ob-f/OpenBot/README.md

<a href="https://www.openbot.org/" target="_blank">
  Banner
</a>

<h1 align="center"><a>Turning Smartphones into Robots</a></h1>

<p align="center">
   </a>
   </a>
   </a>
   </a>
   </a>
   </a>
   </a>
   </a>
</p>

<p align="center">
  <span>English</span> |
  <a href="README.zh-CN.md">简体中文</a> |
  <a href="README.de-DE.md">Deutsch</a> |
  <a href="README.fr-FR.md">Français</a> |
  <a href="README.es-ES.md">Español</a> |
  <a href="README.ko-KR.md">한국어</a>
</p>

OpenBot leverages smartphones as brains for low-cost robots. We have designed a small electric vehicle that costs about $50 and serves as a robot body. Our software stack for Android smartphones supports advanced robotics workloads such as person following and real-time autonomous navigation.

## Get started with OpenBot

- Read the [Disclaimer](DISCLAIMER.md)
- Build your own [Robot Body](body/README.md)
- Flash the [Arduino Firmware](firmware/README.md)
- Install the [Android Apps](robot/android/README.md)
- Drive the robot via a [Controller](controller/README.md)
- Program your robot in the [Playground](open-code/README.md)
- Train your own [Driving Policy](policy/README.md)

## Get the source code

- You can download the repo as a [zip file](https://github.com/ob-f/OpenBot/archive/master.zip) and extract it into a folder of your choice.
- You can clone the OpenBot repository from GitHub with the following command:
    ```bash
    git clone https://github.com/ob-f/OpenBot.git
    ```
- You can fork the OpenBot repository and then clone your local copy. This is recommended, especially if you want to [contribute](CONTRIBUTING.md).
- The robot apps are in `robot/`: `robot/android` (open this folder in Android Studio), `robot/ios` and `robot/linux`.

## Videos

<a href="https://www.youtube.com/watch?v=RbzPXywJifA" >
  youtube video
</a>

<a href="https://www.youtube.com/watch?v=qc8hFLyWDOM" >
  youtube video
</a>

## Cool projects using OpenBot

There are a lot of cool projects using OpenBot already. Below is a small selection. Click on the images to be redirected to the respective projects.

<p float="left">
  <a href="https://www.thingiverse.com/thing:4670884" target="_blank">
    Tank OpenBot
  </a>
  <a href="https://diyrobocars.com/2020/12/14/an-improved-version-of-the-intel-openbot" target="_blank">
    2WD OpenBot
  </a>
  <a href="https://custom-build-robots.com/raspberry-pi-robot-cars/openbot-your-smartphone-controls-a-robot-car-introduction/13860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" target="_blank">
    Cardboard OpenBot
  </a>
  <a href="https://www.youtube.com/watch?v=PEj8jWapGt4" target="_blank">
    Baby Yoda OpenBot
  </a>
</p>

## Contact

- Join our [Slack](https://join.slack.com/t/openbot-community/shared_invite/zt-jl8ygxqt-WNRNi9yzh7Lu60qui6Nh6w) channel to connect with the OpenBot community.
- Contact us via [Email](mailto:openbot.team@gmail.com)

## Contribute

Please read the [contribution guidelines](CONTRIBUTING.md). If you are not sure where to start have a look at the [open issues](https://github.com/ob-f/OpenBot/issues).

## Citation

Please cite our [paper](https://arxiv.org/abs/2008.10631) if you use OpenBot.

```bib
@inproceedings{mueller2021openbot,
    title     = {OpenBot: Turning Smartphones into Robots},
    author    = {M{\"u}ller, Matthias and Koltun, Vladlen},
    booktitle = {Proceedings of the International Conference on Robotics and Automation (ICRA)},
    year = {2021},
}
```

<a href="https://www.openbot.org//" target="_blank">
  Footer
</a>
