ob-f/OpenBot/firmware/README.es-ES.md

# Firmware

<p align="center">
  <a href="README.md">English</a> |
  <a href="README.zh-CN.md">简体中文</a> |
  <a href="README.de-DE.md">Deutsch</a> |
  <a href="README.fr-FR.md">Français</a> |
  <span>Español</span> |
  <a href="README.ko-KR.md">한국어</a>
</p>

Utilizamos una unidad de microcontrolador (MCU) para actuar como un puente entre el cuerpo del robot y el smartphone. Proporcionamos nuestro [firmware](openbot/openbot.ino) para el Arduino Nano con un microcontrolador ATmega328P, así como para el kit de desarrollo ESP32.

## Características

La tarea principal del MCU es manejar el control de bajo nivel del vehículo y proporcionar lecturas de los sensores montados en el vehículo de bajo nivel. El MCU recibe los controles del vehículo y las señales de los indicadores a través de la conexión serial. Convierte los controles en señales PWM para el controlador del motor y activa los LEDs según la señal del indicador. El programa de Arduino también realiza un seguimiento de las rotaciones de las ruedas contando las interrupciones de los sensores ópticos en las ruedas delanteras izquierda y derecha. Calcula el voltaje de la batería mediante un promedio móvil escalado de las mediciones en el circuito divisor de voltaje. También puede medir la distancia a los obstáculos frente al coche con un sensor ultrasónico opcional. Estas mediciones se envían de vuelta a la aplicación de Android a través del enlace serial.

## Configuración

Todos los ajustes están en la sección **SETTINGS** al principio de `openbot.ino`. No necesitas cambiar nada debajo de ella.

Para conservar tus ajustes al actualizar el firmware, copia las líneas de la sección SETTINGS entre `#else` y `#endif` en un archivo nuevo `openbot_settings.h` junto a `openbot.ino` y cámbialas allí. Si `openbot_settings.h` existe, el firmware lo usa en lugar de la sección de `openbot.ino`, y git lo ignora, así que no se sube por error.

### Cuerpo del robot

Ajusta `OPENBOT` a tu cuerpo de robot y selecciona en el Arduino IDE una placa compatible. El firmware detecta la placa; con cualquier otra placa la compilación se detiene con un error.

| Cuerpo | `OPENBOT` | Arduino Nano | ESP32 Dev Module |
|---|---|:---:|:---:|
| Montaje DIY (controlador de motores L298N) | `DIY` | ✓ | ✓ |
| PCB propia V1 / V2 | `PCB_V1` / `PCB_V2` | ✓ | |
| Kit Ready-to-Run, motores TT | `RTR_TT` | ✓ | |
| Kit Ready-to-Run, motores TT, ESP32 | `RTR_TT2` | | ✓ |
| Kit Ready-to-Run, motores 520 | `RTR_520` | | ✓ |
| Camión RC | `RC_CAR` | ✓ | |
| OpenBot Lite | `LITE` | ✓ | |
| Multi Terrain Vehicle | `MTV` | | ✓ |

`DIY_ESP32` se ha sustituido por `DIY` con una placa ESP32 seleccionada.

### Conducción

Por defecto, conduces el robot con la aplicación del teléfono. Para el [modo sin teléfono](#modo-sin-teléfono), ajusta `NO_PHONE_MODE 1`; con un ESP32 también puedes conducir con un [gamepad](#control-con-gamepad) (`HAS_GAMEPAD 1`). `COAST_MODE` define si los motores ruedan libres (1) o frenan (0) cuando no hay control, y `DEBUG 1` muestra información de depuración en el Monitor Serie.

### Componentes

Cada cuerpo activa los componentes que tiene normalmente:

| `OPENBOT` | Componentes activados |
|---|---|
| `DIY`, `PCB_V1`, `PCB_V2` | Divisor de voltaje, intermitentes, sonar, sensores de velocidad delanteros |
| `RTR_TT`, `RTR_TT2`, `RTR_520` | Divisor de voltaje, intermitentes, sonar, parachoques, sensores de velocidad delanteros y traseros, LEDs delanteros, traseros y de estado |
| `LITE` | Intermitentes |
| `RC_CAR` | Ninguno |
| `MTV` | Sensores de velocidad delanteros, centrales y traseros |

En un ESP32 también está activada la conexión Bluetooth con el teléfono.

En los ajustes, cada componente tiene el valor por defecto del cuerpo, p. ej. `#define HAS_SONAR DEFAULT_HAS_SONAR`, y una tabla encima muestra los valores por defecto de cada cuerpo. Para cambiar un componente, ajústalo a `1` (activado) o `0` (desactivado), p. ej. `#define HAS_SONAR 0` si no has instalado el sensor ultrasónico. Un componente activado pero no instalado no causa daños, pero la aplicación muestra lecturas sin sentido, como una distancia de sonar de 300 cm.

| Ajuste | Componente |
|---|---|
| `HAS_VOLTAGE_DIVIDER` | Medición del voltaje de la batería |
| `HAS_INDICATORS` | Intermitentes |
| `HAS_SONAR`, `SONAR_MEDIAN` | Sensor ultrasónico y un filtro de mediana para sus lecturas |
| `HAS_BUMPER` | Parachoques para detectar colisiones |
| `HAS_SPEED_SENSORS_FRONT`, `_BACK`, `_MIDDLE` | Sensores de velocidad de las ruedas |
| `HAS_LEDS_FRONT`, `HAS_LEDS_BACK`, `HAS_LEDS_STATUS` | Luces delanteras, luces traseras y LEDs de estado |
| `HAS_OLED` | Pantalla OLED |
| `HAS_BLUETOOTH` | Conexión Bluetooth con el teléfono (ESP32) |

### Batería

El indicador de batería de la aplicación va de `VOLTAGE_LOW` (vacía) a `VOLTAGE_MAX` (llena). Tienen los valores por defecto del cuerpo; para otra batería, ajústalos en los ajustes, por ejemplo `#define VOLTAGE_LOW 6.8f`:

| Batería | `VOLTAGE_LOW` | `VOLTAGE_MAX` |
|---|---:|---:|
| 2S Li-ion / LiPo | 6.8f | 8.4f |
| 3S Li-ion / LiPo | 10.2f | 12.6f |
| 6 × AA | 6.0f | 9.0f |
| 8 × AA | 8.0f | 12.0f |

Si tu divisor de voltaje es distinto al del cuerpo, ajusta también `VOLTAGE_DIVIDER_FACTOR` a (R1 + R2) / R2. `VOLTAGE_MIN` es el voltaje más bajo al que los motores aún giran; el firmware solo lo usa en el modo sin teléfono.

### Comprobar la configuración

Al arrancar el robot, el Monitor Serie (115200 baudios) muestra el cuerpo y los componentes activados, por ejemplo:

```
OpenBot DIY (ESP32): voltage, indicators, sonar, speed sensors front, Bluetooth
OpenBot settings: openbot_settings.h
```

La segunda línea indica de dónde vienen los ajustes: `openbot_settings.h`, o `openbot.ino` si no hay archivo de ajustes.

Si dos componentes usan el mismo pin, la compilación se detiene con el error "Two parts use the same pin".

### Dependencias

En el Arduino Nano, los sensores de velocidad y el sensor ultrasónico necesitan la biblioteca [PinChangeInterrupt](https://github.com/NicoHood/PinChangeInterrupt); la mayoría de los cuerpos los tienen activados por defecto. El Arduino Nano solo tiene dos pines de interrupción externa (D2 y D3) y D3 es también uno de los seis pines que soportan PWM. Afortunadamente, también tiene tres interrupciones de puerto que cubren todos los pines en el Arduino. Esta biblioteca analiza estas interrupciones de puerto permitiendo que todos los pines del Arduino se usen como interrupciones.

Si has habilitado el OLED, necesitas instalar las bibliotecas [Adafruit_SSD1306](https://github.com/adafruit/Adafruit_SSD1306) y [Adafruit_GFX Library](https://github.com/adafruit/Adafruit-GFX-Library).

Puedes instalar bibliotecas siguiendo estos pasos:

1. Abre el Administrador de Bibliotecas: `Tools` :arrow_right: `Manage Libraries`
2. Ingresa el nombre de la biblioteca en la barra de búsqueda.
3. Selecciona la última versión y haz clic en instalar. Si ya has instalado la biblioteca, se mostrará y podrás actualizarla.

<p float="left">
  
   
</p>

### Nano clon chino (por ejemplo, enlace de EE.UU.)

Es posible que necesites descargar los controladores [WCH340](http://www.wch.cn/product/CH340.html) del fabricante del chip (chino):

- [Windows](http://www.wch.cn/downloads/CH341SER_EXE.html)
- [Linux](http://www.wch.cn/download/CH341SER_LINUX_ZIP.html)
- [Mac](http://www.wch.cn/download/CH341SER_MAC_ZIP.html)

### Kit de desarrollo ESP32

Para instalar la placa ESP32 en tu IDE de Arduino, sigue estas instrucciones:

1. En tu IDE de Arduino, ve a **File> Preferences**:
<p align="center">
  App GUI
</p>

2. Ingresa *https://dl.espressif.com/dl/package_esp32_index.json* en el campo “_Additional Board Manager URLs_” como se muestra en la figura a continuación. Luego, haz clic en el botón “OK”:
<p align="center">
  App GUI
</p>

**Nota:** si ya tienes la URL de las placas ESP8266, puedes separar las URLs con una coma de la siguiente manera:

    https://dl.espressif.com/dl/package_esp32_index.json,
    http://arduino.esp8266.com/stable/package_esp8266com_index.json

3. Abre el Administrador de Placas. Ve a **Tools > Board > Boards Manager**:
<p align="center">
  App GUI
</p>

4. Busca ESP32. Busca “ESP32 by Espressif Systems“ y asegúrate de seleccionar la versión 2.0.17 del menú desplegable. ¡Cualquier versión 3.x.x no funcionará! Haz clic en instalar:
<p align="center">
  App GUI
</p>

5. Ahora deberías tener todo para flashear con éxito la placa ESP32 de tu OpenBot usando el entorno de desarrollo de Arduino.
<p align="center">
  App GUI
</p>

6. Para flashear el OpenBot con tu nuevo código, simplemente selecciona **ESP32 Dev Module** en el menú **Tools > Board > ESP32 Arduino**. Ten en cuenta que contenido adicional, así como la solución de problemas del proceso de flasheo del ESP32, se pueden encontrar en el siguiente [enlace](https://randomnerdtutorials.com/installing-the-esp32-board-in-arduino-ide-windows-instructions/).
<p align="center">
  App GUI
</p>

Si tienes problemas para cargar, intenta reducir la velocidad de baudios. Ve a herramientas y selecciona la velocidad de carga como 115200.
<p align="center">
App GUI
</p>

## Cargar

### Configuración (configuración de Arduino nano)

- `Tools` :arrow_right: `Board` :arrow_right: `Arduino AVR Boards` :arrow_right: `Arduino Nano`
- `Tools` :arrow_right: `Processor` :arrow_right: `ATmega328P (Old Bootloader)`
- `Tools` :arrow_right: `Port` :arrow_right: `*Selecciona el puerto USB*`

:memo: NOTA: Actualmente, la mayoría de las placas Arduino Nano baratas vienen con el _Old Bootloader_. Sin embargo, dependiendo del vendedor, también puedes obtener una con el nuevo bootloader. Así que si no puedes cargar el firmware, es probable que necesites cambiar el procesador a _ATmega328P_.

### Configuración (configuración ESP32)

- `Tools` :arrow_right: `Board` :arrow_right: `ESP32 Arduino` :arrow_right: `ESP32 Dev Module`
- `Tools` :arrow_right: `Port` :arrow_right: `*Selecciona el puerto USB*`

### Cargando el firmware

El firmware ahora se puede cargar a través de `Sketch` :arrow_right: `Upload` o presionando el botón de carga (flecha derecha).
Firmware Upload

### Pruebas

Esta sección explica cómo probar todas las funcionalidades del coche después de que el firmware se haya flasheado con éxito.

1. Confirma que:
   1. las ruedas no están conectadas al coche
   2. el Arduino está conectado a la computadora
   3. el puerto USB correcto está seleccionado
2. Abre el Monitor Serial: `Tools` :arrow_right: `Serial Monitor`

#### Enviando mensajes al OpenBot

También puedes enviar mensajes al Arduino escribiendo un comando en el campo de entrada en la parte superior y luego presionando enviar. Los siguientes comandos están disponibles (siempre que las características necesarias sean compatibles con el robot):

- `c<left>,<right>` donde `<left>` y `<right>` están ambos en el rango [-255,255]. Un valor de `0` detendrá los motores. Un valor de `255` aplica el voltaje máximo conduciendo los motores a la velocidad máxima hacia adelante. Valores más bajos conducen a voltajes y velocidades proporcionalmente más bajos. Valores negativos aplican los voltajes correspondientes en polaridad inversa conduciendo los motores en reversa.
- `i<left>,<right>` donde `<left>` y `<right>` están ambos en el rango [0,1] y corresponden a los LEDs indicadores izquierdo y derecho. Por ejemplo, `i1,0` enciende el indicador izquierdo, `i0,1` el derecho e `i1,1` ambos indicadores. Las luces indicadoras habilitadas parpadearán una vez por segundo. Un valor de `i0,0` apaga los indicadores. Solo es posible un estado a la vez.
- `l<front>,<back>` donde `<front>` y `<back>` están ambos en el rango [0,255] y corresponden al brillo de los LEDs delanteros y traseros.
- `s<time_ms>` donde `<time_ms>` corresponde al tiempo en ms entre mediciones de sonar activadas (por defecto = 1000). Después de que se adquiere la lectura del sonar, el mensaje se envía al robot. Si se agota el tiempo, se envía el `MAX_SONAR_DISTANCE` especificado.
- `w<time_ms>` donde `<time_ms>` corresponde al tiempo en ms entre mediciones de odometría de ruedas enviadas al robot (por defecto = 1000). La velocidad de la rueda se monitorea continuamente y el rpm se calcula como promedio sobre el intervalo de tiempo especificado.
- `v<time_ms>` donde `<time_ms>` corresponde al tiempo en ms entre mediciones de voltaje enviadas al robot (por defecto = 1000). El voltaje se monitorea continuamente y se filtra a través de un filtro de promedio móvil de tamaño 10. Además de establecer el intervalo de tiempo para las lecturas de voltaje, enviar este comando también activará mensajes que informan el voltaje mínimo para conducir los motores (`vmin:<value>`), voltaje mínimo de la batería (`vlow:<value>`) y voltaje máximo de la batería (`vmax:<value>`).
- `h<time_ms>` donde `<time_ms>` corresponde al tiempo en ms después del cual el robot se detendrá si no se recibió un nuevo mensaje de latido (por defecto = -1).
- `b<time_ms>` donde `<time_ms>` corresponde al tiempo en ms después del cual se restablecerá el disparador del parachoques (por defecto = 750).
- `n<color>,<state>` donde `<color>` corresponde a un LED de estado (`b` = azul, `g` = verde, `y` = amarillo) y `state` a su valor (`0` = apagado, `1` = encendido).
- `f` enviará una solicitud al OpenBot para devolver un mensaje con el tipo de robot y sus características, por ejemplo, medición de voltaje (`v`), indicadores (`i`), sonar (`s`), sensores de choque (`b`), odometría de ruedas (`wf`, `wb`), LEDs (`lf`, `lb`, `ls`), etc. Por ejemplo, para la versión `RTR_V1` de OpenBot, el mensaje se vería así: `fRTR_V1:v:i:s:b:wf:wb:lf:lb:ls:`.

#### Recibiendo mensajes del OpenBot

Dependiendo de tu configuración, puedes ver diferentes mensajes.

Serial Monitor

- Los mensajes que comienzan con `v` informan el voltaje de la batería. Si conectas la batería al coche (es decir, enciendes el interruptor), debería mostrar el voltaje de la batería. Si desconectas la batería (es decir, apagas el interruptor), debería mostrar un valor pequeño.
- Los mensajes que comienzan con `w` informan las lecturas de los sensores de velocidad medidas en revoluciones por segundo (rpm). Cada agujero en el disco codificador incrementará un contador en más/menos uno dependiendo de la dirección. Puedes establecer el número de agujeros con el parámetro `DISK_HOLES`. Si estás usando el disco estándar con 20 agujeros, habrá 20 conteos por cada revolución de la rueda.
- Los mensajes que comienzan con `s` informan el espacio libre estimado frente al sensor ultrasónico en cm.
- Los mensajes que comienzan con `b` informan colisiones. Los códigos `lf` (izquierda delantera), `rf` (derecha delantera), `cf` (centro delantero), `lb` (izquierda trasera), `rb` (derecha trasera) indican qué sensor activó la colisión.

#### Procedimiento de prueba

Antes de continuar, asegúrate de que los neumáticos estén removidos. Necesitarás el Monitor Serial abierto para enviar comandos y verás los mensajes recibidos de tu OpenBot. Si tienes la pantalla OLED instalada, también verás el estado del vehículo mostrado allí en un formato más legible para humanos. El siguiente procedimiento de prueba se puede usar para probar todas las funcionalidades del coche:

1. Enciende el coche y observa el voltaje de la batería (el número después de la `v`). Puedes verificar la lectura con un multímetro y ajustar el `VOLTAGE_DIVIDER_FACTOR` si es necesario.
2. Si tienes un sensor ultrasónico instalado:
   1. Sostén tu mano frente al sensor y muévela hacia adelante y hacia atrás. Deberías ver las lecturas (el número después de la `s`) cambiar correspondientemente.
   2. Hemos observado que el sensor ultrasónico es muy sensible a las vibraciones. Por lo tanto, es aconsejable asegurarse de que obtendrás lecturas confiables durante la operación realizando la siguiente prueba:
      1. Coloca el OpenBot con el sensor ultrasónico instalado de manera que haya al menos 200 cm de espacio libre frente a él. Deberías ver una lectura de `200` o más.
      2. Observa las lecturas en el monitor serial por un tiempo y luego ingresa el comando `c128,128`.
      3. Si las lecturas del sensor cambian significativamente, necesitarás amortiguar las vibraciones transmitidas al sensor ultrasónico desde el chasis (por ejemplo, agrega algo de silicona, ajusta la posición de montaje).
3. Si tienes los sensores de velocidad instalados:
   1. Asegúrate de tener mucho espacio libre frente al sensor ultrasónico. La lectura (el número después de la `s`) necesita estar al menos por encima del `STOP_DISTANCE` que es `10` por defecto.
   2. Envía el comando `c128,128`. Los motores comenzarán a girar a _baja velocidad_ (50% PWM). Las lecturas del sensor de velocidad (valores después de la `w`) se informan en rpm y deberían estar entre 250 y 300 para la versión RTR_TT dependiendo del SOC de la batería. Si estás usando la versión DIY o una batería más débil, los valores pueden ser más bajos. Verifica que todos los motores estén girando hacia adelante y que las lecturas del sensor de velocidad sean positivas.
   3. Intenta enviar diferentes controles y observa las lecturas del sensor de velocidad. Por ejemplo, el comando `c-128,-128` hará que todos los motores giren hacia atrás a _baja velocidad_ (50% PWM). El comando `c255,-255` hará que los motores izquierdos giren hacia adelante y los derechos hacia atrás a _alta velocidad_ (100% PWM). El comando `c-192,192` hará que los motores izquierdos giren hacia atrás y los derechos hacia adelante a _velocidad normal_ (75% PWM).
4. Detén los motores enviando el comando `c0,0` o sosteniendo tu mano frente al sensor ultrasónico.
5. Si tienes los LEDs indicadores instalados, envía el comando `i1,0` y observa la luz indicadora izquierda parpadeando. Luego envía el comando `i0,1` y observa la luz indicadora derecha parpadeando. Finalmente, apaga el indicador enviando el comando `i0,0`.

### Modo Sin Teléfono

Antes de probar el coche con un smartphone que tenga la aplicación OpenBot instalada, también puedes probar el coche sin un teléfono primero. Simplemente ajusta `NO_PHONE_MODE 1` en los ajustes. El coche ahora conducirá a _velocidad normal_ (75% PWM) y disminuirá la velocidad a medida que detecte obstáculos con el sensor ultrasónico. Una vez que se acerque al `TURN_THRESHOLD` (por defecto: 50 cm), comenzará a girar en una dirección aleatoria y encenderá el LED en ese lado. Si el espacio libre estimado frente al coche cae por debajo del `TURN_THRESHOLD`, retrocederá lentamente y ambos LEDs se encenderán. Ten en cuenta que tanto el coche como el Arduino necesitan estar alimentados. El Arduino se puede alimentar conectando el pin de 5V a la salida de 5V del controlador de motor L298N, o conectando el cable USB a una fuente de alimentación (por ejemplo, teléfono).

Antes de hacer funcionar el coche, recomendamos quitar los neumáticos, conectar el Arduino a una computadora y observar el monitor serial como en la sección [Pruebas](#testing). La salida en el monitor serial es un poco más fácil de analizar (igual que el OLED) y muestra el voltaje de la batería, el rpm para los motores izquierdo y derecho y el espacio libre estimado frente al coche. Puedes mover un objeto grande hacia adelante y hacia atrás frente al sensor ultrasónico y observar el cambio de velocidad de los motores.

:warning: ADVERTENCIA: Si no tienes un sensor ultrasónico instalado o si está deshabilitado, el coche simplemente avanzará a _velocidad normal_ (75% PWM) y eventualmente colisionará. Incluso con el sensor instalado, el coche puede colisionar ocasionalmente debido a lecturas ruidosas.

### Control con gamepad

En el modo sin teléfono, puedes conducir un cuerpo con ESP32 con un gamepad Bluetooth en lugar de dejar que conduzca solo.

#### Configuración

1. En el Arduino IDE, añade esta URL en **Preferencias > URLs adicionales de gestor de placas**:
   `https://raw.githubusercontent.com/ricardoquesada/esp32-arduino-lib-builder/master/bluepad32_files/package_esp32_bluepad32_index.json`
2. En el gestor de placas, instala **esp32_bluepad32** (4.1.0). Se basa en el mismo núcleo esp32 (2.0.17) que el firmware normal.
3. Selecciona **ESP32 Dev Module** entre las placas esp32_bluepad32.
4. En los ajustes, configura `NO_PHONE_MODE 1` y `HAS_GAMEPAD 1`, y carga el firmware.

El gamepad usa el Bluetooth del ESP32, así que la conexión Bluetooth con el teléfono está desactivada en este modo. Para conducir con la app del teléfono, deja `HAS_GAMEPAD 0` y empareja el gamepad con el teléfono.

#### Emparejamiento

Enciende el robot y pon el gamepad en modo de emparejamiento. Se conecta en pocos segundos y, a partir de entonces, se vuelve a conectar cada vez que lo enciendes. Para emparejar otro gamepad, apaga primero el conectado: solo conduce un gamepad a la vez.

| Gamepad | Modo de emparejamiento |
|---|---|
| PS5 DualSense | Mantén **Create** y luego mantén **PS** hasta que la barra de luz parpadee. |
| PS4 DualShock 4 | Mantén **Share** y luego mantén **PS** hasta que la barra de luz parpadee. |
| Xbox Wireless (modelo 1708 o posterior) | Enciéndelo y mantén el botón de emparejamiento 3 s. Antes, actualiza el firmware del mando a la versión 5.15 o posterior (p. ej., con la app Accesorios de Xbox). |
| Switch Pro, Joy-Con, 8BitDo y otros | Usa el modo de emparejamiento Bluetooth del gamepad (consulta su manual). |

La [lista de gamepads compatibles de Bluepad32](https://bluepad32.readthedocs.io/en/latest/supported_gamepads/) incluye más modelos, entre ellos el PS3 DualShock 3, que necesita configuración adicional. Con `DEBUG 1`, el monitor serie muestra el nombre de cada gamepad que se conecta.

#### Controles

Los botones se indican como PlayStation / Xbox.

| Control | Acción |
|---|---|
| **R2 / L2** | Adelante / atrás (modo juego) |
| **Stick izquierdo** | Girar (modo juego), avanzar y girar (modo joystick) o lado izquierdo (modo dual) |
| **Stick derecho** | Lado derecho (modo dual) |
| **L1** | Siguiente modo de conducción: juego → joystick → dual. El gamepad vibra una vez: corto para juego, más largo para joystick y más largo aún para dual. |
| **Cruceta arriba / R3** | Más rápido |
| **Cruceta abajo / L3** | Más lento |
| **Cuadrado / X** | Intermitente izquierdo sí o no |
| **Círculo / B** | Intermitente derecho sí o no |
| **Triángulo / Y** | Intermitentes apagados |
| **Equis / A** | Luces sí o no |
| **Start** | Explorar sí o no |
| **Select / Back** | Parada ante obstáculos sí o no |

Con Start y Select, una vibración larga significa activado y una corta, desactivado.

**Modos de conducción.** El gamepad empieza en el modo fijado por `GAMEPAD_DRIVE_MODE` (por defecto: juego).
- **Juego:** R2 avanza, L2 retrocede y el stick izquierdo gira. Al dar marcha atrás, la dirección se invierte, como en un coche.
- **Joystick:** el stick izquierdo avanza y gira. El robot siempre gira hacia donde apunta el stick, también marcha atrás.
- **Dual:** cada stick mueve un lado, como un tanque.

**Velocidades.** Hay tres velocidades: lenta (50 %), normal (75 %, la velocidad inicial) y rápida (100 %). El gamepad muestra la velocidad con sus LED de jugador (de uno a tres) o su barra de luz (verde, naranja, rojo).

**Explorar.** Explorar es la conducción del modo sin teléfono descrita arriba: el robot se mueve solo y esquiva obstáculos. Está desactivado al arrancar; pulsa **Start** para activarlo. Con explorar activado, al mover un stick o gatillo tomas el control. Al soltarlos, el robot se detiene un momento y sigue explorando. Explorar necesita un sensor sonar conectado y `HAS_SONAR 1`; sin él, el robot simplemente avanza en línea recta (consulta la advertencia de arriba).

**Parada ante obstáculos.** Mientras conduces con el gamepad, el robot no avanza si el sonar detecta un obstáculo a menos de `STOP_DISTANCE`. Está activada al arrancar; pulsa **Select** para desactivarla, por ejemplo para empujar algo. Solo funciona con un sensor sonar conectado y `HAS_SONAR 1`; si no, el robot nunca se detiene ante obstáculos.

**Seguridad.** El robot se detiene cuando el gamepad se desconecta. La mayoría de los gamepads además envían datos continuamente; si uno de ellos deja de enviar durante 0,5 s (fuera de alcance, batería agotada), el robot se detiene de inmediato en lugar de esperar a la desconexión.

## Usando otros MCUs (requisitos)

Puedes usar cualquier otro MCU con las siguientes características:

- 1x USB-to-TTL Serial (comunicación con el smartphone)
- 4x salida PWM (controlar los motores)
- 1x pin analógico para monitoreo de batería
- 2x pin digital para los sensores de velocidad
- 1x pin digital para el sensor ultrasónico (opcional)
- 2x pin digital para los LEDs indicadores (opcional)

## Siguiente

Compila y ejecuta la [Aplicación Android](../robot/android/README.es-ES.md)
