ob-f/OpenBot/body/mtv/README.md

# OpenBot: Multi-Terrain Vehicle (MTV) body

<p align="center">
  <span>English</span> |
  <a href="README.zh-CN.md">简体中文</a> |
  <a href="README.de-DE.md">Deutsch</a> |
  <a href="README.fr-FR.md">Français</a> |
  <a href="README.es-ES.md">Español</a> |
  <a href="README.ko-KR.md">한국어</a>
</p>

We here propose an all-terrain alternative to the original [OpenBot](https://www.openbot.org/) vehicle. Developed in collaboration with **Ivy Tech LTD**, the Multi-Terrain Vehicle (MTV) is also based on inexpensive and easily printable components. The MTV is inspired by several exploration vehicle concepts developed over the past decades for lunar and Martian exploration. The MTV is designed around a set of 6 actuated wheels, organized in a Rocker-Bogie configuration. Unlike most lunar or Martian rovers, the wheels cannot rotate radially. The vehicle therefore operates in the same way as a tank, which makes manual control rather intuitive.

<p align="center">
  App GUI
</p>

## I. 3D printing

You will need to print the following parts in order to build your OpenBot MTV.

<p align="center">
  App GUI
</p>

<table>
    <thead>
        <tr>
            <th>ID </th>
            <th>Group</th>
            <th>Item Name</th>
            <th>Quantity</th>
            <th>Picture (not to scale)</th>
            <th>Material</th>
            <th>Duration</th>
            <th>Cost</th>
        </tr>
    </thead>
    <tbody>
        <tr>
            <td>A1</td>
            <td rowspan=3>Motor assembly</td>
            <td>Motor Enclosure Top <br> (<a href="cad/MotorAssembly/MotorEnclosure_Top.stl">STL</a>, <a href="cad/MotorAssembly/MotorEnclosure_Top.step">STEP</a>) </td>
            <td>6</td>
            <td><p align="center"> App GUI</p></td>
            <td rowspan=2>498g</td>
            <td rowspan=2>36h</td>
            <td rowspan=2>€23.51</td>
        </tr>
        <tr>
            <td>A2</td>
            <td>Motor Enclousre Bottom <br> (<a href="cad/MotorAssembly/MotorEnclosure_Bottom.stl">STL</a>, <a href="cad/MotorAssembly/MotorEnclosure_Bottom.step">STEP</a>) </td>
            <td>6</td>
            <td><p align="center"> App GUI</p></td>
        </tr>
        <tr>
            <td>A3</td>
            <td>Motor Bracket <br> (<a href="cad/MotorAssembly/Motor_Bracket.stl">STL</a>, <a href="cad/MotorAssembly/Motor_Bracket.step">STEP</a>) </td>
            <td>6</td>
            <td><p align="center"> App GUI</p></td>
            <td>251g</td>
            <td>17.5h</td>
            <td>€11.98</td>
        </tr>
        <tr>
            <td>A4</td>
            <td rowspan=4>Joints</td>
            <td>90 deg Joint <br> (<a href="cad/Joints/90deg_Joint.stl">STL</a>, <a href="cad/Joints/90deg_Joint.step">STEP</a>) </td>
            <td>2</td>
            <td><p align="center"> App GUI</p></td>
            <td rowspan=4>228g</td>
            <td rowspan=4>20.5h</td>
            <td rowspan=4>€15.05</td>
        </tr>
        <tr>
            <td>A5</td>
            <td>100 deg Joint <br> (<a href="cad/Joints/100deg_Joint.stl">STL</a>, <a href="cad/Joints/100deg_Joint.step">STEP</a>) </td>
            <td>1</td>
            <td><p align="center"> App GUI</p></td>
        </tr>
        <tr>
            <td>A6</td>
            <td>100 deg Joint Mirror <br> (<a href="cad/Joints/100deg_Joint_Mirror.stl">STL</a>, <a href="cad/Joints/100deg_Joint_Mirror.step">STEP</a>) </td>
            <td>1</td>
            <td><p align="center"> App GUI</p></td>
        </tr>
        <tr>
            <td>A7</td>
            <td>End Joint <br> (<a href="cad/Joints/End_Joint.stl">STL</a>, <a href="cad/Joints/End_Joint.step">STEP</a>) </td>
            <td>2</td>
            <td><p align="center"> App GUI</p></td>
        </tr>
        <tr>
            <td>A8</td>
            <td rowspan=3>Legs</td>
            <td>Front Leg <br> (<a href="cad/Legs/Front_Leg.stl">STL</a>, <a href="cad/Legs/Front_Leg.step">STEP</a>) </td>
            <td>4</td>
            <td><p align="center"> App GUI</p></td>
            <td rowspan=3>317g</td>
            <td rowspan=3>22.5h</td>
            <td rowspan=3>€14.97</td>
        </tr>
        <tr>
            <td>A9</td>
            <td>Mid Leg <br> (<a href="cad/Legs/Mid_Leg.stl">STL</a>, <a href="cad/Legs/Mid_Leg.step">STEP</a>) </td>
            <td>2</td>
            <td><p align="center"> App GUI</p></td>
        </tr>
        <tr>
            <td>A10</td>
            <td>Rear Leg <br> (<a href="cad/Legs/Rear_Leg.stl">STL</a>, <a href="cad/Legs/Rear_Leg.step">STEP</a>) </td>
            <td>2</td>
            <td><p align="center"> App GUI</p></td>
        </tr>
        <tr>
            <td>A11</td>
            <td>Bearing Cover</td>
            <td>Bearing Cover <br> (<a href="cad/BearingCover/BearingCover.stl">STL</a>, <a href="cad/BearingCover/BearingCover.step">STEP</a>) </td>
            <td>4</td>
            <td><p align="center"> App GUI</p></td>
            <td>13g</td>
            <td>1.5h</td>
            <td>€0.60</td>
        </tr>
        <tr>
            <td>A12</td>
            <td>Phone Mount Platform</td>
            <td>Phone Mount Platform <br> (<a href="cad/PhoneMount/Phone_Mount.stl">STL</a>, <a href="cad/PhoneMount/Phone_Mount.step">STEP</a>) </td>
            <td>1</td>
            <td><p align="center"> App GUI</p></td>
            <td>19g</td>
            <td>2h</td>
            <td>€0.91</td>
        </tr>
        <tr>
            <td>A13</td>
            <td rowspan=4>Front Buffer</td>
            <td>Name Front <br> (<a href="cad/Buffer/Name_Front.stl">STL</a>, <a href="cad/Buffer/Name_Front.step">STEP</a>) </td>
            <td>1</td>
            <td><p align="center"> App GUI</p></td>
            <td rowspan=4>228g</td>
            <td rowspan=4>20.5h</td>
            <td rowspan=4>€15.04</td>
        </tr>
        <tr>
            <td>A14</td>
            <td>Name Back <br> (<a href="cad/Buffer/Name_Back.stl">STL</a>, <a href="cad/Buffer/Name_Back.step">STEP</a>) </td>
            <td>1</td>
            <td><p align="center"> App GUI</p></td>
        </tr>
        <tr>
            <td>A15</td>
            <td>Buffer Left <br> (<a href="cad/Buffer/Buffer_Left.stl">STL</a>, <a href="cad/Buffer/Buffer_Left.step">STEP</a>) </td>
            <td>1</td>
            <td><p align="center"> App GUI</p></td>
        </tr>
        <tr>
            <td>A16</td>
            <td>Buffer Right <br> (<a href="cad/Buffer/Buffer_Right.stl">STL</a>, <a href="cad/Buffer/Buffer_Right.step">STEP</a>) </td>
            <td>1</td>
            <td><p align="center"> App GUI</p></td>
        </tr>
        <tr>
            <td>A17</td>
            <td rowspan=8>Compartment </td>
            <td>Compartment Rear <br> (<a href="cad/Compartment/Compartment_Rear.stl">STL</a>, <a href="cad/Compartment/Compartment_Rear.step">STEP</a>) </td>
            <td>1</td>
            <td><p align="center"> App GUI</p></td>
            <td>413g</td>
            <td>32h</td>
            <td>€22.75</td>
        </tr>
        <tr>
            <td>A18</td>
            <td>Compartment Front <br> (<a href="cad/Compartment/Compartment_Front.stl">STL</a>, <a href="cad/Compartment/Compartment_Front.step">STEP</a>) </td>
            <td>1</td>
            <td><p align="center"> App GUI</p></td>
            <td>316g</td>
            <td>22h</td>
            <td>€17.42</td>
        </tr>
        <tr>
            <td>A19</td>
            <td>Roof Front <br> (<a href="cad/Compartment/Roof_Front.stl">STL</a>, <a href="cad/Compartment/Roof_Front.step">STEP</a>) </td>
            <td>1</td>
            <td><p align="center"> App GUI</p></td>
            <td>58g</td>
            <td>5.5h</td>
            <td>€3.19</td>
        </tr>
        <tr>
            <td>A20</td>
            <td>Roof Rear <br> (<a href="cad/Compartment/Roof_Rear.stl">STL</a>, <a href="cad/Compartment/Roof_Rear.step">STEP</a>) </td>
            <td>1</td>
            <td><p align="center"> App GUI</p></td>
            <td>140g</td>
            <td>13.5h</td>
            <td>€7.73</td>
        </tr>
        <tr>
            <td>A21ab</td>
            <td>Battery Mount P1 & P2 <br> (<a href="cad/Compartment/Compartment_Battery_Mount-P1.stl">STL</a>, <a href="cad/Compartment/Compartment_Battery_Mount-P1.step">STEP</a>)
            <br> (<a href="cad/Compartment/Compartment_Battery_Mount-P2.stl">STL</a>, <a href="cad/Compartment/Compartment_Battery_Mount-P2.step">STEP</a>) </td>
            <td>1</td>
            <td><p align="center"> App GUI</p></td>
            <td>15g</td>
            <td>1.5h</td>
            <td>€0.80</td>
        </tr>
        <tr>
            <td>A22</td>
            <td>Light End Caps <br> (<a href="cad/Compartment/Headlight_Rear.stl">STL</a>, <a href="cad/Compartment/Headlight_Rear.step">STEP</a>)</td>
            <td>4</td>
            <td><p align="center"> App GUI</p></td>
            <td rowspan=3>47g</td>
            <td rowspan=3>4h</td>
            <td rowspan=3>€2.58</td>
        </tr>
        <tr>
            <td>A23</td>
            <td>Head Light <br> (<a href="cad/Compartment/Headlight_Front.stl">STL</a>, <a href="cad/Compartment/Headlight_Front.step">STEP</a>)</td>
            <td>4</td>
            <td><p align="center"> App GUI</p></td>
        </tr>
        <tr>
            <td>A24</td>
            <td>Battery Access Lid <br> (<a href="cad/Compartment/Compartment_Door.stl">STL</a>, <a href="cad/Compartment/Compartment_Door.step">STEP</a>)</td>
            <td>1</td>
            <td><p align="center"> App GUI</p></td>
        </tr>
    </tbody>
</table>

For the above parts, your build plate needs to be at least 240mmx150mm.

On an Ultimaker S5, we achieved good results with the following settings:

- layer height: 0.2mm
- wall thickness: 1.5mm
- infill density: 20%
- infill pattern: grid
- print speed 80 mm/s
- no support

## II. Electro-Mechanical Assembly

### II.1. Bill of materials

Our robot body relies on readily available hobby electronics. We provide links for Germany (EU) and the United States (US) with fast shipping. If you have the patience to wait a bit longer, you can also get the components a lot cheaper from AliExpress (AE). You will need the following components.

<table>
    <thead>
        <tr>
            <th>ID </th>
            <th>Description</th>
            <th>Picture</th>
            <th>Supplier</th>
            <th>Unit Price</th>
            <th>Quantity</th>
            <th>Cost</th>
        </tr>
    </thead>
    <tbody>
        <tr>
            <td>O1</td>
            <td>JGB37-520 DC-Motor with encoders - 12V | 178RPM </td>
            <td><p align="center"> App GUI</p></td>
            <td>  <a href="https://de.aliexpress.com/item/4001339371886.html?gatewayAdapt=glo2deu&spm=a2g0s.9042311.0.0.1fe54c4dR1WTdj/">AE</a></td>
            <td>$8.93 | €8.12</td>
            <td>6</td>
            <td>$53.58 | €48.72</td>
        </tr>
        <tr>
            <td>O2</td>
            <td>2.8" Talon Tires (2 pcs)</td>
            <td><p align="center"> App GUI</p></td>
            <td> <a href="https://www.robotshop.com/en/28-talon-tires-pair.html">US</a> | <a href="https://www.robotshop.com/eu/en/28-talon-tires-pair.html">EU</a></td>
            <td>$26.95 | €23.06</td>
            <td>6</td>
            <td>$161.7 | €138.36</td>
        </tr>
        <tr>
            <td>O3</td>
            <td>7-Core Cable 0.5 mm² (5m)</td>
            <td><p align="center"> App GUI</p></td>
          <td>  <a href="https://www.amazon.com/Heavy-Gauge-Conductor-Trailer-Cable/dp/B01N3Q0YGS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">US</a> | <a href="https://www.amazon.de/-/en/1119757-Classic-Control-Protective-Conductor/dp/B08CY2WPM4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">EU</a></td>
            <td> $25.53 | €20.61</td>
            <td>0.25</td>
            <td>$6.38 | €5.15</td>
        </tr>
        <tr>
            <td>O4</td>
            <td>D-Line cable duct. 20mm x 10mm x 1m (2 pcs)</td>
            <td><p align="center"> App GUI</p></td>
            <td>  <a href="https://www.amazon.com/D-Line-Raceway-1D3015W-Electrical-Paintable/dp/B07KFNYR7G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">US</a> | <a href="https://www.amazon.de/-/en/D-Line-Micro-Cable-Management-Strip-White/dp/B082WVQXT5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">EU</a></td>
            <td>$12.00 | €9.99</td>
            <td>1</td>
            <td>$12.00 | €9.99</td>
        </tr>
        <tr>
            <td>O5</td>
            <td>PG7 Cable Gland 3~6.5mm (50 pcs)</td>
            <td><p align="center"> App GUI</p></td>
          <td>  <a href="https://www.amazon.com/ARTGEAR-Waterproof-Adjustable-Connector-Protector/dp/B07JH2LPZF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"> US </a> | <a href="https://www.amazon.de/-/en/Plastic-Adjustable-Waterproof-Connection-Diameter/dp/B08Q458H3N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">EU</a></td>
            <td>$8.99 | €9.99</td>
            <td>0.5</td>
            <td>$4.49 | €4.99</td>
        </tr>
        <tr>
            <td>O6</td>
            <td>MR126ZZ Ball Bearings 6x12x4mm (4 pcs)</td>
            <td><p align="center"> App GUI</p></td>
            <td>  <a href="https://de.aliexpress.com/item/1005001697683913.html?gatewayAdapt=glo2deu&spm=a2g0s.9042311.0.0.1fe54c4dR1WTdj">AE</a></td>
            <td>$5.52 | €3.45</td>
            <td>1</td>
            <td>$5.52 | €3.45</td>
        </tr>
        <tr>
            <td>O7</td>
            <td>INJORA 90mm RC Car Spring Shock Absorber (2pcs)</td>
            <td><p align="center"> App GUI</p></td>
            <td>  <a href="https://de.aliexpress.com/item/4000309686709.html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">AE</a></td>
            <td>$8.30 | €7.99</td>
            <td>1</td>
            <td>$8.30 | €7.99</td>
        </tr>
        <tr>
            <td>O8</td>
            <td>AXSPEED RC Car LED 4.2v-6v White 17mm (2 pcs)</td>
            <td><p align="center"> App GUI</p></td>
            <td>  <a href="https://www.aliexpress.com/item/1005003306484898.html?spm=a2g0s.9042311.0.0.d4954c4dpsjiiC">AE</a></td>
            <td>$7.43 | €6.87</td>
            <td>1</td>
            <td>$7.43 | €6.87</td>
        </tr>
        <tr>
            <td>O9</td>
            <td>AXSPEED RC Car LED 4.2v-6v Red 17mm (2 pcs)</td>
            <td><p align="center"> App GUI</p></td>
            <td>  <a href="https://www.aliexpress.com/item/1005003306484898.html?spm=a2g0s.9042311.0.0.d4954c4dpsjiiC">AE</a></td>
            <td>$7.43 | €6.87</td>
            <td>1</td>
            <td>$7.43 | €6.87</td>
        </tr>
        <tr>
            <td>O10</td>
            <td>Vibration Isolators M3 x 8mm Studs (4 pcs)</td>
            <td><p align="center"> App GUI</p></td>
            <td>  <a href="https://www.amazon.com/MroMax-Rubber-Vibration-Isolator-Absorber/dp/B07Z76J5N5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">US</a> | <a href="https://www.amazon.de/-/en/gp/product/B076SSPHP6/ref=ppx_yo_dt_b_asin_title_o03_s01?ie=UTF8&psc=1">EU</a></td>
            <td>$8.09 | €9.49</td>
            <td>1</td>
            <td>$8.09 | €9.49</td>
        </tr>
        <tr>
            <td>O11</td>
            <td>Zeadio Universal Smartphone holder</td>
            <td><p align="center"> App GUI</p></td>
            <td> <a href="https://www.amazon.com/SharingMoment-Smartphone-Horizontal-Rotatable-Adjustable/dp/B07S8TTH34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">US</a> | <a href="https://www.amazon.de/-/en/Zeadio-Smartphone-Tripod-Adapter-Mobile/dp/B06XDYJNSR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">EU</a></td>
            <td>$11.99 | €10.99</td>
            <td>1</td>
            <td>$11.99 | €10.99</td>
        </tr>
        <tr>
            <td>O12</td>
            <td>DC 12-24 V Car Voltmeter</td>
            <td><p align="center"> App GUI</p></td>
            <td>  <a href="https://www.amazon.com/Nilight-Voltmeter-Waterproof-VoltVolt-Motorcycle/dp/B06ZZJ48VQ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">US</a> | <a href="https://www.amazon.de/-/en/Intckwan-Digital-Voltmeter-Waterproof-Motorcycle/dp/B09T5XRYM9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">EU</a></td>
            <td>$10.99 | €11.88</td>
            <td>1</td>
            <td>$10.99 | €11.88</td>
        </tr>
        <tr>
            <td>O13</td>
            <td>Mini Rocker Switch (20 pcs)</td>
            <td><p align="center"> App GUI</p></td>
            <td>  <a href="https://www.amazon.com/DaierTek-250VAC-Rocker-KCD1-101-Plastic/dp/B07S2QJKTX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">US</a> | <a href="https://www.amazon.de/-/en/RUNCCI-Rocker-Switches-Household-Appliances/dp/B07MW92CW8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">EU</a></td>
            <td>$15.98 | €9.44</td>
            <td>0.15</td>
            <td>$2.4 | €1.42</td>
        </tr>
        <tr>
            <td>O14</td>
            <td>Duttek Micro USB Panel Mount Cable</td>
            <td><p align="center"> App GUI</p></td>
            <td>  <a href="https://www.amazon.com/Duttek-Angled-Extension-Motorcycle-Dashboard/dp/B08RSGYV1S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">US</a> | <a href="https://www.amazon.de/-/en/Duttek-Degree-Extension-Motorcycle-Dashboard/dp/B08RSGYV1S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">EU</a></td>
            <td>$10.68 | €11.44</td>
            <td>1</td>
            <td>$10.68 | €11.44</td>
        </tr>
        <tr>
            <td>O15</td>
            <td>Custom PCB</td>
            <td><p align="center"> App GUI</p></td>
            <td>  <a href="https://www.eurocircuits.de/">US</a> | <a href="https://www.eurocircuits.de/">EU</a></td>
            <td>$10.00 | €10.00</td>
            <td>1</td>
            <td>$10.00 | €10.00</td>
        </tr>
        <tr>
            <td>O16</td>
            <td>Cytron 30A 5-30V Single Brushed DC Motor Driver</td>
            <td><p align="center"> App GUI</p></td>
            <td>  <a href="https://www.robotshop.com/en/cytron-30a-5-30v-single-brushed-dc-motor-driver.html">US</a> | <a href="https://www.robotshop.com/eu/en/cytron-30a-5-30v-single-brushed-dc-motor-driver.html">EU </a></td>
            <td>$34.38 | €37.15</td>
            <td>2</td>
            <td>$68.76 | €74.30</td>
        </tr>
        <tr>
            <td>O17</td>
            <td>LM2596S DC-DC Converter 12V-36V to 5V | 2A (4 pcs)</td>
            <td><p align="center"> App GUI</p></td>
            <td>  <a href="https://www.amazon.com/Adjustable-Converter-Step-Down-Regulator-Stabilizer/dp/B081N6WWJS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">US</a> | <a href="https://www.amazon.de/-/en/adjustable-converter-regulator-stabiliser-voltmeter/dp/B081N6WWJS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">EU</a></td>
            <td>$15.99 | €16.99</td>
            <td>0.25</td>
            <td>$3.99 | €4.25</td>
        </tr>
        <tr>
            <td>O18</td>
            <td>4500mAh 3S-25C 11.1V LiPo Battery in Hard Case</td>
            <td><p align="center"> App GUI</p></td>
            <td>  <a href="https://www.amazon.com/HRB-50C-100C-Quadcopter-Helicopter-Airplane/dp/B06XNTHQRZ?ref_=ast_sto_dp&th=1&psc=1">US</a> | <a href="https://www.amazon.de/-/en/Roaring-Battery-Deans-Connection-Aeroplane/dp/B08Z3JYK1X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">EU</a></td>
            <td>$46.99 | €29.97</td>
            <td>1</td>
            <td>$46.99 | €29.97</td>
        </tr>
        <tr>
            <td>O19</td>
            <td>AITRIP ESP32-DevKitC Development Board (3 pcs)</td>
            <td><p align="center"> App GUI</p></td>
            <td>  <a href="https://www.amazon.com/Development-Microcontroller-Integrated-Antenna-Amplifiers/dp/B09GK74F7N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">US</a> | <a href="https://www.amazon.de/-/en/DevKitC-Development-ESP32-WROOM-32D-Bluetooth-Arduino/dp/B09LS6SCF7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">EU</a></td>
            <td>$19.99 | €21.00</td>
            <td>0.33</td>
            <td>$6.66 | €7.00</td>
        </tr>
        <tr>
            <td>O20</td>
            <td>5.08mm PCB Terminal Block (11 x 2 Pin + 11 x 4 Pin)</td>
            <td><p align="center"> App GUI</p></td>
            <td>  <a href="https://www.amazon.com/LuoQiuFa10-4-Pin-5-08mm-Female-Terminal/dp/B093DNBV5D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">US</a> | <a href="https://www.amazon.de/-/en/Cococity-Pairs-Terminal-Connector-Pluggable/dp/B083GNB8BY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">EU</a></td>
            <td>$7.99 | €11.99</td>
            <td>1</td>
            <td>$7.99 | €11.99</td>
        </tr>
        <tr>
            <td>O21</td>
            <td>M6 x 1m (1000mm) Zinc Plated Threaded Rod/Bar</td>
            <td><p align="center"> App GUI</p></td>
            <td>  <a href="https://www.amazon.com/Threaded-Plated-Thread-Length-Threads/dp/B00G3QM076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">US</a> | <a href="https://www.amazon.de/-/en/Threaded-quality-galvanised-standard-parts/dp/B07X3LX6RX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">EU</a></td>
            <td>$22.73 | €4.31</td>
            <td>1</td>
            <td>$22.73 | €4.31</td>
        </tr>
        <tr>
            <td>O23</td>
            <td>M4 x 50mm screws (30 pcs)</td>
            <td><p align="center"> App GUI</p></td>
            <td>  <a href="https://www.amazon.com/MroMax-M4x50mm-Machine-Stainless-Phillips/dp/B07ZPSWW24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">US</a> | <a href="https://www.amazon.de/-/en/M4-50-stainless-cylinder-DIN912/dp/B07YW6Q5VT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">EU</a></td>
            <td>$11.39 | €9.83</td>
            <td>1</td>
            <td>$11.39 | €9.83</td>
        </tr>
        <tr>
            <td>O24</td>
            <td>M4 x 40mm screws (30 pcs)</td>
            <td><p align="center"> App GUI</p></td>
            <td>  <a href="https://www.amazon.com/Uxcell-a15111200ux1682-Cabinet-Handles-Phillips/dp/B019ZESG9I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">US</a> | <a href="https://www.amazon.de/-/en/M4-50-stainless-cylinder-DIN912/dp/B07YWDJS99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">EU</a></td>
            <td>$10.56 | €9.13</td>
            <td>1</td>
            <td>$10.56 | €9.13</td>
        </tr>
        <tr>
            <td>O25</td>
            <td>M3 screws and nuts sets (440 pcs)</td>
            <td><p align="center"> App GUI</p></td>
            <td>  <a href="https://www.amazon.com/Shapenty-100PCS-Stainless-Female-Fastener/dp/B071NLDW56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">US</a> | <a href="https://www.amazon.de/-/en/pieces-screws-stainless-hexagon-socket/dp/B093GNHWKR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">EU</a></td>
            <td>$6.49 | €11.99</td>
            <td>1</td>
            <td>$6.49 | €11.99</td>
        </tr>
        <tr>
            <td>O26</td>
            <td>M4 x 120mm screws (15 pcs)</td>
            <td><p align="center"> App GUI</p></td>
            <td> <a href="https://www.amazon.com/XunLiu-Socket-Screws-Wrench-Knurled/dp/B07CHJ7ZPP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">US</a> | <a href="https://www.amazon.de/-/en/sourcing-Phillips-Furniture-Hanging-External/dp/B08JYCP7TD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">EU</a></td>
            <td>$15.29 | €15.64</td>
            <td>1</td>
            <td>$15.29 | €15.64</td>
        </tr>
        <tr>
            <td>O27</td>
            <td>M6 x 100mm screws (2 pcs)</td>
            <td><p align="center"> App GUI</p></td>
            <td>  <a href="https://www.amazon.com/MroMax-Machine-Stainless-Phillips-Cabinet/dp/B07YFMN8FP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">US</a> | <a href="https://www.amazon.de/-/en/AG-BOX%C2%AE-Cylinder-Screws-Stainless-Steel/dp/B09N3DNDZK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">EU</a></td>
            <td>$3.84 | €4.18</td>
            <td>1</td>
            <td>$3.84 | €4.18</td>
        </tr>
        <tr>
            <td>O28</td>
            <td>Assorted Nuts (Full and Self Locking) and Washers M3, M4 & M5 (45 pcs)</td>
            <td><p align="center"> App GUI</p></td>
            <td> <a href="https://www.amazon.com/Assortment-AETTL-Stainless-Assorted-Wrenches/dp/B098ND1GW8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">US</a> |  <a href="https://www.amazon.de/-/en/Assorted-Locking-Washers-Stainless-Steel/dp/B01CO9S1RI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">EU</a></td>
            <td>$25.64 | €23.01</td>
            <td>1</td>
            <td>$25.64 | €23.01</td>
        </tr>
        <tr>
            <td>O29</td>
            <td>M6 Nuts/Washers Set (40 pcs)</td>
            <td><p align="center"> App GUI</p></td>
            <td>  <a href="https://www.amazon.com/Stainless-Washer-Machine-Thread-Assortment/dp/B09HNJBX1G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">US</a> | <a href="https://www.amazon.de/-/en/40-Piece-Washers-Threaded-Stainless-Steel/dp/B01G77C0DY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">EU</a></td>
            <td>$13.99 | €8.99</td>
            <td>1</td>
            <td>€$13.99 | €8.99</td>
        </tr>
      <tr>
            <td>O30</td>
            <td>Stainless Steel Flat and Spring Washers Assortment </td>
            <td><p align="center"> App GUI</p></td>
            <td>  <a href="https://www.amazon.com/Split-Washer-Assortment-Stainless-Silver/dp/B08QN3ZR23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">US</a> | <a href="https://www.amazon.de/-/en/300-pieces-Stainless-Washers-Assortment-M2-M3-M4-M5-M6/dp/B07CQX6NPP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">EU</a></td>
            <td>$12.49 | €10.38</td>
            <td>1</td>
            <td>€$12.49 | €10.38</td>
        </tr>
    </tbody>
</table>

The total cost of the externally sourced components is estimated to around **500€**, therefore resulting in a total cost of around **600€** by MTV.

### II.2. Mechanical Assembly

#### II.2.1. Overview

This chapter covers the assembly process of the MTV. Note that left and right are the port and starboard sides of the robot and will be used interchangeably in this document. Unless stated otherwise, all bolts are assumed to have flat washers to protect the 3D printed plastic. It should moreover be emphasized that the use of spring washers and nylocs usually allows preventing any loosening of the nuts due to vibrations. 

The assembly process of the MTV can be divided into seven main steps, namely:
1. assembly of the the 6 motor modules
2. assembly of the legs
3. assembly of the chassis
4. assembly of the main compartment 
5. assembly of the vehicle
6. assembly of the power unit, control unit and connection of the different components
7. Testing, programming and use. 

<p align="center">
  App GUI
</p>

#### II.2.2. Assembly of the the motor modules

Each of the motor modules consist of the following parts:

- 1 x 3D-printed <a href="cad/MotorAssembly/MotorEnclosure_Top.stl">Motor Enclosure Top</a> (A1)
- 1 x 3D-printed <a href="cad/MotorAssembly/MotorEnclosure_Bottom.stl">Motor Enclousre Bottom</a> (A2)
- 1 x 3D-printed <a href="cad/MotorAssembly/Motor_Bracket.stl">Motor Bracket</a> (A3)
- 1 x JGB37-520 DC-Motor with encoders and wheel adapter (O1)
- 1 x PG7 Cable Gland (O5)

To assemble a motor module:

1. Start by connecting the control cable provided in the kit (O1) to the motor. It is strongly recommended to secure this connection with a bit of hot glue. 
2. Carefully align the motor fixture pattern with the 3D-printed motor housing (A1) hole pattern. Make sure not to apply any force onto the encoder, to avoid damaging it. Screw the motor to the 3D-printed motor housing (A1), using the screws provided in the kit (O1). 
3. Fix the coupling sleeve from the kit (01) to the motor shaft with the supplied allen key. Keep the nut that secures the wheel to the coupling sleeve safely screwed in the hex hub as you will later need this when attaching the tires (O2) to the vehicle.  
4. Slot in the Motor bracket (A3) over the motor enclosure top (A1). This is a push fit, and may require some careful alignment when sliding. Note that the shoulder of the Motor bracket (as shown in figure below) should be facing towards the side of the motor shaft for a cleaner assembly. Make sure the Motor bracket (A3) has a tight fit with motor enclosure top (A1). Secure the assembly with hot glue or super glue.  
5. Add the cable glands joints (O5) to the motor enclosure bottom (A2) and run the motor wire thought the gland.
6. Carefully slot in the motor enclosure bottom (A2) onto the motor enclosure top (A1) until the motor enclosure bottom (A2) has travelled the full distance. Make sure the Motor bracket (A3) is flush with the motor enclosure top (A1). Take care not to jam the wires against the encoder - the encoder needs to be free to spin. 
7. The motor enclosure top (A2) with the motor bracket (A3) are fastened using M4 x 60mm bolts (O23) and nyloc nuts (O28)

<p align="center">
  App GUI
</p>
<p align="center">
  App GUI
</p>

#### II.2.3. Assembly of the legs

The left leg of the MTV consists of the following parts:

- 1 x 3D-printed <a href="cad/Joints/90deg_Joint.stl">90 deg Joint </a> (A4)
- 1 x 3D-printed <a href="cad/Joints/End_Joint.stl">End Joint  </a> (A7)
- 1 x 3D-printed <a href="cad/BearingCover/BearingCover.stl">Bearing Cover </a> (A11)
- 1 x 3D-printed <a href="cad/Joints/100deg_Joint.stl">100 deg Joint </a> (A5)
- 2 x 3D-printed <a href="cad/Legs/Front_Leg.stl">Front Leg </a> (A8)
- 1 x 3D-printed <a href="cad/Legs/Mid_Leg.stl">Mid Leg </a> (A9)
- 1 x 3D-printed <a href="cad/Legs/Rear_Leg.stl">Rear Leg </a> (A10) 
- 1 x D-Line cable duct (O4)
- 1 x 7-Core Cable (O3)
- 1 x MR126ZZ Ball Bearing (O6)

The right leg of the MTV consists of the following parts:

- 1 x 3D-printed <a href="cad/Joints/90deg_Joint.stl">90 deg Joint </a> (A4)
- 1 x 3D-printed <a href="cad/Joints/End_Joint.stl">End Joint  </a> (A7)
- 1 x 3D-printed <a href="cad/BearingCover/BearingCover.stl">Bearing Cover </a> (A11)
- 1 x 3D-printed <a href="cad/Joints/100deg_Joint_Mirror.stl">100 deg Joint Mirror</a> (A6)
- 2 x 3D-printed <a href="cad/Legs/Front_Leg.stl">Front Leg </a> (A8)
- 1 x 3D-printed <a href="cad/Legs/Mid_Leg.stl">Mid Leg </a> (A9)
- 1 x 3D-printed <a href="cad/Legs/Rear_Leg.stl">Rear Leg </a> (A10)
- 1 x D-Line cable duct (O4)
- 1 x 7-Core Cable (O3)
- 1 x MR126ZZ Ball Bearing (O6)

Assemble the 90 degree joint (A4) and related legs (A8) (2x forward + mid) to form the forward leg assembly (right and left). The legs are secured to the joint by M4 x 40mm bolts (O24), flat washer (O30), spring washer (O30), and nuts (O28). Drill the guided holes provided with M4 in the leg assemblies (in the mid leg there are 3 guided holes, end 2 should be M4 and mid should be M3 which will be used to mount the shock absorbers).
Attach the rear leg 100degree joint (A5) (resp. mirror A6) and the rear leg to form the port and starboard full leg assemblies and secure the leg using M4 x 40mm bolts (O24), flat washer (O30), spring washer (O30), and nuts (O28).  

<p align="center">
  App GUI
</p>

#### II.2.4. Assembly of the chassis

Attach the motor brackets to the free ends of each leg (2 x forward and rear leg of both Left and right side) using M4 x 40mm bolts (O24), flat and spring washers (O30), and nuts (O28). Attach the tires (O2) to the hex hub and secure them with the wheel hub nut. The MTV motors contain an integrated magnetic encoder for velocity estimation and have a 6-pin interface, for namely `[Motor power +, Motor power - , Encoder power + , Encoder power - , Encoder data 1, Encoder data 2]`. Electrical connection between the motors and the control PCBs should be done using the (O3) 7-core cable:

<p align="center">
  App GUI
</p>

Complete the chassis assembly, including attaching the cable duct (O4) as required:

<p align="center">
  App GUI
</p>

#### II.2.5. Assembly of the main compartment

The main compartment consist of the following parts:

- 2 x 3D-printed <a href="cad/BearingCover/BearingCover.stl">Bearing Cover </a> (A11)
- 1 x 3D-printed <a href="cad/PhoneMount/Phone_Mount.stl">Phone Mount Platform </a> (A12)
- 1 x 3D-printed <a href="cad/Buffer/Name_Front.stl">Name Front </a> (A13)
- 1 x 3D-printed <a href="cad/Buffer/Name_Back.stl">Name Back </a> (A14)
- 1 x 3D-printed <a href="cad/Buffer/Buffer_Left.stl">Buffer Left </a> (A15)
- 1 x 3D-printed <a href="cad/Buffer/Buffer_Right.stl">Buffer Right </a> (A16)
- 1 x 3D-printed <a href="cad/Compartment/Compartment_Rear.stl">Compartment Rear </a> (A17)
- 1 x 3D-printed <a href="cad/Compartment/Compartment_Front.stl">Compartment Front </a> (A18)
- 1 x 3D-printed <a href="cad/Compartment/Roof_Front.stl">Roof Front </a> (A19)
- 1 x 3D-printed <a href="cad/Compartment/Roof_Rear.stl">Roof Rear </a> (A20)
- 1 x 3D-printed <a href="cad/Compartment/Compartment_Battery_Mount-P1.stl">Compartment Battery Mount P1 </a> (A21a)
- 1 x 3D-printed <a href="cad/Compartment/Compartment_Battery_Mount-P2.stl">Compartment Battery Mount P2 </a> (A21b)
- 4 x M4 x 120mm screws (O26)
- 6 x PG7 Cable Gland (O5)
- 1 x M6 threaded bar (O21) 

Join the rear compartment (A17) with the forward compartment (A18) to form compartment assembly using M3 x 15mm (O25), flat washers (O28) nyloc nuts (O28). Use the guided holes to drill M3 holes for the joining purpose.

<p align="center">
  App GUI
</p>

Drill the bearing connection holes onto the chassis where the guided holes are provided and insert the bearings (O6) into the bearing cover (A11) and secure the bearing assembly to the outside of the compartment assembly by the use of 4 M3 x 30mm bolts (O25), spring washers (O30), washers (O28) and nylocs (O28).

<p align="center">
  App GUI
</p>

Attach the cable gland joints (O5) to the six holes on the rear compartment (A17). The six gland joints are used to pass the motor wires into the compartment:

<p align="center">
  App GUI
</p>

Attach the left and right buffers (A15 & A16) to the compartment assembly using 4 M3 x 20mm bolts (O25), spring washers (O30), washers (O28) and nylocs (O28). 

<p align="center">
  App GUI
</p>

Attach the battery mount P1 & P2 (A21 a & b) on to the rear compartment using M3 x 15mm bolts (O25) and nylocs (O28). Insert the M6 threaded bar (O21) into the chassis assembly though the centre hole of the bearings and the Battery mount P1&P2 assembly. As the threaded bar is inserted from one side, take care to add the required M6 nuts (O29) that are internal to the compartment.  
- Note that there are two M6 nuts (O29) on the outside of the compartment that act as spacers between the chassis and the compartment assembly. 
- Also note that the threaded bar needs to be balanced between the left and the right to ensure space for chassis assembly. 
- Care must be taken when screwing in the threaded bar into the compartment to ensure no pretension is added to the side walls.

<p align="center">
  App GUI
</p>

#### II.2.6. Assembly of the vehicle

Attach the chassis assembly to the M6 threaded bar either side of the compartment and secure using M6 Nuts (O29):

<p align="center">
  App GUI
</p>

Attach the shock absorbers (O7) between the mid leg and the chassis:

<p align="center">
  App GUI
</p>

Swap the factory default springs in the shock absorbers with the medium compliance set provided (gold springs) to ensure the body of the robot remains leveled with the ground. Attach the piston end to the robot compartment using the spacer and bolt provided with the shock absorber (O10) and an M3 lock nut (O28). Fix the rod end using M3 x 40 bolts (O25) and nyloc (O28). Run the wires from the leg assembly to the main body and attach as per wiring guidelines (also make appropriate use of the cable management trunking). Attach the phone mount to the roof front (A19) 
- Attach the universal smart phone holder (O11) to the phone mount platform (A12). 
- Attach the vibration isolators (O11) to the phone mount platform (A12) and secure it to the roof front (A19) using lock nuts and washers as illustrated.   

<p align="center">
  App GUI
</p>

Fix the voltage display (O12), power control switches (O13), and Micro USB Panel Mount Cable (O14) on the roof rear's designated slots. Pull out the head and tail lights (O8 & O9) though the roof cut outs and attach the roof front (A19) and roof rear (A20) to the compartment assembly. Insert the head lights (O8) into headlight socket (A23), and tail lights (O9) into the taillight socket (A24) and fix to the respective slots in roof front (A19) and roof rear (A20). Seal the light sockets with light endcaps (A22) as shown in figure below and use super glue to attach them. Slide in the customised Name Front (A13) and Name Back (A14) plates. 

<p align="center">
  App GUI
</p>

### II.3. Electronics Assembly 

This part only covers the integration of the electronic boards into the vehicle. The reader will find complementary details about the architecture and components of the different PCBs via the the [following link](./pcb). The pototyped PCBs are illustrated in the following figures: 

<p align="center">
  App GUI
</p>

#### II.3.1. Battery – PCB connection 
The rechargeable Lipo battery selected for the MTV is connected to the Power distribution PCB using a set of dedicated connectors. A switch allows preventing spark damages on the battery connectors. Since this switch is mounted on the lid of the MTV, a set of splicing connectors can be used for maintenance purposes:

<p align="center">
  App GUI
</p>

#### II.3.2. PCB – voltage display connection 

A dedicated voltage display provides relevant indication of the battery state. It should be connected to the Power distribution PCB.

<p align="center">
  App GUI
</p>

#### II.3.3. PCB – lights connection 

The front and rear lights should be connected to the MTV's main PCB. A switch should placed on the lid of the MTV to control them.  

<p align="center">
  App GUI
</p>

<p align="center">
  App GUI
</p>

#### II.3.4. Power distribution PCB assembly

The power distribution board is mounted into the MTV main housing. The motor cables are pulled through the mounting slots after the power distribution board is in place. The main PCB is then attached to the MTV as shown in the following figure:

<p align="center">
  App GUI
</p>

Once the main PCB is in place, the motor connection cables are shortened and connected to the main board using 2-pin, 5.08 mm pitch screw terminals. Next are the lighting connections.  The 12V and 5V voltage connections of the power distribution PCB are connected to the MTV in the final step. 

<table>
    <thead>
        <tr>
            <th>PCB </th>
            <th>Name printed on the PCB</th>
            <th>Picture</th>
            <th>Comments </th>
        </tr>
    </thead>
    <tbody>
        <tr>
            <td rowspan=2>Power Distribution PCB </td>
            <td>
            Mount_1 
            Mount_2
            Mount_3
            Mount_4
            </td>
            <td><p align="center"> App GUI</p></td>
            <td>These M3 type mounting holes were designed to connect the Power distribution PCB to the connection points on the MTV with the use of screws and nuts.  </td>
        </tr>
        <tr>
            <td>
            VC_Mount_1 
            VC_Mount_2
            VC_Mount_3
            VC_Mount_4
            </td>
            <td><p align="center"> App GUI</p></td>
            <td>These M3 type mounting holes were designed to connect the Voltage converter on to the power distribution PCB with the use of screws and nuts.</td>
        </tr>
        <tr>
            <td rowspan=2>Main PCB </td>
            <td>
            Mount_1 
            Mount_2
            Mount_3
            Mount_4
            </td>
            <td><p align="center"> App GUI</p></td>
            <td>These M3 type mounting holes were designed to connect the Main PCB to the connection points on the MTV with the use of screws and nuts.</td>
        </tr>
        <tr>
            <td>
            MD_Mount_1 
            MD_Mount_2
            MD_Mount_3
            MD_Mount_4
            </td>
            <td><p align="center"> App GUI</p></td>
            <td>These M3 type mounting holes were designed to connect the motor drivers on to the Main PCB with the use of screws and nuts. </td>
        </tr>
</table>

#### II.3.4. MTV roof cables assembly 

Once the main PCB was attached, switches and displays in the roof / lid of the of the MTV were connected using Splicing Connectors.  Also, the Micro USB program port of the ESP 32 was connected to a “left angled 90 Degree Micro USB mount extension cable (Male to Female). The Female end of the panel mount USB extension was connected on to the lid of the MTV. So, users can plug the USB cables without the need of removing the lid / roof. 

<p align="center">
  App GUI
</p>

### II.4. Safety disclaimer 

*It is assumed that the MTV will be constructed by individuals who have an intermediate or advanced level of expertise in assembling mechanical and electronic devices. Please be aware of your own safety as you assemble and operate the robot. Neither **Ivy Tech LTD** nor **Intel Deutschland GmbH** are responsible for the result of any accidents caused by the user's negligence.*

- Read through the manual carefully before assembly.
- Beware of the sharp edges of 3D printed components. 
- Keep a safe distance from the robot during operation.
- Be careful to not get fingers stuck between the robot joints and wheels.
- Do not store the robot under direct sunlight.
- This product is **not waterproof**. We do not recommend operating the MTV in rainy or wet environments. 
- Do not use the MTV near fire or any source of heat.
- Do not drop the MTV from hights.
- Use only the designated/recommended tools to assemble the robot.
- Do not use excessive force on nuts, bolts or robot parts.
- Avoid activating the robot at heights to prevent sudden drop.
- Do not damage or place the Li-Po battery in water. 
- Do not connect or let the Li-Po battery come in contact with other conductors apart from the suggested terminals.
- When the robot is out of charge, it is recommended to take the battery out of the robot and to place it in a Li-Po Safe Bag before charging it. The battery, once fully charged can be inserted back into the robot as illustrated below
<p align="center">
  App GUI
</p>

<p align="center">
  App GUI
</p>

## III: Next

Flash the [Arduino Firmware](../../firmware/README.md)
