ob-f/OpenBot/body/README.ko-KR.md

# OpenBot: 로봇 본체

<p align="center">
  <a href="README.md">English</a> |
  <a href="README.zh-CN.md">简体中文</a> |
  <a href="README.de-DE.md">Deutsch</a> |
  <a href="README.fr-FR.md">Français</a> |
  <a href="README.es-ES.md">Español</a> |
  <span>한국어</span>
</p>

아마존에서 [만들어진(RTR)](rtr) OpenBot을 구매할 수 있습니다:
- [RTR-TT](https://buy.openbot.org/rtr-tt)
- [RTR-520](https://buy.openbot.org/rtr-520)

대량 주문 요청은 이메일로 문의해 주세요.

## 직접 만들기

Arduino Nano와 같은 마이크로컨트롤러를 사용하여 OpenBot 소프트웨어 스택과 함께 사용할 수 있는 바퀴가 달린 로봇 본체를 만들 수 있습니다. 저희는 저비용의 쉽게 구할 수 있는 취미 하드웨어를 기반으로 한 [3D 프린팅 본체](diy)를 설계했습니다. [OpenBot Lite](lite)는 교육용으로 개발된 OpenBot DIY 버전의 소형 및 간소화된 변형입니다. 직접 만들고 싶지 않더라도 [단계별 비디오 가이드](lite/#step-by-step-video-guides)가 유용할 수 있습니다. 또한 상업적으로 판매되는 1:16 RC 트럭(예: [이 제품](https://www.amazon.de/dp/B00M3J7DJW))을 위한 [3D 프린팅 본체](rc_truck)도 설계했습니다. OpenBot 프레임워크를 사용한 야외 프로젝트를 위한 범용 플랫폼으로 [다목적 차량](mtv) 제작을 위한 청사진도 제공합니다.

아래는 제작 지침 및 추가 세부 정보가 포함된 여러 예시입니다:

<table style="width:100%;border:none;text-align:center">
  <tr>
  <td>  <a href="diy">
    DIY
  </a>
  </td>
  <td>
  <a href="lite">
    Lite
  </a>
  </td>
  <td>
  <a href="rc_truck">
    RC 트럭
  </a>
  </td>
  <td>
  <a href="mtv">
    다목적 차량
  </a>
  </td>
  <td>
  <a href="rtr">
    RTR
  </a>
  </td>
  </tr>
  <tr>
    <td><a href="diy"> DIY </a></td>
    <td><a href="lite"> Lite </a></td>
    <td><a href="rc_truck"> RC 트럭 </a></td>
    <td><a href="mtv"> 다목적 차량 </a></td>
    <td><a href="rtr"> RTR </a></td>
  </tr>
</table>

## 다음

[Arduino 펌웨어](../firmware/README.ko-KR.md)를 플래시하세요!
