ob-f/OpenBot/android/README.md

# Android Apps

<p align="center">
  <span>English</span> |
  <a href="README.zh-CN.md">简体中文</a> |
  <a href="README.de-DE.md">Deutsch</a> |
  <a href="README.fr-FR.md">Français</a> |
  <a href="README.es-ES.md">Español</a> |
  <a href="README.ko-KR.md">한국어</a>
</p>

## Features

Click on the links below to read about the features of the apps.

- [Robot App](robot/README.md)
- [Controller App](controller/README.md)

## Install the apps

The easiest way to get either of the apps is to download it directly to the phone using the corresponding QR code. If you are on the phone browser, you can also just click on the QR code. You can then open the apk on your phone and [install](https://www.lifewire.com/install-apk-on-android-4177185) it. Note that the apk is only signed with a debug key.

<table style="width:100%;border:none;text-align:center">
  <tr>
    <td>  <a href="https://app.openbot.org/robot" target="_blank">
    🤖 App
  </a>
    </td>
    <td>
  <a href="https://app.openbot.org/controller" target="_blank">
    🎮 App
  </a>
      </td>
  </tr>
  <tr>
    <td>🤖 App</td>
    <td>🎮 App</td>
  </tr>
</table>

Alternatively, you can download the apks from the assets of any [release](https://github.com/ob-f/OpenBot/releases). If you want the latest app from the master branch, you can also download it from the build artifacts [here](https://github.com/ob-f/OpenBot/actions?query=workflow%3A%22Java+CI+with+Gradle%22). Note, that it may not be stable. If you would like to make changes to the app later, follow the steps below to compile the app and deploy it on your phone.

> **Note:** The `Controller-<version>.apk` release asset is now built from the [Flutter Controller App](../controller/flutter/README.md) instead of the legacy Android controller app in this folder. The Flutter controller uses a different package ID (`org.openbot.app.controller` instead of `org.openbot.controller`), so it will **not** update an existing legacy controller installation. If you already have the legacy controller installed, install the new controller separately; you can uninstall the legacy app afterwards.

## Build the apps

### Prerequisites

- [Android Studio Electric Eel | 2022.1.1 or later](https://developer.android.com/studio/index.html) for building and installing the apks.
- Android device and Android development environment with minimum API 21.
- Currently, we use API 33 as compile SDK and API 32 as target SDK. It should get installed automatically, but if not you can install the SDK manually. Go to Android Studio -> Preferences -> Appearance & Behaviour -> System Settings -> Android SDK. Make sure API 33 is checked and click apply.

Android SDK

### Build process

1. Open Android Studio and select *Open an existing Android Studio project*.
2. Select the OpenBot/android directory and click OK.
3. If you want to install the [OpenBot app](robot/README.md) make sure to select the *app* configuration. If you want to install the [Controller app](controller/README.md), select the *controller* configuration. Confirm Gradle Sync if neccessary. To perform a Gradle Sync manually, click on the gradle icon.
  Gradle Sync
4. Connect your Android device and make sure USB Debugging in the [developer options](https://developer.android.com/studio/debug/dev-options) is enabled. Depending on your development environment [further steps](https://developer.android.com/studio/run/device) might be necessary. You should see your device in the navigation bar at the top now.
  Phone
5. Click the Run button (the green arrow) or select Run > Run 'android' from the top menu. You may need to rebuild the project using Build > Rebuild Project.
  Run
6. If it asks you to use Instant Run, click *Proceed Without Instant Run*.

### Troubleshooting

#### Versions

If you get a message like `The project is using an incompatible version (AGP 7.4.0) of the Android Gradle plugin. Latest supported version is AGP 7.3.0` you need to upgrade Android Studio or downgrade your gradle plugin. You can read more about the version compatablility between Android Studio and the gradle plugin [here](https://developer.android.com/studio/releases/gradle-plugin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).
