ob-f/OpenBot/body/lite/README.ko-KR.md

# 교육용 OpenBot

<p align="center">
  <a href="README.md">English</a> |
  <a href="README.zh-CN.md">简体中文</a> |
  <a href="README.de-DE.md">Deutsch</a> |
  <a href="README.fr-FR.md">Français</a> |
  <a href="README.es-ES.md">Español</a> |
  <span>한국어</span>
</p>

ITE의 eSpace는 OpenBot 소프트웨어 스택을 기반으로 경제적이고 확장 가능한 AI 및 로봇 교육을 위한 [커리큘럼](#커리큘럼)을 개발했어요. 이 커리큘럼은 [단계별 유튜브 영상](#단계별-비디오-가이드) 형식으로 제공되며, [OpenBot Lite](#openbot-lite)(오픈봇 라이트)를 조립하는 방법, 필요한 소프트웨어를 설치하는 방법, 사람을 따라가는 기능을 사용하는 방법, 그리고 자율 주행 정책을 훈련하고 배포하는 방법을 하나하나 안내해준답니다!

## OpenBot Lite

OpenBot Lite는 OpenBot DIY 버전의 더 작고 간소화된 버전이에요. 이 미니멀한 버전은 ITE의 eSpace에서 OpenBot 소프트웨어 스택의 뛰어난 잠재력을 활용해 경제적이고 확장 가능한 AI와 로봇 교육을 위해 개발했답니다. OpenBot Lite는 [micro:bit](https://microbit.org/) (+ 자체 IO 보드) 또는 Arduino Nano를 지원해요. 아래 이미지는 왼쪽에 micro:bit 버전, 오른쪽에 Arduino 버전이 보여요.

<p float="left">
  
</p>
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
