ob-f/OpenBot/body/compact/cad/step/led_adapter_6mm.step

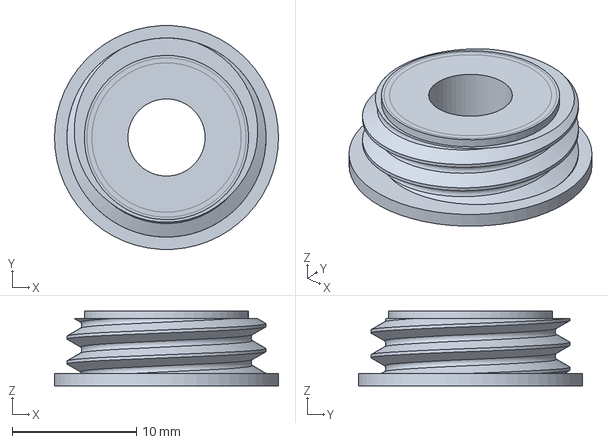
[picture p21: CAD file, 2026-11-14]
body/compact/cad/step/led_adapter_6mm.step
18.0 x 18.0 x 6.00 mm
