ob-f/OpenBot/body/phone_mount/phone_mount_tilt_base.stl

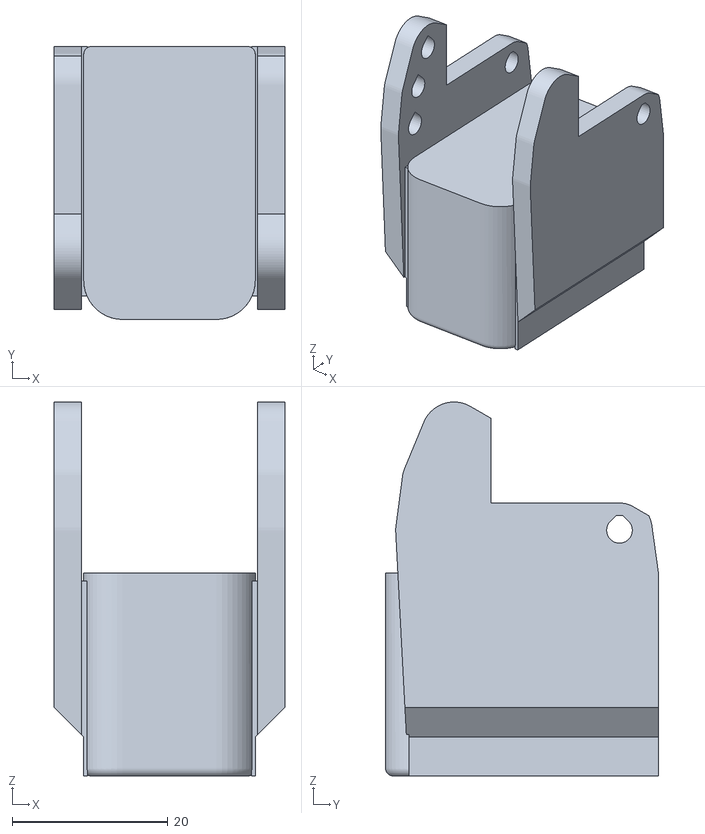
[picture p22: CAD file, 2026-11-14]
body/phone_mount/phone_mount_tilt_base.stl
29.6 x 35.0 x 48.0
