ob-f/OpenBot/(list of files, cad)

Other CAD files:
body/compact/cad/stl/led_adapter_8mm.stl
