ob-f/OpenBot/(threads)

Thread 1 (2020-08-26):

License

germanros1987, 2020-08-26:
The license description is missing :)

thias15, 2020-08-27:
Will be added with the code which is currently still in the internal review process.

Closed 2020-08-27.

Thread 2 (2020-08-27):

Tips on printing on a printer with smaller build volume?

katnoria, 2020-08-27:
First of all thank you for sharing this project. 💯

I am really excited to make one and run my on models on it.

Do you have any tips about printing on a smaller build volume? I have Ultimaker 2 extended which has a build volume of 223 mm × 223 mm × 305 mm. The body of the bot does not fit? The best I can get is this
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

thias15, 2020-08-27:
Hi @katnoria

I have made a slim version of the model that fits into a 220x220 build surface. Please try it and let me know.
If this works, I can also create a matching top cover.

[body_bottom_slim.slt](https://github.com/intel-isl/OpenBot/blob/master/body/body_bottom_slim.stl)

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

katnoria, 2020-08-28:
hi @thias15

Thank you for making the slim version. It work 👍
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

Would you please create the slim version of top cover too?

VCU-RVI-dataset, 2020-08-28:
hi @thias15

My printer is 200X200X200mm. Would you mind uploading the editable part files as well? If so, we can shrink the size or split the base and top into several pieces on our own.

thias15, 2020-08-29:
I made a slim version for the top: [body_top_slim.stl](https://github.com/intel-isl/OpenBot/blob/master/body/body_top_slim.stl).
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

thias15, 2020-08-29:
@VCU-RVI-dataset, I have also added the STEP files for the top and bottom of the chassis for more flexibility (see updated README). Please let me know if you figure out a good solution for smaller build volumes.

katnoria, 2020-08-30:
Thank you @thias15

Closed 2020-08-29.

Thread 6 (2020-08-29):

Robot

marcivrs60, 2020-08-29:

thias15, 2020-08-29:
What's the issue?

thias15, 2020-08-29:
No description.

marcivrs60, 2020-08-29:
thias15 <notifications@github.com> (időpont: 2020. aug. 29., Szo, 10:06)
ezt írta:

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

no problem.  it was all a coincidence.  i installed the github app and
suppressed something.  I'm sorry!

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

thias15, 2020-08-29:
Ok, thanks. Let us know if you face any problems.

Closed 2020-08-29.

Thread 13 (2020-09-01):

Wiring diagram

Tmin10, 2020-09-01:
May you provide wiring diagram for the robot?

I'm little bit confused with point 17 in the build instructions:
- (Optional) Connect the voltage divider to pin A7 of the Arduino

What is the voltage divider, why we need it and how we can connect it to the robot.

Other question about point 14:
Why we need connect echo and trigger pins together in one arduino port? Other samples told us to use two ports for this...

P.S. Thank you for your project!

thias15, 2020-09-01:
The voltage divider is used to measure the battery voltage. The battery has a voltage of 9.6-12.6V. But the ADC of the Arduino can only measure a voltage of up to 5V. For example, you can use a 20k and 10k resistor and then set the multiplier in the app to 3. One end of the 20k resistor is connected to Vin and the other to the Arduino pin A7 and one end of the 10k resistor. The other end of the 10k resistor is connected to GND. More info [here](https://ohmslawcalculator.com/voltage-divider-calculator).
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

We use the NewPing library for the Ultrasonic sensor. It supports single pin operation and automatically toggles this pin to be an input and output depending if the echo signal is sent or it is waiting for the trigger signal to be received. You can also connect it to two pins as in other tutorials if you prefer. Just make sure to keep it event-driven as in the code, otherwise the ultrasonic sensor will block the rest of the code.

Tmin10, 2020-09-01:
Got it. So voltage divider is about arduino power supply.
Maybe it's better to use some DC-DC convertor since we losing part of the energy as heating on resistors

Tmin10, 2020-09-01:
Hm, I reread instructions again and looks like this voltage divider isn't for power supply, sorry.
Is it for battery charge level checking? I confused because there is no resistors in the bill of materials...

thias15, 2020-09-02:
Yes, it is to check the battery voltage and it is optional.

thias15, 2020-09-04:
Closing due to inactivity.

Tmin10, 2020-09-04:
I'm sorry but my request still open. Maybe in future you can add picture with the wiring diagram?
In other issue I found question about wiring motors. It could help with robot assembly for others.

thias15, 2020-09-04:
I have added a wiring diagram. Does this answer your questions? If not feel free to reopen the issue or open another one.

Tmin10, 2020-09-04:
Cool, thank you! Sorry, I missed your commit.

Closed 2020-09-04.

Thread 15 (2020-09-02):

[Feature] Button to switch camera

Tmin10, 2020-09-02:
Hello. I run the app on my phone but it display picture from front camera. After debugging I realize that I need to change https://github.com/intel-isl/OpenBot/blob/master/android/app/src/main/java/org/openbot/CameraActivity.java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 to 0 (LENS_FACING_FRONT) and it working fine... I don't know why front and back are reversed in my case but it could help you in future for debug the same problems.

My device is Asus Zenfone Max Pro (M2) ZB631KL, Android 9. Other cameras apps working fine.

thias15, 2020-09-02:
We have not encountered this on any phone before. Thanks for opening this issue, we will keep an eye on it. I will close it for now, since I don't expect this to be a general issue.

Tmin10, 2020-09-02:
Yep, thanks. Maybe in future it is possible to add camera switch into the settings.

eagleanurag, 2020-10-11:
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

tin my case also when i used my old Samsung J7 Max by default front camera opens

vkuehn, 2020-11-17:
Hi I have a solution for that, can you kindly assign it to me ?
Sorry it will be not fully compliant with your naming rules..this time

vkuehn, 2020-12-08:
is there an issue why it is a ToDo again ?

Closed 2020-11-19.

Thread 16 (2020-09-02):

Tensorflow-lite not found error?

Apurv505, 2020-09-02:
Hi,
First of all thanks for making such an awesome robot!!! I have been waiting for something like this for years!!!
I tried to follow the app build instructions but hit an error in the middle.

**It says tensorflow-lite doesn't exists in the folder**. I am an amateur in android studio so don't really know if this should happen or not. I checked the cloned folder and there  wan't any tensor flow file.
Hope this is not confusing and I would really appreciate help on this.

Thank you!!!

_Download https://services.gradle.org/distributions/gradle-5.4.1-all.zip (132.77 MB)
Download https://services.gradle.org/distributions/gradle-5.4.1-all.zip finished succeeded, took 7 m 49 s 218 ms
Starting Gradle Daemon...
Gradle Daemon started in 1 s 617 ms
**<ij_msg_gr>Project resolve errors<ij_msg_gr><ij_nav>/home/pinkpanther/Github_cloned/OpenBot/android/build.gradle<ij_nav><i><b>root project 'android': Unable to resolve additional project configuration.</b><eol>Details: org.apache.tools.ant.BuildException: Basedir /home/pinkpanther/Github_cloned/OpenBot/android/tensorflow-lite does not exist</i>**
File /home/pinkpanther/.android/repositories.cfg could not be loaded.
Checking the license for package Android SDK Build-Tools 28.0.3 in /home/pinkpanther/Android/Sdk/licenses
License for package Android SDK Build-Tools 28.0.3 accepted.
Preparing "Install Android SDK Build-Tools 28.0.3 (revision: 28.0.3)".
"Install Android SDK Build-Tools 28.0.3 (revision: 28.0.3)" ready.
Installing Android SDK Build-Tools 28.0.3 in /home/pinkpanther/Android/Sdk/build-tools/28.0.3
"Install Android SDK Build-Tools 28.0.3 (revision: 28.0.3)" complete.
"Install Android SDK Build-Tools 28.0.3 (revision: 28.0.3)" finished.
Checking the license for package Android SDK Platform 28 in /home/pinkpanther/Android/Sdk/licenses
License for package Android SDK Platform 28 accepted.
Preparing "Install Android SDK Platform 28 (revision: 6)".
"Install Android SDK Platform 28 (revision: 6)" ready.
Installing Android SDK Platform 28 in /home/pinkpanther/Android/Sdk/platforms/android-28
"Install Android SDK Platform 28 (revision: 6)" complete.
"Install Android SDK Platform 28 (revision: 6)" finished.
Calling mockable JAR artifact transform to create file: /home/pinkpanther/.gradle/caches/transforms-2/files-2.1/60b701dab9dbd0c40a2aad2e3a66fedc/android.jar with input /home/pinkpanther/Android/Sdk/platforms/android-28/android.jar

Deprecated Gradle features were used in this build, making it incompatible with Gradle 6.0.
Use '--warning-mode all' to show the individual deprecation warnings.
See https://docs.gradle.org/5.4.1/userguide/command_line_interface.html#sec:command_line_warnings

CONFIGURE SUCCESSFUL in 28m 46s_

Tmin10, 2020-09-02:
Hm, I successfully build the app but I also have no tensorflow-lite folder...
My build log:
```
Executing tasks: [:app:assembleDebug] in project C:\...\OpenBot\android

WARNING: The specified Android SDK Build Tools version (28.0.3) is ignored, as it is below the minimum supported version (29.0.2) for Android Gradle Plugin 4.0.1.
Android SDK Build Tools 29.0.2 will be used.
To suppress this warning, remove "buildToolsVersion '28.0.3'" from your build.gradle file, as each version of the Android Gradle Plugin now has a default version of the build tools.
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

> Task :app:stripDebugDebugSymbols UP-TO-DATE
WARNING: Compatible side by side NDK version was not found. Default is 21.0.6113669.
Compatible side by side NDK version was not found. Default is 21.0.6113669.

> Task :app:packageDebug
> Task :app:assembleDebug

BUILD SUCCESSFUL in 3s
23 actionable tasks: 1 executed, 22 up-to-date

Build Analyzer results available
```

thias15, 2020-09-02:
So is it working now?
You need to run the gradle sync and then compile.
The tensorflow-lite folder will be generated automatically.

Apurv505, 2020-09-04:
Yes! Thank you so much!!
The gradle sync completed and when I rebuilt it, it was successful. Now I am waiting for speed sensors to arrive and I'll start making the bot.
Thank you so much for helping!!!

Closed 2020-09-03.

Thread 17 (2020-09-02):

如何获取 3D 机身

mr-shitou, 2020-09-02:
@leegang
嗨，我想组装一个，我看其他的零配件都有写店铺地址，但是 3D 打印的机身没有说具体的怎么去弄
对于这方面不是特别的了解，想请教下怎么在国内并且没有相关设备的情况下去弄一个机身，以及大概的价格是多少
谢谢

thias15, 2020-09-02:
如果您没有3D打印机，则可以使用在线服务。 您将上传stl文件，它们将打印模型并将其运送给您。 我不知道如何在中国找到这样的服务，但是我确定它存在。

@leegang 你能帮我吗？

leegang, 2020-09-02:
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

有易立创、云铸 、魔猴 等在线打印平台。
@mr-shitou 具体价格要上传模型文件才能估价，明天我看看。

mr-shitou, 2020-09-03:
我在 TB 有找到打印店铺，但是有打印要求，不知道能不能满足机身的要求。还有材料、制作方法、工艺等，我就懵了😵
希望能详细些，thanks a lot all of you

leegang, 2020-09-03:
> 我在 TB 有找到打印店铺，但是有打印要求，不知道能不能满足机身的要求。还有材料、制作方法、工艺等，我就懵了😵
> 希望能详细些，thanks a lot all of you

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

timaker, 2020-09-03:
我找到一家提供整套配件的卖家，搜索openbot就找到，好像店铺名叫钛创客

mr-shitou, 2020-09-03:
@leegang 能给个链接么，我找了几个都比你的贵，3q

leegang, 2020-09-03:
> @leegang 能给个链接么，我找了几个都比你的贵，3q

https://www.qsy3d.com/quote.html

thias15, 2020-09-03:
I believe the issue is resolved.

Closed 2020-09-03.

Thread 19 (2020-09-03):

Battery Holder Wiring Colors

mikeh9, 2020-09-03:
Normally the solid black wire is positive and the black wire with a white stripe is negative. The battery holder in the BOM has this convention backwards. When you hook it up, make sure you connect the solid black wire to negative (gnd) and the black and white strip to +12V. There is no fuse in the project, so if you hook it up backwards you will see some magic smoke... :-)

thias15, 2020-09-03:
In our case the wires were red and black. Yes, with these cheap components, conventions are not always followed. It's best to verify with a multimeter.

Closed 2020-09-04.

Thread 20 (2020-09-03):

Power supply for Nano

mikeh9, 2020-09-03:
Is the Nano going to be powered from the phone USB port?

The directions say to wire the speed sensors to 5V. Is this the 5V on the Nano board or the 5V on the L298N?

A wiring diagram would be helpful. :-)

thias15, 2020-09-03:
Either works. Yes, we will eventually add a wiring diagram and step-by-step instructions with more detail.

thias15, 2020-09-04:
I guess it is too later for you, but the wiring diagram is in the repo now. If you have any feedback let me know. Hope this helps.

Closed 2020-09-04.

Thread 21 (2020-09-04):

Which motors connect to which output?

mikeh9, 2020-09-04:
Really appreciate your project and all the hard work you put in. I know the wiring diagram is coming, but can you comment on which motors goes to Out1/2 and which motors go to Out3/4?

I'm writing this to help others out as well. :-)

thias15, 2020-09-04:
Insert the positive and negative leads of the two **left** motors into OUT1 (+) and OUT2 (-) of the L298N board

Insert the positive and negative leads of the two **right** motors into OUT4 (+) and OUT3 (-) of the L298N board

The reason that +/- is swapped for left and right is that the motors are mounted with 180 degrees rotation, so they turn in the opposite direction.

The leads of the motors on the same side are connected, since they are controlled by the same H-bridge. I recommend to solder the wires of the same polarity for both motors on the same side. This way it's easier to install them and make sure there is a good connection.

moosa1996, 2020-09-04:
Hi I have a issue on connecting my nano USB to my mobile type c. cant able to establish USB Connection.I have enabled my developer USB debugging in my android mobile. But still device is not connected in OpenBot app.What is the issue ?

mikeh9, 2020-09-04:
Your reasoning is correct, but I think you mistyped what you meant. I think you wanted to write:

Insert the positive and negative leads of the two left motors into OUT1 (+) and OUT2 (-) of the L298N board

Insert the negative and positive leads of the two right motors into OUT3 (+) and OUT3 (-) of the L298N board

With this configuration my car runs properly. Now onto the training. :-)

Closed 2020-09-04.

Thread 22 (2020-09-04):

Openbot Android app

moosa1996, 2020-09-04:
Hi I have a issue on connecting my nano USB to my mobile type c. cant able to establish USB Connection.I have enabled my developer USB debugging in my android mobile. But still device is not connected in OpenBot app.What is the issue ?
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

francisduvivier, 2020-09-04:
Which phone do you use? It might not support USB OTG

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

thias15, 2020-09-04:
When you first connect the Arduino to your phone it will ask you for permission to access the USB device. Did you see this dialog?

If **yes**, you need to give permission.

If **no**, you probably have a connection issue.
- Double-check the baud rate of App and Arduino are the same (they should be unless you changed something.
- Try another cable.
- Confirm your phone supports USB-OTG.

mikeh9, 2020-09-04:
Can you confirm you used the cable specified in the BOM? It needs to be an OTG cable (ID connected to ground)

moosa1996, 2020-09-05:
> Which phone do you use? It might not support USB OTG
> […](#)
> On Fri, Sep 4, 2020, 13:01 moosa1996 ***@***.***> wrote: Hi I have a issue on connecting my nano USB to my mobile type c. cant able to establish USB Connection.I have enabled my developer USB debugging in my android mobile. But still device is not connected in OpenBot app.What is the issue ? — You are receiving this because you are subscribed to this thread. Reply to this email directly, view it on GitHub <#22>, or unsubscribe <https://github.com/notifications/unsubscribe-auth/AASZQZ4QTUQXR5QGUUQSVCDSEDCH5ANCNFSM4QYCQNOA> .

moosa1996, 2020-09-05:
> Which phone do you use? It might not support USB OTG
> […](#)
> On Fri, Sep 4, 2020, 13:01 moosa1996 ***@***.***> wrote: Hi I have a issue on connecting my nano USB to my mobile type c. cant able to establish USB Connection.I have enabled my developer USB debugging in my android mobile. But still device is not connected in OpenBot app.What is the issue ? — You are receiving this because you are subscribed to this thread. Reply to this email directly, view it on GitHub <#22>, or unsubscribe <https://github.com/notifications/unsubscribe-auth/AASZQZ4QTUQXR5QGUUQSVCDSEDCH5ANCNFSM4QYCQNOA> .

I'm using One plus 5T which supports OTG

moosa1996, 2020-09-05:
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

Yes it asked for permission to access the USB device. I gave yes and the openbot app opens automatically when my arduino nano is plugged into OTG. but when the app is opened it shows a dialogue text "Please Check the USB Connection". Why so?

moosa1996, 2020-09-05:
> Can you confirm you used the cable specified in the BOM? It needs to be an OTG cable (ID connected to ground)

I used 2 type of cable converter. One is "Type C to USB female" and other is "Mini to USB male" i have attached my converter cables for your reference
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

thias15, 2020-09-05:
Should work in principle, but we never tried with adapters. Can you verify with another phone or device that the cables work?

thias15, 2020-09-07:
What happens when you try to toggle the connection switch in the app? Are you sure the Arduino has the firmware flashed correctly? Can you try to flash it again and then open the serial monitor to see if the Arduino is connecting and sending it's messages.

thias15, 2020-09-09:
Closing due to inactivity.

Closed 2020-09-09.

Thread 23 (2020-09-06):

BOM Question, Replacement for TMCP1D104MTRF?

ssurovich, 2020-09-06:
Hi team - First, great project - I cant thank you enough for the work the team has done, Im very excited to play around with the project.

On the BOM, you have a Capacitor, Vendor part TMCP1D104MTRF, but at LCSC it has been discontinued, and the only direct replacement has also been discontinued.  They have every other part, so I was wondering if you had a replacement capacitor from LCSC that you could suggest?   The closest match I could find is TAJA104K035RNJ from AVX - It may be a good replacement, but before ordering the entire BOM from LCSC, it would be great to have a confirmation.

Thanks!

thias15, 2020-09-06:
As long as it has the same package it should work fine. Can you post the link?

thias15, 2020-09-06:
I guess it is this one.
https://lcsc.com/product-detail/Tantalum-Capacitors_AVX_TAJA104K035RNJ_100nF-104-10-35V_C7173.html

The package is a bit bigger, but you can probably get away with it since the pads are quite big. May be a bit harder to solder on.

ssurovich, 2020-09-07:
Hey @thias15 - Thanks, that was my bigger question, the size for the PCB - but theres always some "method" to make it work (one way or another) - I appreciate the quick reply and suggestion - Thanks again!

thias15, 2020-09-07:
Closing the issue for now. Would be great if you can post how it worked out after you get the components.

Thread 24 (2020-09-08):

what are the robot's dimensions?

maraoz, 2020-09-08:
I couldn't find it in the site or README, and it's not clear to me from the models, since I'm new to 3d printing.
Thanks!

ps: any chance you have body parts that fit in a 200x200 build plate?

thias15, 2020-09-08:
The required build plate dimensions for the slim body are 223x223. I'm afraid that it will be tricky to fit into a 200x200 build plate. However, we also provide the step models. So you could adapt the model, maybe split top and bottom into two pieces and then assemble them.

thias15, 2020-09-09:
Closing due to inactivity.

maraoz, 2020-09-09:
I'd still like to know what the robot's dimensions are. Where can I find that info? Thanks

manair, 2020-09-17:
If anyone is able to split this for a 200x200 Printer 3d printer plate, and reassemble it successfully please share the .stl file. Thank you

Closed 2020-09-09.

Thread 25 (2020-09-10):

only one PCB ordering w/ SMT assembly vendors?

flamby, 2020-09-10:
Hello,

Are you aware of PCB vendors offering SMT assembly that accept 1 PCB order?

I tried PCBway and JLCPCB but they requires me, if i understood correctly, to order 5 PCB, with at least 2 fully assembled (SMT).

Also, I tried to see if some DIY shops sell OpenBOT kits, but did not find some for now.

To sum up, more guidance for the hardware part (PCB) would be of great help for newbie makers like me ;-)

Thanks, and keep the good works!

thias15, 2020-09-14:
I'm not aware of vendors where you can order a single PCB. Usually this does not make sense for vendors and would cost a similar amount as ordering a larger quantity. The alternative is to follow the DIY approach where you just buy the components and connect them yourself.

Closed 2020-09-14.

Thread 26 (2020-09-11):

Clarification needed regarding the BOM and U1 Quantity

mondobongo64, 2020-09-11:
Please confirm the quantity for ID 7 in the BOM.csv. The BOM states 2 but this seems to be in contradiction to the written description of the Electrical Design contained in the Paper.

ID | Name | Designator | Footprint | Quantity | Manufacturer Part | Manufacturer | Supplier | Supplier Part | LCSC Assembly
7 | ARDUINO_NANO | U1 | ARDUINO_NANO | 2 | 2685Y-115CNG1SNA01 | HOAUC | LCSC | C350309 |  

Thanks

thias15, 2020-09-14:
This is the pin header for the Arduino. You need two rows of 15 pin headers, so the BOM is correct.

I do not think this contradicts with the paper. The description in the paper is about the circuit with DIY components without the PCB. Could you maybe point out the section in the paper where you spotted the contradiction?

agios, 2020-09-15:
Hi. I'm not an expert, but should the second pin header be given another designation and also added to the centroid file file for assembly?

Closed 2020-09-14.

Thread 27 (2020-09-12):

need schematic

anonymous98raj, 2020-09-12:
hey hi i need the schematic for the pcb board

thias15, 2020-09-14:
Could you elaborate on what you are trying to do?

thias15, 2020-09-15:
Closing due to inactivity. Please provide more details, so I can help.

anonymous98raj, 2020-09-16:
I Need circuit diagram for the pcb board you designed

anonymous98raj, 2020-09-16:
circuit diagram for custom PCB.

Closed 2020-09-15.

Thread 28 (2020-09-12):

Vin/ADC7 in schematic

caiograg, 2020-09-12:
Hey, guys, awsome work!

On the wiring diagram, Vcc is connected to the A7 pin in the Arduino Nano, is that correct?

I have a battery pack which I'll use because it is rechargeable. I intended to connect the 5V regulated output from the driver board to the Vin Arduino pin.

Will try and give some feedback on my attempt here!

-Caio

caiograg, 2020-09-12:
Reread the build instructions. My bad! This is used to check the battery. Closing issue.

Closed 2020-09-12.

Thread 29 (2020-09-13):

Alternative Parts?

TKassis, 2020-09-13:
Is it possible to add 2-3 alternative parts/manufacturers for the drive components? Many of the suggestions in the description are not available on Amazon US.

thias15, 2020-09-14:
Are you referring to the L298N motor driver?

Closed 2020-09-14.

Thread 30 (2020-09-13):

FIXED: ctrlLog.txt is/was logging zeros due to (int) conversion in CameraActivity.java

chilipeppr, 2020-09-13:
Hey, just a heads up to anyone else running into this, but my ctrlLog.txt was logging mostly zeros and the post-processing of the autopilot was then dropping all frames. The problem turned out to be this method.

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

The problem is likely that across Java compilers the order of operations on line 845 and 846 is such that the author's Java compiler was converting to int after the multiplication occurred. In my compiler the (int) conversion was happening prior to the multiplication, so I was ending up with mostly zeros because the getLeft() and getRight() returns a float unless you're at full speed for which you get a 1. Those were the only lines where I got a value in ctrlLog.txt.

So, the fix is to put quotes around the multiplication step so it occurs first.

My ctrlLog.txt now looks like this:
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

It used to look almost completely like this:
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

thias15, 2020-09-14:
Thank you very much for raising this issue. This has been fixed in [dcbe88f](https://github.com/intel-isl/OpenBot/commit/dcbe88f85b6044fb86541ea303ed56e81c04f5ea)

Closed 2020-09-14.

Thread 31 (2020-09-14):

Can't get Autopilot to train correctly

chilipeppr, 2020-09-14:
Thanks again for the great work on this project.

I've spent a couple days now trying to get the Autopilot to train and nothing has quite worked for me. All I get when I turn the Network on after training/post-processing/recompiling the Android app is the OpenBot driving in a slow straight line and crashing into the wall.

Here's what I've gone through thus far...

1. To train, I use the default Data Logger of crop_img. I have the Model set to AUTOPILOT_F and I set the Device to GPU. I leave Drive Mode set to Controller and then I turn on Logging from the XBox controller by hitting the A button. I hear the MP3 file say "Logging started" and then I start driving around my kitchen.

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

2. Once I've created about 5 minutes worth of data from driving around I turn off Logging by hitting A again on the XBox controller. I hear the MP3 file play of "Logging stopped". This part seems fine.

3. I download the Zip file of the logging and place it the policy folder. I'm showing the hierarchy here because your docs say to create a folder called "train" but the Python script looks for "train_data". I also initially didn't realize you had to create manual folders for your set of log data, so I now have that correct such that I do get through the Jupiter Notebook process fine rather than failing on Step 10, which is what happens if you create your folder structure incorrectly.
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

4. My images seem to be fine. The resolution is small at 256x96 but I presume that's the correct size for the crop_img default setting.

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

5. My sensor_data seems ok too.

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

The ctrlLog.txt seems ok (after I fixed that int problem that I posted earlier as a FIXED issue.)
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

My indicatorLog.txt always looks like this. I suppose this could possibly be a problem as it's quite confusing what the indicatorLog.txt is even for. I realize hitting X, Y, or B turns the vehicleIndicator to -1, 0, and 1, but it doesn't really make sense why.

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

I realize the indicatorLog.txt gets merged with ctrlLog.txt and rgbFrames.txt into the following combined file, but all seems good assuming a "cmd" of 1 from indicatorLog.txt is the value I want for the post-processing.
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

6. In the Jupiter Notebook everything seems to run correctly. It opens my manually created folders correctly after I modified the Python code to read the correct manually created folders I created. It reads in my sample data. It removes my frames where the motors were at 0.

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

I get the correct amount of training frames and test frames.

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

In this part I am confused as to these Clipping input data errors and to what Cmd means as it seems to relate to indicatorLog.txt but I'm not sure what a -1, 0, or 1 would indicate in the caption above the images. My guess on the Label is that those are the motor values that would be generated during a Network run on the OpenBot for each image, but not sure since each one says the same motor value of 0.23.

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

In Step 31 of the Jupiter Notebook the output seems fine.

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

In Step 33 the epochs all seem to have run correctly. They took quite a while to finish.

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

And in Step 34 thru 37 the graph seems reasonable, but not really sure what to expect here...

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

In Step 41 this seems to be ok, but it's making me think Pred means "prediction" which are the motor values. Still not sure what the Cmd and Label are then.
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

7. Once the best.tflite file is generated and placed into the "checkpoints" folder...

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

I then copy it to the "networks" folder for the Android app, rename it to "autopilot_float.tflite" and recompile the Android app.

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

Here is Android Studio recompiling.

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

That's about all I can think of to describe what I'm doing to try to get the training going. I would really love to get this working. Your help is greatly appreciated.

Thanks,
John

thias15, 2020-09-14:
Hi John.

Thank you very much for your detailed issue, I really appreciate it! This makes it much easier to help. First the good news: your procedure it correct. Now let me clarify a few things.

1) Cmd: This corresponds to a high-level command such as "turn left/right" or "go straight" at the next intersection. It is encoded as -1: left, 0: straight, 1: right. As you pointed out, this command can be controlled with the X, Y, or B buttons on the game controller. If you have LEDs connected, it will also control the left/right indicator signals of the car. These commands are logged in the indicatorLog.txt file. During training, the network is conditioned on these commands. If you approach intersection where car could go left, straight or right it is not clear what it should do based on the image only. This is where these commands come in to clear up these ambiguities. It seems that you just want the car to drive along a path in your house. In this case, I would recommend to just keep this cmd at 0. NOTE: This command should be the same when you test the policy on the car.

2) Label, Pred: These are the control signals of the car, mapped from -255,255 to -1,1. The label is obtained by logging the control that was used to drive the car. The prediction is what the network predicts to be the correct value given an image.

3) Clipping for image display: this is due to the data augmentation which results in some image values outside the valid range. You can just ignore this.

Now a few comments that will hopefully help you to get it to work.
1) The same motor value of 0.23 is a problem. This should not happen. Please try to deleted the files in the sensor_data folder that were generated ("matched_...").
2) In general the label values seems very low. We have used the "Fast" mode for data collection. I would recommend to do the same. If you use the "Normal" or "Slow" modes, you will need to make a change in lines 43-45 of the dataloader.py file.

```
    def get_label(self, file_path):
        index = self.index_table.lookup(file_path)
        return self.cmd_values[index], self.label_values[index]/255
```

For the "Normal" mode, replace the 255 by 192. For the "Slow" mode, replace the 255 by 128.

I will update the code to be more user-friendly in the future.

3) Depending on the difficulty of the task, you may have to collect significantly more data. Could describe in a bit more detail, your data collection process and the driving task? Also, you may need to train for more epochs.

Hope this helps. Please keep me updated.

chilipeppr, 2020-09-14:
That is super helpful. I think my earlier training might have been closer
to correct where I just left the Cmd at 0, but I did train in Normal mode
so all of my speeds being played back were really low but did seem to try
to change higher or lower as I manually moved the camera around to follow
the path. The values just never quite reached high enough to get the motors
moving. I would say they lingered in the 0.1 range and maybe got to 0.2 as
I moved the camera around. I even wrote code to amplify the speeds later,
but that didn't quite work.  I think I'll try to just record in Fast and/or
make those code changes in dataloader.py.

In terms of how I'm training, I'm just steering the car around my kitchen
island over and over in a circle about 10 times to get a full logging to
analyze. I figured I'd start simple and at least just get it going in a
circle in one direction.

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

chilipeppr, 2020-09-14:
Ok, here's a video of how I train. I used Fast mode (vs Normal or Slow). I set to AUTOPILOT_F and used NNAPI.

https://photos.app.goo.gl/o6BtAHunDjtj8fMNA

And then here's a video of playing back that training. It still doesn't quite work, but I do seem to be getting more movement in the robot with training in Fast mode vs Normal.

https://photos.app.goo.gl/kCw4DpRN6vPpbtCcA

parixit, 2020-09-14:
@chilipeppr super helpful video!  It would be great if you could a step-by-step video of your build for complete newbies.

chilipeppr, 2020-09-14:
I would love to. I figure I might be one of the first to build one of these
outside of the Intel team after the public posting of the project as I
happened to have every piece needed already sitting in my home workshop, so
no need to wait for shipping. It's hard getting this going without more
Youtube videos!

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

parixit, 2020-09-14:
Agreed!  This project is daunting but want to do it together with my kids.  Waiting on the parts and I had our local library 3D print the parts (even they were interested in the project).  I'll look forward to your videos, keep us posted!

chilipeppr, 2020-09-14:
Is it possible that with my kitchen island I have to train each turn around the island as a right turn? Meaning turn on Cmd = 0 on the straight parts and then turn on Cmd = 1 as I turn right 4 times?

thias15, 2020-09-14:
@chilipeppr If you would like to contribute with build videos that would be awesome and we would be very happy to include them for others in the README! I realize that a lot of people require much more detailed instructions. We are working to provide more comprehensive documentation, but at the moment I have a lot of other engagements as well. For the time lapse video, I did record video of a complete build, but did not get a change to edit it yet. If you like, I'd be happy to setup a quick call with you to coordinate.

thias15, 2020-09-14:
The predicted control values still seem to be too low. Could you post the figures at the end of training? I'm afraid, the model did not converge properly or overfit. The training and validation loss should both decrease and the direction and angle metrics should both increase.

The task of your choice should be learnable and keeping the indicator command at 0 should be fine since you are driving along a fixed path. However, I suspect that you need to train the model for more epochs and that you need more training data. I would recommend to:
1) Collect maybe 10 datasets with 5 loops each driving around the kitchen block. Start/stop logging should ideally be done while driving along the trajectory. In the video you have recorded, you drive somewhere else at the end before the logging is stopped. This could lead to difficulty during training, especially if there is not a lot of data.
2) Take 8 of these datasets for training and the remaining two for validation. By monitoring the validation metrics, you should get a good idea of when the model is starting to work.

Collecting good/clean data is key to machine learning. I know it is not a lot of fun to collect such data, but it is what makes it work in the end! Keep up the great work. Looking forward to your next update (hopefully with the robot driving autonomously).

chilipeppr, 2020-09-15:
Ok, I retrained with 10 datasets -- 8 for the training and 2 for the testing. Each run was 5 to 7 loops around the kitchen island. I turned the noise on for 3 of the dataset runs as well.

Here's a video of how I did the training. It's similar to my first post, but I started logging while in motion. I kept the Cmd=0 (default).
https://www.youtube.com/watch?v=W7EHo0Jk02A

On the phone these are the zip files that I copied and extracted to the train_data and test_data folders. Notice they're all around 40MB to 80MB in size which feels correct from a size per training session. Again, I used crop_img.
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

Here are the 8 training datasets placed into the policy/dataset folder.
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

Here are the 2 test datasets.
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

I also ran it at Normal speed, but changed the divider to 192 in dataloader.py from the 255 value in there by default since it assumes Fast mode.
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

I also did the start/stop logging by hitting the A button on the XBox controller while I was in motion on the robot on the start and stop so I would log no speeds of 0. You can see for the 10 datasets I had almost no frames removed for speed 0. I'm even surprised I ended up with any frames of speed 0 in the output because I don't recall stopping, so that's a bit of a concern.

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

I ended up with the most amount of frames I've ever trained with.

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

I ended up with much higher numbers in the Label here than the 0.23 numbers you were worried about in my original post.

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

Here is the mode.fit output. I'd love to understand what the loss, direction_metric, and angle_metric mean to know whether this output seems reasonable or not.

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

Here is the Evaluation data.

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

I'm a little worried about these warnings, but maybe they're ok to ignore.
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

And then here's the final output with predictions. The motor values in the predictions sure seem better.

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

However, when I go to run the Autopilot with this new model, it still seems to have failed. The only progress is I now have motor movement. Before the motor values were so low I had no movement. Here's a video of the auto-pilot running and the robot not staying on the path but rather just running into chairs.

https://www.youtube.com/watch?v=a0-0lh7_j0E

chilipeppr, 2020-09-15:
Hmm. Do I need to edit any of these variables? My crop_img images are 256x96.

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

chilipeppr, 2020-09-15:
Well, apparently the crop_imgs must be correct because I tried doing a training session with preview_img and when I went to train I got these errors.

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

thias15, 2020-09-15:
1) crop_imgs is correct
2) Can you try to change the batch size to a value which is as high as possible? We trained with a batch size of 128, but this will most likely require a GPU. If you cannot, you need to decrease the learning rate. From the plots it looks like it is too high for the dataset.
3) I'm not sure if rescaling all the values by 192 would work since the car was never actually driven with the resulting values. Did you mix the "Normal" and "Fast" datasets?
4) In line 29, the fact that the label for all images is the same (0.88,0.73) is definitely problematic as well. (The reverse label is generated by FLIP_AUG). For your task of going around the kitchen block in one direction you should probably set FLIP_AUG to False!
5) If you like you can upload your dataset somewhere and I'll have a look. This would be much quicker to debug.

chilipeppr, 2020-09-15:
Here is a link to download my dataset. It's the 10 sessions I ran yesterday based on your initial feedback. 8 of the sessions are in train_data as a Zip file. 2 of the sessions are in test_data as a Zip file.

https://drive.google.com/drive/folders/18MchBUtods4sRerSpaA6eTrtC9DPvpbd?usp=sharing

I just tried training the dataset again with your feedback above:
1. I changed the batch to 128. I have an Nvidia Geforce GTX on my Surface Book 3 so no problem on the GPU needed for that change.
2. All of my training was done at the Normal speed, so the 192 divider should be ok. There is no Fast in this dataset.
3. I turned off FLIP_AUG.

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

The results still didn't do anything for me. The robot still acts the same way. I did train for 20 epochs this time.

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

The "best fit" was epoch 2 so that was a lot of wasted CPU/GPU going to 20 epochs.

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

thias15, 2020-09-15:
I will download the data and investigate. The fact that it reaches perfect validation metrics after two epochs and then completely fails is very strange. Did you also try to deploy the last.tflite model or run it on some test images to see if the predictions make sense?

thias15, 2020-09-15:
When I visualize your data, I do see variation in the labels as expected. Do you still see all the same labels?
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

chilipeppr, 2020-09-15:
Yeah, in my training my labels are still all the same. So this does seem
messed up.

[image: image.png]

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

chilipeppr, 2020-09-15:
Yeah, in my training my labels are still all the same. So this does seem messed up.

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

chilipeppr, 2020-09-15:
On your question "Did you also try to deploy the last.tflite model" I did and it was the same failure. It just kept showing a motor value around 0.75 on both left and right motors, sometimes jumping to 0.8 and it would just drive right into chairs/walls.

thias15, 2020-09-15:
This is definitely a problem. In the best case the network will learn this constant label. Did you make any changes to the code? I'm using the exact code from the Github repo with no changes (except FLIP_AUG = false in cell 21). In case you made changes, could you stash them or clone a fresh copy of the repo? The put the same data you uploaded into the corresponding folders and see if you can reproduce what I showed in the comment above.

chilipeppr, 2020-09-15:
I haven't changed any of the code. I did try that last run with the batch size changed and FLIP_AUG = false. I also tried epoch=20. I did change dataloader.py to divide by 192. Other than that the code is totally the same. I can try to re-check out the repo, but I don't think that's going to change much.

One thing I'm trying right now is to create a new conda environment with tensorflow instead of tensorflow-gpu as the library.

chilipeppr, 2020-09-15:
Why do I get clipping errors and you don't for utils.show_train_batch?

thias15, 2020-09-15:
I also get the clipping errors, I just scrolled down so more images with labels are visible. I'm currently running tensorflow on CPU on my laptop without GPU. It will take some time. But it should not make any difference. For the paper all experiments were performed on a workstation with a GPU. One difference is that I only used Mac and Linux. Maybe there is a problem with Windows for the way the labels are looked up? From the screenshots it seems you're on Windows.

thias15, 2020-09-15:
One thing you could try is running everything in the Linux subsystem of Windows.

chilipeppr, 2020-09-15:
Yes, I'm on Windows. Surface Book 3 with Nvidia GPU.

thias15, 2020-09-15:
I'll update you in about 30-60 minutes regarding training progress. But it seems that your issue is the label mapping. I suspect at this point it is related to Windows. As I mentioned, you could try to run the code in the Linux subsystem in Windows. I will also see if I can run it in a VM or setup a Windows environment for testing.

chilipeppr, 2020-09-15:
I'm wondering, if you get a final best.tflite file out of your run if you could send that to me to try out on the robot.

I hear you on the label mapping. Could this possibly be something as dumb as Windows doing CR/LF and Mac/Linux using LF?

thias15, 2020-09-15:
Hello. It finished training for 10 epochs now. The plots look reasonable, so why don't you give it a try. To achieve good performance usually some hyperparameter training, more data and more training time is needed. But let's see.
[best.tflite.zip](https://github.com/intel-isl/OpenBot/files/5227236/best.tflite.zip)

thias15, 2020-09-15:
[notebook.html.zip](https://github.com/intel-isl/OpenBot/files/5227245/notebook.html.zip)
This is the complete output of my Jupyter notebook to give you some idea how the output should look like. When I get a chance, I will explore the issue you encounter in a Windows environment. It could be something like CR/LF vs LF, but since the code relies on the os library, these types of things should be taken care of. I don't know, but will let you know what I discover. Thanks for your patience. I really want you to be able to train your own models and will try my best to figure out the issue you are encountering.

thias15, 2020-09-15:
Note that both files need to be unpacked. I had to zip them in order to upload them here.

chilipeppr, 2020-09-15:
I just tried running your best.tflite and it does not work any better. The robot still runs into walls.

thias15, 2020-09-15:
Does it have a tendency to turn to the right as expected by the test images?

chilipeppr, 2020-09-15:
Yes, it does seem to tend slightly to the right as it's driving.

thias15, 2020-09-15:
The predicted values are not quite large enough. More data, training time and some hyperparameter tuning should greatly improve things. We also have not trained our models at the "Normal" speed before, so not sure if this could also have some effect.

thias15, 2020-09-15:
Can you check line 11 of you notebook? How do you define the base_dir?

chilipeppr, 2020-09-15:
What if I try the Cmd = -1, 0, 1 stuff with hitting X/Y/B at the appropriate time? I suppose I'd just be hitting B to turn right and Y to go straight since I just keep taking right turns. Make some training data that way and see how it goes?

Recall I did make a few datasets earlier with the Fast mode being used and still didn't see good results.

thias15, 2020-09-15:
@chilipeppr since your label values are messed up, I expect that all of your previous training runs did not render any models that have actually learnt something useful. Adding these cmd value will likely not help and would also require you to apply those cmds during test time.

chilipeppr, 2020-09-15:
base_dir = "./dataset"

thias15, 2020-09-15:
In unix environments the current directory is define as ./
However, in Windows it is defined as .\

thias15, 2020-09-15:
Can you try to change it, run it again and see if you get reasonable labels?

chilipeppr, 2020-09-15:
Ok, trying right now...

chilipeppr, 2020-09-15:
Nope. Same problem. Here's my line 11:
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

Thread 32 (2020-09-15):

I can not put the customer PCB and L298N into the box at the same time.

raygong1207, 2020-09-15:
1: I can not put the customer PCB and L298N into the box at the same time, Because no enough space.
2: It seams that the L298N and customer PCB (with the chip DRV8871DDAR SOP8) both for driver the motor；

So i guess that just need one of  L298N and customer PCB ,right? If not. please tell me the different function for L298N and customer PCB.

3: I find something of customer PCB not match with the instruction below:
"14,Connect Echo and Trigger of the ultrasonic sensor to pin D4 of the Arduino.".
In the fact, the customer PCB is connect the Connect Echo and Trigger of the ultrasonic sensor to pin D3.

So, i just do not need customer PCB,right?

thias15, 2020-09-15:
You cannot use both at the same time. If you use the PCB, you don't need the L298N. The PCB has motor driver chips, voltage divider circuit, etc. integrated. Motors and sensors can just be connected with Dupont cables. It is meant for building multiple robots quickly. The PCB pinout is slightly different; in the Arduino code, you need to select either DIY or PCB.

thias15, 2020-09-15:
If you follow the DIY build instructions, you will need to do the wiring manually and you do not need the PCB. Does this answer your questions?

thias15, 2020-09-16:
Updated README to make this more clear.

raygong1207, 2020-09-16:
Thanks a lot! Your answer is very clear. I got it.

Closed 2020-09-16.

Thread 33 (2020-09-16):

Need Circuit Diagram

anonymous98raj, 2020-09-16:
Circuit diagram for custom pcb will be more helpful for me pls share the schematic or circuit diagram for custom pcb which you have made

thias15, 2020-09-16:
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

anonymous98raj, 2020-09-17:
thanks for the support

Closed 2020-09-16.

Thread 34 (2020-09-16):

the PCB has an error.Arduino nano d4 can not set interrupt.

KevinBuddy, 2020-09-16:

thias15, 2020-09-16:
Yes, we have already updated the PCB. But are still waiting for prototypes for testing.
If you have already ordered the old PCB, you can initialize the following variables
```
int temp = 0;
int speed_l = 0;
int speed_r = 0;
```
disable the interrupts
```
  //attachInterrupt(digitalPinToInterrupt(PIN_SPEED_L), speed_left, RISING);
  //attachInterrupt(digitalPinToInterrupt(PIN_SPEED_R), speed_right, RISING);
```
and use this code snippet in the the main loop to read the speed sensors manually:
```
  temp = digitalRead(PIN_SPEED_L);
  if (temp != speed_l) {
    speed_l=temp;
    speed_left();
  }
  temp = digitalRead(PIN_SPEED_R);
  if (temp != speed_r) {
    speed_r=temp;
    speed_right();
  }
```

Note that one revolution will correspond to 40 ticks now, since every change (RISING + FALLING) is detected.

KevinBuddy, 2020-09-17:
ok, thank you.

thias15, 2020-09-30:
This is addressed in the code now. Simply set the PCB version. No need to add the code above.

KevinBuddy, 2020-09-30:
Thank you.I have a question,in autopilot mode, where is the cmd come from?

Closed 2020-09-17.

Thread 39 (2020-09-18):

Error at "Save tf lite models for best and last checkpoint"

Spilleren, 2020-09-18:
I cant seem to get further than this command, and I have had no luck fixing it myself.

`best_index = np.argmax(np.array(history.history['val_angle_metric']) \
                     + np.array(history.history['val_direction_metric']))
best_checkpoint = str("cp-%04d.ckpt" % (best_index+1))
best_model = utils.load_model(os.path.join(checkpoint_path,best_checkpoint),loss_fn,metric_list)
best_tflite = utils.generate_tflite(checkpoint_path, best_checkpoint)
utils.save_tflite (best_tflite, checkpoint_path, "best")
print("Best Checkpoint (val_angle: %s, val_direction: %s): %s" \
      %(history.history['val_angle_metric'][best_index],\
        history.history['val_direction_metric'][best_index],\
        best_checkpoint))`

It returns the error
`---------------------------------------------------------------------------
ValueError                                Traceback (most recent call last)
<ipython-input-38-62c19ef5d999> in <module>
      2                      + np.array(history.history['val_direction_metric']))
      3 best_checkpoint = str("cp-%04d.ckpt" % (best_index+1))
----> 4 best_model = utils.load_model(os.path.join(checkpoint_path,best_checkpoint),loss_fn,metric_list)
      5 best_tflite = utils.generate_tflite(checkpoint_path, best_checkpoint)
      6 utils.save_tflite (best_tflite, checkpoint_path, "best")

~/git/OpenBot/policy/utils.py in load_model(model_path, loss_fn, metric_list)
     72
     73 def load_model(model_path,loss_fn,metric_list):
---> 74     model = tf.keras.models.load_model(model_path,
     75     custom_objects=None,
     76     compile=False

~/anaconda3/envs/openbot/lib/python3.8/site-packages/tensorflow/python/keras/saving/save.py in load_model(filepath, custom_objects, compile)
    188     if isinstance(filepath, six.string_types):
    189       loader_impl.parse_saved_model(filepath)
--> 190       return saved_model_load.load(filepath, compile)
    191
    192   raise IOError(

~/anaconda3/envs/openbot/lib/python3.8/site-packages/tensorflow/python/keras/saving/saved_model/load.py in load(path, compile)
    114   # TODO(kathywu): Add saving/loading of optimizer, compiled losses and metrics.
    115   # TODO(kathywu): Add code to load from objects that contain all endpoints
--> 116   model = tf_load.load_internal(path, loader_cls=KerasObjectLoader)
    117
    118   # pylint: disable=protected-access

~/anaconda3/envs/openbot/lib/python3.8/site-packages/tensorflow/python/saved_model/load.py in load_internal(export_dir, tags, loader_cls)
    600     object_graph_proto = meta_graph_def.object_graph_def
    601     with ops.init_scope():
--> 602       loader = loader_cls(object_graph_proto,
    603                           saved_model_proto,
    604                           export_dir)

~/anaconda3/envs/openbot/lib/python3.8/site-packages/tensorflow/python/keras/saving/saved_model/load.py in __init__(self, *args, **kwargs)
    186     self._models_to_reconstruct = []
    187
--> 188     super(KerasObjectLoader, self).__init__(*args, **kwargs)
    189
    190     # Now that the node object has been fully loaded, and the checkpoint has

~/anaconda3/envs/openbot/lib/python3.8/site-packages/tensorflow/python/saved_model/load.py in __init__(self, object_graph_proto, saved_model_proto, export_dir)
    121       self._concrete_functions[name] = _WrapperFunction(concrete_function)
    122
--> 123     self._load_all()
    124     self._restore_checkpoint()
    125

~/anaconda3/envs/openbot/lib/python3.8/site-packages/tensorflow/python/keras/saving/saved_model/load.py in _load_all(self)
    207     # loaded from config may create variables / other objects during
    208     # initialization. These are recorded in `_nodes_recreated_from_config`.
--> 209     self._layer_nodes = self._load_layers()
    210
    211     # Load all other nodes and functions.

~/anaconda3/envs/openbot/lib/python3.8/site-packages/tensorflow/python/keras/saving/saved_model/load.py in _load_layers(self)
    310
    311     for node_id, proto in metric_list:
--> 312       layers[node_id] = self._load_layer(proto.user_object, node_id)
    313     return layers
    314

~/anaconda3/envs/openbot/lib/python3.8/site-packages/tensorflow/python/keras/saving/saved_model/load.py in _load_layer(self, proto, node_id)
    335     obj, setter = self._revive_from_config(proto.identifier, metadata, node_id)
    336     if obj is None:
--> 337       obj, setter = revive_custom_object(proto.identifier, metadata)
    338
    339     # Add an attribute that stores the extra functions/objects saved in the

~/anaconda3/envs/openbot/lib/python3.8/site-packages/tensorflow/python/keras/saving/saved_model/load.py in revive_custom_object(identifier, metadata)
    776     return revived_cls._init_from_metadata(metadata)  # pylint: disable=protected-access
    777   else:
--> 778     raise ValueError('Unable to restore custom object of type {} currently. '
    779                      'Please make sure that the layer implements `get_config`'
    780                      'and `from_config` when saving. In addition, please use '

ValueError: Unable to restore custom object of type _tf_keras_metric currently. Please make sure that the layer implements `get_config`and `from_config` when saving. In addition, please use the `custom_objects` arg when calling `load_model()`.
`

Every thing else runs smoothly.

thias15, 2020-09-18:
Can you show the output of the model.fit? Did you change any of the metrics?

Please put code or error output between "```" at the beginning and end, so it is formated for easier reading. You can also use the <> button the comment field.

Spilleren, 2020-09-18:
Haven't changed anything.

My bad!

`Epoch 1/10
664/666 [============================>.] - ETA: 0s - loss: 0.0354 - mean_absolute_error: 0.3235 - direction_metric: 0.7452 - angle_metric: 0.2609WARNING:tensorflow:From /home/bso/anaconda3/envs/openbot/lib/python3.8/site-packages/tensorflow/python/ops/resource_variable_ops.py:1813: calling BaseResourceVariable.__init__ (from tensorflow.python.ops.resource_variable_ops) with constraint is deprecated and will be removed in a future version.
Instructions for updating:
If using Keras pass *_constraint arguments to layers.
INFO:tensorflow:Assets written to: models/my_openbot_pilot_net_lr0.0001_bz16_bn/checkpoints/cp-0001.ckpt/assets
666/666 [==============================] - 36s 54ms/step - loss: 0.0354 - mean_absolute_error: 0.3231 - direction_metric: 0.7456 - angle_metric: 0.2614 - val_loss: 0.0378 - val_mean_absolute_error: 0.2368 - val_direction_metric: 0.6941 - val_angle_metric: 0.2679
Epoch 2/10
665/666 [============================>.] - ETA: 0s - loss: 0.0141 - mean_absolute_error: 0.2061 - direction_metric: 0.7992 - angle_metric: 0.3699INFO:tensorflow:Assets written to: models/my_openbot_pilot_net_lr0.0001_bz16_bn/checkpoints/cp-0002.ckpt/assets
666/666 [==============================] - 13s 20ms/step - loss: 0.0141 - mean_absolute_error: 0.2061 - direction_metric: 0.7993 - angle_metric: 0.3698 - val_loss: 0.0323 - val_mean_absolute_error: 0.2250 - val_direction_metric: 0.7267 - val_angle_metric: 0.3096
Epoch 3/10
665/666 [============================>.] - ETA: 0s - loss: 0.0120 - mean_absolute_error: 0.1963 - direction_metric: 0.8053 - angle_metric: 0.3964INFO:tensorflow:Assets written to: models/my_openbot_pilot_net_lr0.0001_bz16_bn/checkpoints/cp-0003.ckpt/assets
666/666 [==============================] - 13s 20ms/step - loss: 0.0120 - mean_absolute_error: 0.1963 - direction_metric: 0.8052 - angle_metric: 0.3964 - val_loss: 0.0313 - val_mean_absolute_error: 0.2178 - val_direction_metric: 0.7225 - val_angle_metric: 0.3053
Epoch 4/10
664/666 [============================>.] - ETA: 0s - loss: 0.0100 - mean_absolute_error: 0.1848 - direction_metric: 0.8147 - angle_metric: 0.4127INFO:tensorflow:Assets written to: models/my_openbot_pilot_net_lr0.0001_bz16_bn/checkpoints/cp-0004.ckpt/assets
666/666 [==============================] - 13s 20ms/step - loss: 0.0100 - mean_absolute_error: 0.1848 - direction_metric: 0.8142 - angle_metric: 0.4124 - val_loss: 0.0347 - val_mean_absolute_error: 0.2267 - val_direction_metric: 0.7118 - val_angle_metric: 0.3225
Epoch 5/10
665/666 [============================>.] - ETA: 0s - loss: 0.0093 - mean_absolute_error: 0.1814 - direction_metric: 0.8133 - angle_metric: 0.4215INFO:tensorflow:Assets written to: models/my_openbot_pilot_net_lr0.0001_bz16_bn/checkpoints/cp-0005.ckpt/assets
666/666 [==============================] - 14s 20ms/step - loss: 0.0093 - mean_absolute_error: 0.1814 - direction_metric: 0.8133 - angle_metric: 0.4215 - val_loss: 0.0327 - val_mean_absolute_error: 0.2061 - val_direction_metric: 0.7230 - val_angle_metric: 0.3262
Epoch 6/10
665/666 [============================>.] - ETA: 0s - loss: 0.0085 - mean_absolute_error: 0.1778 - direction_metric: 0.8185 - angle_metric: 0.4393INFO:tensorflow:Assets written to: models/my_openbot_pilot_net_lr0.0001_bz16_bn/checkpoints/cp-0006.ckpt/assets
666/666 [==============================] - 14s 21ms/step - loss: 0.0085 - mean_absolute_error: 0.1777 - direction_metric: 0.8187 - angle_metric: 0.4393 - val_loss: 0.0330 - val_mean_absolute_error: 0.2147 - val_direction_metric: 0.7070 - val_angle_metric: 0.3209
Epoch 7/10
665/666 [============================>.] - ETA: 0s - loss: 0.0083 - mean_absolute_error: 0.1772 - direction_metric: 0.8145 - angle_metric: 0.4416INFO:tensorflow:Assets written to: models/my_openbot_pilot_net_lr0.0001_bz16_bn/checkpoints/cp-0007.ckpt/assets
666/666 [==============================] - 13s 20ms/step - loss: 0.0083 - mean_absolute_error: 0.1771 - direction_metric: 0.8147 - angle_metric: 0.4415 - val_loss: 0.0314 - val_mean_absolute_error: 0.2252 - val_direction_metric: 0.7139 - val_angle_metric: 0.3278
Epoch 8/10
665/666 [============================>.] - ETA: 0s - loss: 0.0074 - mean_absolute_error: 0.1719 - direction_metric: 0.8180 - angle_metric: 0.4595INFO:tensorflow:Assets written to: models/my_openbot_pilot_net_lr0.0001_bz16_bn/checkpoints/cp-0008.ckpt/assets
666/666 [==============================] - 13s 20ms/step - loss: 0.0074 - mean_absolute_error: 0.1720 - direction_metric: 0.8181 - angle_metric: 0.4594 - val_loss: 0.0338 - val_mean_absolute_error: 0.2041 - val_direction_metric: 0.7160 - val_angle_metric: 0.3064
Epoch 9/10
665/666 [============================>.] - ETA: 0s - loss: 0.0070 - mean_absolute_error: 0.1680 - direction_metric: 0.8154 - angle_metric: 0.4677INFO:tensorflow:Assets written to: models/my_openbot_pilot_net_lr0.0001_bz16_bn/checkpoints/cp-0009.ckpt/assets
666/666 [==============================] - 13s 20ms/step - loss: 0.0070 - mean_absolute_error: 0.1680 - direction_metric: 0.8153 - angle_metric: 0.4677 - val_loss: 0.0316 - val_mean_absolute_error: 0.1991 - val_direction_metric: 0.7112 - val_angle_metric: 0.3112
Epoch 10/10
665/666 [============================>.] - ETA: 0s - loss: 0.0066 - mean_absolute_error: 0.1646 - direction_metric: 0.8239 - angle_metric: 0.4740INFO:tensorflow:Assets written to: models/my_openbot_pilot_net_lr0.0001_bz16_bn/checkpoints/cp-0010.ckpt/assets
666/666 [==============================] - 13s 20ms/step - loss: 0.0066 - mean_absolute_error: 0.1646 - direction_metric: 0.8238 - angle_metric: 0.4740 - val_loss: 0.0315 - val_mean_absolute_error: 0.2098 - val_direction_metric: 0.7321 - val_angle_metric: 0.3198`

thias15, 2020-09-18:
What's your tensorflow and conda version?

Spilleren, 2020-09-18:
conda is 4.8.3 and tensorflow is 2.2.0

thias15, 2020-09-18:
Try removing the custom metrics in the first cell of the training section.
`metric_list = ['MeanAbsoluteError', metrics.direction_metric, metrics.angle_metric]`
to
`metric_list = ['MeanAbsoluteError']`

In the meantime I'll see if I can reproduce your error somehow.

Spilleren, 2020-09-18:
Hmmm... tried doing as you suggested and now i run into a new error (even if I set the custom metrics back).
When plotting the metrics, it gives a key error.

`plt.plot(history.history['MeanAbsoluteError'], label='mean_absolute_error')
plt.plot(history.history['val_MeanAbsoluteError'], label = 'val_mean_absolute_error')
plt.xlabel('Epoch')
plt.ylabel('Mean Absolute Error')
plt.legend(loc='lower right')
plt.savefig(os.path.join(log_path,'error.png'))`

`KeyError                                  Traceback (most recent call last)
<ipython-input-37-1e2ff90cb985> in <module>
----> 1 plt.plot(history.history['MeanAbsoluteError'], label='mean_absolute_error')
      2 plt.plot(history.history['val_MeanAbsoluteError'], label = 'val_mean_absolute_error')
      3 plt.xlabel('Epoch')
      4 plt.ylabel('Mean Absolute Error')
      5 plt.legend(loc='lower right')`
`KeyError: 'MeanAbsoluteError'`

thias15, 2020-09-18:
You need to restart the kernel and run the notebook again. The plots with the custom metrics won't work.

Spilleren, 2020-09-18:
Okay when running with just
` metric_list = ['MeanAbsoluteError']`

I receive the error
`KeyError                                  Traceback (most recent call last)
<ipython-input-37-62c19ef5d999> in <module>
----> 1 best_index = np.argmax(np.array(history.history['val_angle_metric']) \
      2                      + np.array(history.history['val_direction_metric']))
      3 best_checkpoint = str("cp-%04d.ckpt" % (best_index+1))
      4 best_model = utils.load_model(os.path.join(checkpoint_path,best_checkpoint),loss_fn,metric_list)
      5 best_tflite = utils.generate_tflite(checkpoint_path, best_checkpoint)`

`KeyError: 'val_angle_metric'`

When doing the best_index part.

thias15, 2020-09-18:
Yes. Because you don't have the angle metric now. You need to replace it with `val_mean_absolute_error`

thias15, 2020-09-18:
Can you try adding `import metrics` to the utils.py file?

Spilleren, 2020-09-21:
Added `import metrics` to the utils.py file.
The error doesn't appear at `best_index` now, but has moved down to `best_model`.

````ValueError                                Traceback (most recent call last)
<ipython-input-41-164fa3b8c5aa> in <module>
----> 1 best_model = utils.load_model(os.path.join(checkpoint_path,best_checkpoint),loss_fn,metric_list)
      2 test_loss, test_acc, test_dir, test_ang = best_model.evaluate(test_ds, steps=image_count_test/TEST_BATCH_SIZE, verbose=2)

~/git/OpenBot/policy/utils.py in load_model(model_path, loss_fn, metric_list)
     73
     74 def load_model(model_path,loss_fn,metric_list):
---> 75     model = tf.keras.models.load_model(model_path,
     76     custom_objects=None,
     77     compile=False

~/anaconda3/envs/openbot/lib/python3.8/site-packages/tensorflow/python/keras/saving/save.py in load_model(filepath, custom_objects, compile)
    188     if isinstance(filepath, six.string_types):
    189       loader_impl.parse_saved_model(filepath)
--> 190       return saved_model_load.load(filepath, compile)
    191
    192   raise IOError(

~/anaconda3/envs/openbot/lib/python3.8/site-packages/tensorflow/python/keras/saving/saved_model/load.py in load(path, compile)
    114   # TODO(kathywu): Add saving/loading of optimizer, compiled losses and metrics.
    115   # TODO(kathywu): Add code to load from objects that contain all endpoints
--> 116   model = tf_load.load_internal(path, loader_cls=KerasObjectLoader)
    117
    118   # pylint: disable=protected-access

~/anaconda3/envs/openbot/lib/python3.8/site-packages/tensorflow/python/saved_model/load.py in load_internal(export_dir, tags, loader_cls)
    600     object_graph_proto = meta_graph_def.object_graph_def
    601     with ops.init_scope():
--> 602       loader = loader_cls(object_graph_proto,
    603                           saved_model_proto,
    604                           export_dir)

~/anaconda3/envs/openbot/lib/python3.8/site-packages/tensorflow/python/keras/saving/saved_model/load.py in __init__(self, *args, **kwargs)
    186     self._models_to_reconstruct = []
    187
--> 188     super(KerasObjectLoader, self).__init__(*args, **kwargs)
    189
    190     # Now that the node object has been fully loaded, and the checkpoint has

~/anaconda3/envs/openbot/lib/python3.8/site-packages/tensorflow/python/saved_model/load.py in __init__(self, object_graph_proto, saved_model_proto, export_dir)
    121       self._concrete_functions[name] = _WrapperFunction(concrete_function)
    122
--> 123     self._load_all()
    124     self._restore_checkpoint()
    125

~/anaconda3/envs/openbot/lib/python3.8/site-packages/tensorflow/python/keras/saving/saved_model/load.py in _load_all(self)
    207     # loaded from config may create variables / other objects during
    208     # initialization. These are recorded in `_nodes_recreated_from_config`.
--> 209     self._layer_nodes = self._load_layers()
    210
    211     # Load all other nodes and functions.

~/anaconda3/envs/openbot/lib/python3.8/site-packages/tensorflow/python/keras/saving/saved_model/load.py in _load_layers(self)
    310
    311     for node_id, proto in metric_list:
--> 312       layers[node_id] = self._load_layer(proto.user_object, node_id)
    313     return layers
    314

~/anaconda3/envs/openbot/lib/python3.8/site-packages/tensorflow/python/keras/saving/saved_model/load.py in _load_layer(self, proto, node_id)
    335     obj, setter = self._revive_from_config(proto.identifier, metadata, node_id)
    336     if obj is None:
--> 337       obj, setter = revive_custom_object(proto.identifier, metadata)
    338
    339     # Add an attribute that stores the extra functions/objects saved in the

~/anaconda3/envs/openbot/lib/python3.8/site-packages/tensorflow/python/keras/saving/saved_model/load.py in revive_custom_object(identifier, metadata)
    776     return revived_cls._init_from_metadata(metadata)  # pylint: disable=protected-access
    777   else:
--> 778     raise ValueError('Unable to restore custom object of type {} currently. '
    779                      'Please make sure that the layer implements `get_config`'
    780                      'and `from_config` when saving. In addition, please use '

ValueError: Unable to restore custom object of type _tf_keras_metric currently. Please make sure that the layer implements `get_config`and `from_config` when saving. In addition, please use the `custom_objects` arg when calling `load_model()`.`````

thias15, 2020-09-21:
Can you pass the two custom metrics with the custom_objects arg?

If this does not work, you can also try the following workaround.
Above the cell that throws the error, define this function.
```
def load_model(model_path):
    model = tf.keras.models.load_model(model_path,
    custom_objects=None,
    compile=False
    )
    model.compile(loss=loss_fn,
                  metrics=metric_list)
    return model
```

In the cell that throws the error, replace
```
best_model = utils.load_model(os.path.join(checkpoint_path,best_checkpoint),loss_fn,metric_list)
```
with
```
best_model = load_model(os.path.join(checkpoint_path,best_checkpoint))
```

Spilleren, 2020-09-22:
Okay now things are cooking op nicely.

Redefined the function as you said, however i added custom_object as parameter.

`def load_model(model_path, custom_object):
    model = tf.keras.models.load_model(model_path,
    custom_objects=custom_object,
    compile=False
    )
    model.compile(loss=loss_fn,
                  metrics=metric_list)
    return model`

Then i could pass the custom metrics as a dict.

`best_model = load_model(os.path.join(checkpoint_path,best_checkpoint),{'direction_metric':metrics.direction_metric, 'angle_metric':metrics.angle_metric},)
`

Guess I could have changed the load_model in utils.py the same way and have gotten the same result.

Thank you for the help! I will get started on teaching my robot some policies.

thias15, 2020-09-22:
Did the function inside the notebook work without passing custom objects? This would indicate it's an issue with the scope. Yes, passing the dictionary of custom objects and leaving the code in util should also work.

Trying to figure out why you were facing the issue since other including myself don't. If we understand why, we can fix it for others that may come across this issue. Main reason why I prefer not to pass is in case people change the metric dictionary. But maybe it makes sense to just pass all custom metrics, just in case.

Spilleren, 2020-09-23:
Nope it didn't work without passing. Still getting the same error as before.

Ah yes makes sense. So far I've tried running the code on my laptop and my workstation, both result in the same error. Both running on Ubuntu 18.04.

thias15, 2020-09-23:
Strange, I have been able to run it without problems on Ubuntu 18.04, also on Mac and Windows. Are you using a conda environment? If yes, what is the version of conda, tensorflow and jupyter notebook?

Spilleren, 2020-09-24:
Okay so i messed up my ubuntu partition yesterday and had to do a fresh install. Thought i would test out this one, before installing anything else. The error still occurred with a fresh install and fresh git clone.

I am running conda version 4.8.3
Tensorflow 2.2
jupyter notebook 6.0.3

thias15, 2020-09-24:
I see. I'm using tf 2.0.0. Maybe this is a 'new feature'.

thias15, 2020-09-24:
Could you do me a favour and try to install this environment:
`conda create -n openbot_test python=3.7 tensorflow=2.0.0 notebook=6.1.1 matplotlib=3.3.1 pillow=7.2.0`

Spilleren, 2020-09-25:
Yup it seems to work now. So it looks lige a "new feature"...

How ever it didn't use the gpu for the calculations as default, as it did with 2.2.
Is there a way to force it to use gpu?

thias15, 2020-09-25:
If you want to use the GPU, you need to install `tensorflow-gpu`.

thias15, 2020-09-25:
> Yup it seems to work now. So it looks lige a "new feature"...

Great, I will add a note then for people that want to use newer versions of tensorflow.
It's not high priority, but if I get a chance, I may update the code and port it to tf2.2.
However, on Mac for example tf2.0 still gets installed by default.

Closed 2020-09-26.

Thread 41 (2020-09-18):

the slim version doesn't fit on plate 223x223

ronki2304, 2020-09-18:
Hello I tried to print the slim version

but body_top_slim.stl doesn't fit

I used an ultimaker 2 which have a plate of 223*223mm

thias15, 2020-09-18:
Did you rotate it by 45 degrees?

ronki2304, 2020-09-18:
Yes I have rotated it

the bottom filled  perfectely but not the top

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

I see your PR, I don't know what is the difference, but the model doesn't fit on cura

thias15, 2020-09-18:
In the bottom left, the dimensions show as 223x223. Is there maybe some setting in Cura?

thias15, 2020-09-19:
Any luck?

ronki2304, 2020-09-21:
Hello sorry for my late answer,

what do you mean by some settings ???? those dimensions are the piece one on the build plate

thias15, 2020-09-21:
Well, you have an ultimaker 2 which as a build plate of 223x223. The model is also 223x223, so it should fit. So you probably have some setting enabled which prevents you from using the complete build area.

- Have you selected build plate adhesion with a brim or a skirt?
This will increase the overall size of your print.
To disable it, set *Build Plate Adhesion Type* to "None".

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

Other settings that are probably not necessary, but may help to fit the model:
- Disable the second extruder
- Disable prime blob (under build plate adhesion)

ronki2304, 2020-09-21:
Hello,
the build plate adhesion is already set to off and I don't have a second extruder,

i tried to change the g-code flavor but I don't see any change. i don't which setup has been made by @katnoria in [PR#2](https://github.com/intel-isl/OpenBot/issues/2)

thias15, 2020-09-21:
@ronki2304 Please try https://github.com/intel-isl/OpenBot/blob/develop/body/slim_body/slim_body_top.stl from the development branch. If this does not work, checkout the glueable model.

ronki2304, 2020-09-21:
OK it works thank you very much

Closed 2020-09-21.

Thread 45 (2020-09-19):

有了PCB版，和组件的接线是什么样的？

2like, 2020-09-19:
@zhaoyshine
如题，能否补充下中文版readme。

zhaoyshine, 2020-09-19:
抱歉我按选项一来的，选项二这块我不太清楚，选项一走线我选的 杜邦线 母-母、公-母、公-公接头我各准备了十根，应该够用。目前我东西也还在路上，没有开始

2like, 2020-09-19:
等你选项一的好消息！
@zhaoyshine

thias15, 2020-09-20:
Is this issue resolved?

2like, 2020-09-21:
> Is this issue resolved?

Can you give a detailed description of how to use PCB

thias15, 2020-09-21:
- Attach Arduino Nano to the U1 header
- Connect motors to M1-M4
- Connect power source to Vin
- Connect sensors to the appropriate header pins

2like, 2020-10-09:
> 抱歉我按选项一来的，选项二这块我不太清楚，选项一走线我选的 杜邦线 母-母、公-母、公-公接头我各准备了十根，应该够用。目前我东西也还在路上，没有开始

杜邦线怎么买？搞定了吗？

zhaoyshine, 2020-10-10:
早搞定了，杜邦线 母-母、公-母、公-公接头我各准备了十根，淘宝大把随便买。体验下来自动跟随人体识别有点不行，随便一件衣服就识别成人了，不能稳定跟某一个人，目前一直在玩手柄模式

zhaoyshine, 2020-10-10:
这个是我demo版时拍的照片，应该是对的
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

Closed 2020-09-22.

Thread 46 (2020-09-19):

Consider tagging "releases" to help us make sense of PCB and firmware revs

DiggidyDave, 2020-09-19:
I have v1 of the PCB and was getting ready to assemble with my daughter and see now that you have a V2 of the PCB and firmware has changed etc. It isn't clear to me which commit to checkout to have a working, coherent "v1" repository that should mostly just work if I follow directions in the READMEs.

thias15, 2020-09-20:
All the demos work with the firmware as it is. The PCB mainly has cosmetic changes, there are just two functional changes related to voltage monitoring and speed sensing. Neither are currently used the app. I did not get a chance yet to update the code for the Arduino. But it will have a flag for PCBv1 and PCBv2.

DiggidyDave, 2020-09-20:
Thanks for responding, @thias15 To be clear, I'm not talking about build flags etc, I'm talking about commit tagging in git.

I think you have an amazing project here that likely has legs (1.4k stars already!).  I think you and the community around this will have fewer headaches over time with a sensible versioning and release tagging strategy sooner rather than later.  Imagine a future where you are on the 7th rev of the PCB and there are 1000 commits in source, and my arduino breaks... I just want to be able to checkout v1.0.0 (the release that I build my bot from, as opposed to 7.1.8 or whatever you happen to be on at that time) and have 100% confidence that the firmware and source will work. :-)

In any case, keep up the awesome work, this is a fantastic project. I'm hoping to complete my first build of it with my daughter today.

thias15, 2020-09-20:
@DiggidyDave Yes, I understand and there will be tagged releases in the future for sure. However, there are still a few small things I'm working on which I wanted to iron out before tagging the first release. I want to make sure at least a few people were able to complete all steps in the project. The challenge is also to find a good release strategy across the different components (e.g. people may have the old PCB, but still like new features in the firmware, the Android app, etc.) Ideally, each component could be tagged seperately, but I guess the only way to achieve this would be seperate repos and then add them as submodules. Then, it could be that releases of submodules will not be compatible with each other. I guess, in addition there could be releases across the repo with the submodules. If you have some suggestions, please let me know. As I mentioned, for now my plan was to add build flags to the Arduino code to support different PCBs.

DiggidyDave, 2020-09-20:
Agreed, I almost mentioned having independently versioned "projects" but that felt heavy for the current young state of the project. Cool, thanks for your responses! If I have any lightweight ideas/suggestions in the near term I'll pass them along.

thias15, 2020-09-30:
Just for your info, we just released [v0.1.0](https://github.com/intel-isl/OpenBot/releases/tag/v0.1.0).

Closed 2020-09-20.

Thread 47 (2020-09-20):

Unable to compile the firmware

Cantfigurethisout, 2020-09-20:
I am new to this kind of thing, I realized that the firmware needed to get to the arduino board however if you read the documentation it mentions nothing.  I downloaded arduino IDE added the board in the board manager and sent the file to the board.  Got lots of errors in the IDE (don't know if it was something I did), tried to get the thing to drive....... nothing.  After multimeter testing terminals realized pins needed to be uncommented in the firmware.........sent it to the board with a large list of errors.  Still not getting any wheel spinning.  Scratching my head as to the issue.  I have bought everything to stick with the build as documented hoping I could have my handheld as build this.

thias15, 2020-09-20:
What error are you getting? You shouldn't need to comment anything.

thias15, 2020-09-20:
Did you install the NewPing library?

thias15, 2020-09-20:
Also let me give a general recommendation for issues in open-source projects.
1) Don't complain, be nice when asking for help. This is an open-source project. Nobody wants to help a complainer.
2) Be specific about your error. Include screenshots, error logs, etc.
3) If you feel things could be done better, improve them and send a pull request.

crearo, 2020-09-20:
+1 for @thias15 's comment. This is actually one of the best documented hardware+software+3D-printing projects I've seen on GitHub!

Apart from writing out what exactly your current setup is, write about your problem specifically.
Additionally, don't expect this project to have a start-from-scratch guide. If you're new, do you research on things you don't understand first.

Cantfigurethisout, 2020-09-20:
Didn't mean to be a complainer, I apologize for sounding that way, just trying to identify an area that was lacking (everything else has been fairly well documented, or at least it is mentioned what needs to be done).

"You shouldn't need to comment anything."  Don't you have to delete some of the hashtag things to make it work?

#if (OPENBOT == DIY)
  #define PIN_PWM1 5
  #define PIN_PWM2 6
  #define PIN_PWM3 9
  #define PIN_PWM4 10
  #define PIN_SPEED_L 2
  #define PIN_SPEED_R 3
  #define PIN_VIN A7
  #define PIN_TRIGGER   4
  #define PIN_ECHO      4
  #define PIN_LED_RL 7
  #define PIN_LED_RR 8
#elif (OPENBOT == PCB)
  #define PIN_PWM1 10
  #define PIN_PWM2 9
  #define PIN_PWM3 5
  #define PIN_PWM4 6
  #define PIN_SPEED_L 2
  #define PIN_SPEED_R 4
  #define PIN_VIN A7
  #define PIN_TRIGGER   3
  #define PIN_ECHO      3
  #define PIN_LED_RL 7
  #define PIN_LED_RR 8
#endif

As far as errors go I got a lot, need to spend more time with it to make sure I am not doing anything dumb.  Not intending to ask for help yet on fixing my setup, like I said noticed an area that was lacking and wanted to point it out.

If I was going to complain I would start with not being able to print on my ender 3 because the dimensions of the car are too big.  My solution for this sucked and I want to re-do it, if that is halfway decent I will post it so others with a smaller print volume can use it as well.

parixit, 2020-09-20:
Those aren't comments.  These are comments:
// ---------------------------------------------------------------------------
// This Arduino sketch accompanies the OpenBot Android application.
//
// The sketch has the following functinonalities:
//  - receive control commands from Android application (USB serial)
//. - produce low-level controls (PWM) for the vehicle
//  - toggle left and right indicator signals
//  - wheel odometry based on optical speed sensors
//  - estimate battery voltage via voltage divider
//  - estimate distance based on sonar sensor
//  - send sensor readings to Android application (USB serial)
//
//  Dependencies (if sonar is required):
//  - NewPing library by Tim Eckel (Install via Tools --> Manage Libraries)
//
// By Matthias Mueller, Intelligent Systems Lab, 2020
// ---------------------------------------------------------------------------

// PIN_PWM1,PIN_PWM2,PIN_PWM3,PIN_PWM4      Low-level control of left DC motors via PWM
// PIN_SPEED_L, PIN_SPEED_R                  Measure left and right wheel speed
// PIN_VIN                                  Measure battery voltage via voltage divider
// PIN_TRIGGER                              Arduino pin tied to trigger pin on ultrasonic sensor.
// PIN_ECHO                                 Arduino pin tied to echo pin on ultrasonic sensor.
// MAX_DISTANCE                             Maximum distance we want to ping for (in centimeters).
// PIN_LED_RL, PIN_LED_RR                   Toggle left and right rear LEDs (indicator signals)

//------------------------------------------------------//
//DEFINITIONS
//------------------------------------------------------//

thias15, 2020-09-20:
@Cantfigurethisout What you posted are the pin definitions. You just need to set if you are using the DIY or the PCB version. That's all.

If you are building the robot using the DIY instructions just leave as it is:
```
// Setup the OpenBot version
#define OPENBOT DIY
```

If you are using the PCB then change it to:
```
#define OPENBOT PCB
```

What is the size of the build plate on your 3D printer?

thias15, 2020-09-20:
@Cantfigurethisout I just merged a PR that adds a flag to disable the sonar. Try setting `HAS_SONAR 0`. This will remove compile errors related to not installing the NewPing library.

thias15, 2020-09-21:
@Cantfigurethisout any updates?

By the way check out the new [slim model](https://github.com/intel-isl/OpenBot/blob/master/body/cad/slim_body). Top and bottom both fit on a 220mmx220mm build plate. If this is still too big, check out the [glueable model](https://github.com/intel-isl/OpenBot/blob/master/body/cad/glue_body).

Cantfigurethisout, 2020-09-21:
Haven't gotten back to this.  I saw the slim model, however my build volume is 200x200 (I hear this can be increased with open source firmware on my printer however I haven't gotten to that yet).  Didn't see the glueable model, I will look for that. Thanks

Cantfigurethisout, 2020-09-22:
Ok, I tried again, enabled Verbose logging so if this is too much, I apologize.  Copied error code:

Arduino: 1.8.13 (Windows 10), Board: "Arduino NANO 33 IoT"

C:\Program Files (x86)\Arduino\arduino-builder -dump-prefs -logger=machine -hardware C:\Program Files (x86)\Arduino\hardware -hardware C:\Users\jresp\AppData\Local\Arduino15\packages -tools C:\Program Files (x86)\Arduino\tools-builder -tools C:\Program Files (x86)\Arduino\hardware\tools\avr -tools C:\Users\jresp\AppData\Local\Arduino15\packages -built-in-libraries C:\Program Files (x86)\Arduino\libraries -libraries C:\Users\jresp\OneDrive\Documents\Arduino\libraries -fqbn=arduino:samd:nano_33_iot -vid-pid=2341_8057 -ide-version=10813 -build-path C:\Users\jresp\AppData\Local\Temp\arduino_build_869510 -warnings=none -build-cache C:\Users\jresp\AppData\Local\Temp\arduino_cache_836998 -prefs=build.warn_data_percentage=75 -prefs=runtime.tools.arduinoOTA.path=C:\Users\jresp\AppData\Local\Arduino15\packages\arduino\tools\arduinoOTA\1.2.1 -prefs=runtime.tools.arduinoOTA-1.2.1.path=C:\Users\jresp\AppData\Local\Arduino15\packages\arduino\tools\arduinoOTA\1.2.1 -prefs=runtime.tools.arm-none-eabi-gcc.path=C:\Users\jresp\AppData\Local\Arduino15\packages\arduino\tools\arm-none-eabi-gcc\7-2017q4 -prefs=runtime.tools.arm-none-eabi-gcc-7-2017q4.path=C:\Users\jresp\AppData\Local\Arduino15\packages\arduino\tools\arm-none-eabi-gcc\7-2017q4 -prefs=runtime.tools.bossac.path=C:\Users\jresp\AppData\Local\Arduino15\packages\arduino\tools\bossac\1.7.0-arduino3 -prefs=runtime.tools.bossac-1.7.0-arduino3.path=C:\Users\jresp\AppData\Local\Arduino15\packages\arduino\tools\bossac\1.7.0-arduino3 -prefs=runtime.tools.CMSIS.path=C:\Users\jresp\AppData\Local\Arduino15\packages\arduino\tools\CMSIS\4.5.0 -prefs=runtime.tools.CMSIS-4.5.0.path=C:\Users\jresp\AppData\Local\Arduino15\packages\arduino\tools\CMSIS\4.5.0 -prefs=runtime.tools.CMSIS-Atmel.path=C:\Users\jresp\AppData\Local\Arduino15\packages\arduino\tools\CMSIS-Atmel\1.2.0 -prefs=runtime.tools.CMSIS-Atmel-1.2.0.path=C:\Users\jresp\AppData\Local\Arduino15\packages\arduino\tools\CMSIS-Atmel\1.2.0 -prefs=runtime.tools.openocd.path=C:\Users\jresp\AppData\Local\Arduino15\packages\arduino\tools\openocd\0.10.0-arduino7 -prefs=runtime.tools.openocd-0.10.0-arduino7.path=C:\Users\jresp\AppData\Local\Arduino15\packages\arduino\tools\openocd\0.10.0-arduino7 -verbose C:\Users\jresp\Downloads\OpenBot-master\firmware\openbot_v1_nano\openbot_v1_nano.ino

C:\Program Files (x86)\Arduino\arduino-builder -compile -logger=machine -hardware C:\Program Files (x86)\Arduino\hardware -hardware C:\Users\jresp\AppData\Local\Arduino15\packages -tools C:\Program Files (x86)\Arduino\tools-builder -tools C:\Program Files (x86)\Arduino\hardware\tools\avr -tools C:\Users\jresp\AppData\Local\Arduino15\packages -built-in-libraries C:\Program Files (x86)\Arduino\libraries -libraries C:\Users\jresp\OneDrive\Documents\Arduino\libraries -fqbn=arduino:samd:nano_33_iot -vid-pid=2341_8057 -ide-version=10813 -build-path C:\Users\jresp\AppData\Local\Temp\arduino_build_869510 -warnings=none -build-cache C:\Users\jresp\AppData\Local\Temp\arduino_cache_836998 -prefs=build.warn_data_percentage=75 -prefs=runtime.tools.arduinoOTA.path=C:\Users\jresp\AppData\Local\Arduino15\packages\arduino\tools\arduinoOTA\1.2.1 -prefs=runtime.tools.arduinoOTA-1.2.1.path=C:\Users\jresp\AppData\Local\Arduino15\packages\arduino\tools\arduinoOTA\1.2.1 -prefs=runtime.tools.arm-none-eabi-gcc.path=C:\Users\jresp\AppData\Local\Arduino15\packages\arduino\tools\arm-none-eabi-gcc\7-2017q4 -prefs=runtime.tools.arm-none-eabi-gcc-7-2017q4.path=C:\Users\jresp\AppData\Local\Arduino15\packages\arduino\tools\arm-none-eabi-gcc\7-2017q4 -prefs=runtime.tools.bossac.path=C:\Users\jresp\AppData\Local\Arduino15\packages\arduino\tools\bossac\1.7.0-arduino3 -prefs=runtime.tools.bossac-1.7.0-arduino3.path=C:\Users\jresp\AppData\Local\Arduino15\packages\arduino\tools\bossac\1.7.0-arduino3 -prefs=runtime.tools.CMSIS.path=C:\Users\jresp\AppData\Local\Arduino15\packages\arduino\tools\CMSIS\4.5.0 -prefs=runtime.tools.CMSIS-4.5.0.path=C:\Users\jresp\AppData\Local\Arduino15\packages\arduino\tools\CMSIS\4.5.0 -prefs=runtime.tools.CMSIS-Atmel.path=C:\Users\jresp\AppData\Local\Arduino15\packages\arduino\tools\CMSIS-Atmel\1.2.0 -prefs=runtime.tools.CMSIS-Atmel-1.2.0.path=C:\Users\jresp\AppData\Local\Arduino15\packages\arduino\tools\CMSIS-Atmel\1.2.0 -prefs=runtime.tools.openocd.path=C:\Users\jresp\AppData\Local\Arduino15\packages\arduino\tools\openocd\0.10.0-arduino7 -prefs=runtime.tools.openocd-0.10.0-arduino7.path=C:\Users\jresp\AppData\Local\Arduino15\packages\arduino\tools\openocd\0.10.0-arduino7 -verbose C:\Users\jresp\Downloads\OpenBot-master\firmware\openbot_v1_nano\openbot_v1_nano.ino

Using board 'nano_33_iot' from platform in folder: C:\Users\jresp\AppData\Local\Arduino15\packages\arduino\hardware\samd\1.8.8

Using core 'arduino' from platform in folder: C:\Users\jresp\AppData\Local\Arduino15\packages\arduino\hardware\samd\1.8.8

Detecting libraries used...

"C:\\Users\\jresp\\AppData\\Local\\Arduino15\\packages\\arduino\\tools\\arm-none-eabi-gcc\\7-2017q4/bin/arm-none-eabi-g++" -mcpu=cortex-m0plus -mthumb -c -g -Os -w -std=gnu++11 -ffunction-sections -fdata-sections -fno-threadsafe-statics -nostdlib --param max-inline-insns-single=500 -fno-rtti -fno-exceptions -w -x c++ -E -CC -DF_CPU=48000000L -DARDUINO=10813 -DARDUINO_SAMD_NANO_33_IOT -DARDUINO_ARCH_SAMD -DCRYSTALLESS -D__SAMD21G18A__ -DUSB_VID=0x2341 -DUSB_PID=0x8057 -DUSBCON "-DUSB_MANUFACTURER=\"Arduino LLC\"" "-DUSB_PRODUCT=\"Arduino NANO 33 IoT\"" "-IC:\\Users\\jresp\\AppData\\Local\\Arduino15\\packages\\arduino\\tools\\CMSIS\\4.5.0/CMSIS/Include/" "-IC:\\Users\\jresp\\AppData\\Local\\Arduino15\\packages\\arduino\\tools\\CMSIS-Atmel\\1.2.0/CMSIS/Device/ATMEL/" "-IC:\\Users\\jresp\\AppData\\Local\\Arduino15\\packages\\arduino\\hardware\\samd\\1.8.8\\cores\\arduino" "-IC:\\Users\\jresp\\AppData\\Local\\Arduino15\\packages\\arduino\\hardware\\samd\\1.8.8\\variants\\nano_33_iot" "C:\\Users\\jresp\\AppData\\Local\\Temp\\arduino_build_869510\\sketch\\openbot_v1_nano.ino.cpp" -o nul -DARDUINO_LIB_DISCOVERY_PHASE

Alternatives for NewPing.h: [NewPing@1.9.1]

ResolveLibrary(NewPing.h)

  -> candidates: [NewPing@1.9.1]

"C:\\Users\\jresp\\AppData\\Local\\Arduino15\\packages\\arduino\\tools\\arm-none-eabi-gcc\\7-2017q4/bin/arm-none-eabi-g++" -mcpu=cortex-m0plus -mthumb -c -g -Os -w -std=gnu++11 -ffunction-sections -fdata-sections -fno-threadsafe-statics -nostdlib --param max-inline-insns-single=500 -fno-rtti -fno-exceptions -w -x c++ -E -CC -DF_CPU=48000000L -DARDUINO=10813 -DARDUINO_SAMD_NANO_33_IOT -DARDUINO_ARCH_SAMD -DCRYSTALLESS -D__SAMD21G18A__ -DUSB_VID=0x2341 -DUSB_PID=0x8057 -DUSBCON "-DUSB_MANUFACTURER=\"Arduino LLC\"" "-DUSB_PRODUCT=\"Arduino NANO 33 IoT\"" "-IC:\\Users\\jresp\\AppData\\Local\\Arduino15\\packages\\arduino\\tools\\CMSIS\\4.5.0/CMSIS/Include/" "-IC:\\Users\\jresp\\AppData\\Local\\Arduino15\\packages\\arduino\\tools\\CMSIS-Atmel\\1.2.0/CMSIS/Device/ATMEL/" "-IC:\\Users\\jresp\\AppData\\Local\\Arduino15\\packages\\arduino\\hardware\\samd\\1.8.8\\cores\\arduino" "-IC:\\Users\\jresp\\AppData\\Local\\Arduino15\\packages\\arduino\\hardware\\samd\\1.8.8\\variants\\nano_33_iot" "-IC:\\Users\\jresp\\OneDrive\\Documents\\Arduino\\libraries\\NewPing\\src" "C:\\Users\\jresp\\AppData\\Local\\Temp\\arduino_build_869510\\sketch\\openbot_v1_nano.ino.cpp" -o nul -DARDUINO_LIB_DISCOVERY_PHASE

"C:\\Users\\jresp\\AppData\\Local\\Arduino15\\packages\\arduino\\tools\\arm-none-eabi-gcc\\7-2017q4/bin/arm-none-eabi-g++" -mcpu=cortex-m0plus -mthumb -c -g -Os -w -std=gnu++11 -ffunction-sections -fdata-sections -fno-threadsafe-statics -nostdlib --param max-inline-insns-single=500 -fno-rtti -fno-exceptions -w -x c++ -E -CC -DF_CPU=48000000L -DARDUINO=10813 -DARDUINO_SAMD_NANO_33_IOT -DARDUINO_ARCH_SAMD -DCRYSTALLESS -D__SAMD21G18A__ -DUSB_VID=0x2341 -DUSB_PID=0x8057 -DUSBCON "-DUSB_MANUFACTURER=\"Arduino LLC\"" "-DUSB_PRODUCT=\"Arduino NANO 33 IoT\"" "-IC:\\Users\\jresp\\AppData\\Local\\Arduino15\\packages\\arduino\\tools\\CMSIS\\4.5.0/CMSIS/Include/" "-IC:\\Users\\jresp\\AppData\\Local\\Arduino15\\packages\\arduino\\tools\\CMSIS-Atmel\\1.2.0/CMSIS/Device/ATMEL/" "-IC:\\Users\\jresp\\AppData\\Local\\Arduino15\\packages\\arduino\\hardware\\samd\\1.8.8\\cores\\arduino" "-IC:\\Users\\jresp\\AppData\\Local\\Arduino15\\packages\\arduino\\hardware\\samd\\1.8.8\\variants\\nano_33_iot" "-IC:\\Users\\jresp\\OneDrive\\Documents\\Arduino\\libraries\\NewPing\\src" "C:\\Users\\jresp\\OneDrive\\Documents\\Arduino\\libraries\\NewPing\\src\\NewPing.cpp" -o nul -DARDUINO_LIB_DISCOVERY_PHASE

WARNING: library NewPing claims to run on avr, arm architecture(s) and may be incompatible with your current board which runs on samd architecture(s).

Generating function prototypes...

"C:\\Users\\jresp\\AppData\\Local\\Arduino15\\packages\\arduino\\tools\\arm-none-eabi-gcc\\7-2017q4/bin/arm-none-eabi-g++" -mcpu=cortex-m0plus -mthumb -c -g -Os -w -std=gnu++11 -ffunction-sections -fdata-sections -fno-threadsafe-statics -nostdlib --param max-inline-insns-single=500 -fno-rtti -fno-exceptions -w -x c++ -E -CC -DF_CPU=48000000L -DARDUINO=10813 -DARDUINO_SAMD_NANO_33_IOT -DARDUINO_ARCH_SAMD -DCRYSTALLESS -D__SAMD21G18A__ -DUSB_VID=0x2341 -DUSB_PID=0x8057 -DUSBCON "-DUSB_MANUFACTURER=\"Arduino LLC\"" "-DUSB_PRODUCT=\"Arduino NANO 33 IoT\"" "-IC:\\Users\\jresp\\AppData\\Local\\Arduino15\\packages\\arduino\\tools\\CMSIS\\4.5.0/CMSIS/Include/" "-IC:\\Users\\jresp\\AppData\\Local\\Arduino15\\packages\\arduino\\tools\\CMSIS-Atmel\\1.2.0/CMSIS/Device/ATMEL/" "-IC:\\Users\\jresp\\AppData\\Local\\Arduino15\\packages\\arduino\\hardware\\samd\\1.8.8\\cores\\arduino" "-IC:\\Users\\jresp\\AppData\\Local\\Arduino15\\packages\\arduino\\hardware\\samd\\1.8.8\\variants\\nano_33_iot" "-IC:\\Users\\jresp\\OneDrive\\Documents\\Arduino\\libraries\\NewPing\\src" "C:\\Users\\jresp\\AppData\\Local\\Temp\\arduino_build_869510\\sketch\\openbot_v1_nano.ino.cpp" -o "C:\\Users\\jresp\\AppData\\Local\\Temp\\arduino_build_869510\\preproc\\ctags_target_for_gcc_minus_e.cpp" -DARDUINO_LIB_DISCOVERY_PHASE

"C:\\Program Files (x86)\\Arduino\\tools-builder\\ctags\\5.8-arduino11/ctags" -u --language-force=c++ -f - --c++-kinds=svpf --fields=KSTtzns --line-directives "C:\\Users\\jresp\\AppData\\Local\\Temp\\arduino_build_869510\\preproc\\ctags_target_for_gcc_minus_e.cpp"

Compiling sketch...

"C:\\Users\\jresp\\AppData\\Local\\Arduino15\\packages\\arduino\\tools\\arm-none-eabi-gcc\\7-2017q4/bin/arm-none-eabi-g++" -mcpu=cortex-m0plus -mthumb -c -g -Os -w -std=gnu++11 -ffunction-sections -fdata-sections -fno-threadsafe-statics -nostdlib --param max-inline-insns-single=500 -fno-rtti -fno-exceptions -MMD -DF_CPU=48000000L -DARDUINO=10813 -DARDUINO_SAMD_NANO_33_IOT -DARDUINO_ARCH_SAMD -DCRYSTALLESS -D__SAMD21G18A__ -DUSB_VID=0x2341 -DUSB_PID=0x8057 -DUSBCON "-DUSB_MANUFACTURER=\"Arduino LLC\"" "-DUSB_PRODUCT=\"Arduino NANO 33 IoT\"" "-IC:\\Users\\jresp\\AppData\\Local\\Arduino15\\packages\\arduino\\tools\\CMSIS\\4.5.0/CMSIS/Include/" "-IC:\\Users\\jresp\\AppData\\Local\\Arduino15\\packages\\arduino\\tools\\CMSIS-Atmel\\1.2.0/CMSIS/Device/ATMEL/" "-IC:\\Users\\jresp\\AppData\\Local\\Arduino15\\packages\\arduino\\hardware\\samd\\1.8.8\\cores\\arduino" "-IC:\\Users\\jresp\\AppData\\Local\\Arduino15\\packages\\arduino\\hardware\\samd\\1.8.8\\variants\\nano_33_iot" "-IC:\\Users\\jresp\\OneDrive\\Documents\\Arduino\\libraries\\NewPing\\src" "C:\\Users\\jresp\\AppData\\Local\\Temp\\arduino_build_869510\\sketch\\openbot_v1_nano.ino.cpp" -o "C:\\Users\\jresp\\AppData\\Local\\Temp\\arduino_build_869510\\sketch\\openbot_v1_nano.ino.cpp.o"

C:\Users\jresp\Downloads\OpenBot-master\firmware\openbot_v1_nano\openbot_v1_nano.ino: In function 'void loop()':

openbot_v1_nano:161:11: error: 'class NewPing' has no member named 'ping_timer'; did you mean 'ping_trigger'?

     sonar.ping_timer(echoCheck);  // Send out the ping, calls "echoCheck" function every 24uS where you can check the ping status.

           ^~~~~~~~~~

           ping_trigger

C:\Users\jresp\Downloads\OpenBot-master\firmware\openbot_v1_nano\openbot_v1_nano.ino: In function 'void echoCheck()':

openbot_v1_nano:353:13: error: 'class NewPing' has no member named 'check_timer'

   if (sonar.check_timer()) { // Check ping status

             ^~~~~~~~~~~

openbot_v1_nano:354:25: error: 'class NewPing' has no member named 'ping_result'; did you mean 'ping_median'?

     distance_cm = sonar.ping_result / US_ROUNDTRIP_CM; // Ping returned in uS, convert to cm.

                         ^~~~~~~~~~~

                         ping_median

Using library NewPing at version 1.9.1 in folder: C:\Users\jresp\OneDrive\Documents\Arduino\libraries\NewPing

exit status 1

'class NewPing' has no member named 'ping_timer'; did you mean 'ping_trigger'?

thias15, 2020-09-22:
Did you try to disable the sonar, by setting `HAS_SONAR = 0`

Cantfigurethisout, 2020-09-22:
I have a sonar so wanted to keep it.  will try to disable it and see how that works

Cantfigurethisout, 2020-09-22:
It worked, got the wheels spinning.  Thanks for the help.

Closed 2020-09-22.

Thread 49 (2020-09-20):

Using DIY in firmware

parixit, 2020-09-20:
If we're using the DIY method (not custom PCB) should we update the firmware to
#define DIY 1
#define PCB 0

Thank you!

thias15, 2020-09-20:
No. You don't need to change anything. What numbers are assigned to the variables doesn't really matter. It's just necessary for the comparison below which sets up the pin definitions.

Closed 2020-09-20.

Thread 51 (2020-09-20):

Can't get the motors working with app control

parixit, 2020-09-20:
Basic setup but can't get the motors running with app control.  Any help is appreciated!

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

[https://youtu.be/muJt_BANYZw](url)

thias15, 2020-09-20:
1) Are the pins D5/D6 and D9/D10 connected to the L298N and are the jumpers to enable PWM in place?

2) Does the LED light blink every time you move the joystick? This indicates the message is sent to the Arduino. If not try reconnecting the USB and verify the baud rate.

3) Can you try to pull the code and recompile the Android app. Early on there was a bug which would skip some intermediate control signals due to some type conversion.

thias15, 2020-09-21:
I assume your issue is solved by (3). Please update the issue after pulling the latest code from the repo and testing.

parixit, 2020-09-21:
Hello @thias15 just did a new pull and build of the app and still the same issue.  I created a video of the issue: [https://www.youtube.com/watch?v=muJt_BANYZw&feature=youtu.be](url)

parixit, 2020-09-21:
Are the pins D5/D6 and D9/D10 connected to the L298N and are the jumpers to enable PWM in place?
**Yes**

Does the LED light blink every time you move the joystick? This indicates the message is sent to the Arduino. If not try reconnecting the USB and verify the baud rate.
**Yes, the LED light blinks every time I move the joystick**

BrandenSebring, 2020-09-21:
@parixit the issue may be in the phone itself. We have found that older phones (such as the note 4) did not send the "bluetooth information correctly" from the controller to the phone then out via usb otg serial to the board. When we changed the phone to a more powerful note 8 everything worked correctly, as far as controller support and motors actually moving.

learning the AI part now, with collected data

Also in the application when using the controller we keep drive mode on "game" and processing on the cpu. other wise the controller acts funny... (using 8bitdo contoller they made for nintendo switch)

and @thias15 thank you and all involved so much for this project!!!

thias15, 2020-09-21:
@BrandenSebring good point. The oldest phone we have tested was about 3 years old. @parixit what phone are you using? One thing you could try is to echo the control sent to the Arduino back to the phone and log it.

Here is a quick and dirty way to do it.

In the Arduino code replace lines 316-328:
```
void sendVehicleData()
{
  Serial.print(getVoltage());
  Serial.print(",");
  Serial.print(counter_left);
  Serial.print(",");
  Serial.print(counter_right);
  Serial.print(",");
  Serial.print(distance_cm);
  Serial.println();
  counter_left = 0;
  counter_right = 0;
}
```

with

```
void sendVehicleData()
{
  Serial.print(getVoltage());
  Serial.print(",");
  Serial.print(ctrl_left);
  Serial.print(",");
  Serial.print(ctrl_right);
  Serial.print(",");
  Serial.print(distance_cm);
  Serial.println();
  counter_left = 0;
  counter_right = 0;
}
```

replace lines 181-183:
```
    if (ctrl_rx) {
      processCtrlMsg(inChar);
    }
```

with
```
    if (ctrl_rx) {
      processCtrlMsg(inChar);
      sendVehicleData();
    }
```

Now connect everything and press the X button on the controller. The phone will start logging (you will hear the voice feedback "start logging"). Then move the joysticks to generate control signals (in game mode the trigger is used for throttle and joystick for steering). After some time stop the logging by pressing the X button again. Now, go to the log folder and look at the vehicle log file. In place of the speed sensor readings you will now see the control signals that were received. Can you post this here?

parixit, 2020-09-21:
@thias15 I am using a LG Rebel 4 (L212VL) which was released in 2018.  More info on the phone: https://www.phonemore.com/specs/lg/rebel-4/

I am using a PS4 controller and I hit the Square button to start testing.  The X button on the controller doesn't do anything for me.

What's weird is I don't see new zip files created for my test today.  Anything I have to do in the app?
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

thias15, 2020-09-21:
Logging was working before but not anymore? Logging should be triggered by the X button on the PS4 controller. The circle and square buttons control the indicators.

Do you hear "logging started" and then "logging stopped"?
You don't need to do anything besides starting the log and the stopping it which will zip all the data. If the buttons are not working properly, you can also toggle logging the the app.

parixit, 2020-09-21:
Yes, I do hear logging started and logging stopped.  But I hit the Square button on my PS4 controller to start logging.  The X button does not trigger logging.  It looks like logging was working before but now I don't see new files in OpenBot folder.

thias15, 2020-09-21:
The phone is on the lower end and only supports Android 7/8. We have tested the Nokia 2.2 which has similar performance as your phone but has Android 9. It worked, but was not able to run the AI models perfectly. You may have a hard time running the AI models at a decent speed as well. Do you have access to another phone?

thias15, 2020-09-21:
Hm. It seems like there is an issue with the button mapping. How about if you toggle logging in the app. Does that work?

parixit, 2020-09-21:
I am an iPhone user and this is a burner phone I use to test.  Not sure if I want to buy a high end Android phone for this as it defeats the purpose of a low cost bot.

parixit, 2020-09-21:
What is weird is when I manually toggle logging in the app (not with a controller) it doesn't say "Logging started", "Logging stopped".  It does say it when I press the square button on the PS4 controller.

thias15, 2020-09-21:
Yes, makes sense. Not saying you should buy a new phone, but maybe some in the family has one to try.

thias15, 2020-09-21:
One thing you could do is to print the joystick commands received inside the GameController class. Then you keep the phone connected to the laptop and look at the debug output.

thias15, 2020-09-21:
When you use the button in the app there is no audible feedback. It is just meant for operation via game controller when the screen is not visible.

parixit, 2020-09-21:
> One thing you could do is to print the joystick commands received inside the GameController class. Then you keep the phone connected to the laptop and look at the debug output.

Can you walk me through this?  I see GameController.java in Android Studio.

thias15, 2020-09-21:
Are you already on the Slack channel?

thias15, 2020-09-21:
Actually, even easier. Just add `gameController.processButtonInput(event);` at the top of the function `public boolean dispatchKeyEvent (KeyEvent event)` in NetworkActivity.java.

thias15, 2020-09-21:
You should then see toast messages in the app when you press different button. What message shows up when you press the "X" button or the other buttons?

parixit, 2020-09-21:
No not in the slack channel, do you need to add me?  If so please do add me.
So, like this?
public boolean dispatchKeyEvent (KeyEvent event) {
    // Check that the event came from a game controller
    gameController.processButtonInput(event);

thias15, 2020-09-21:
Yes.

thias15, 2020-09-21:
For checking what controls are being sent out, add the LOGGER to line 985 in CameraActivity.java
```
  protected void sendControlToVehicle(ControlSignal vehicleControl) {
    if ((usbConnection != null) && usbConnection.isOpen() && !usbConnection.isBusy()) {
      String message = String.format("c%d,%d\n",
              (int) (vehicleControl.getLeft() * speedMultiplier),
              (int) (vehicleControl.getRight() * speedMultiplier));
      **LOGGER.d("Control: " + message);**
      usbConnection.send(message);
    }
  }
```

parixit, 2020-09-21:
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

That broke:
OpenBot/android/app/src/main/java/org/openbot/CameraActivity.java:990: error: illegal start of expression
      **LOGGER.d("Control: " + message);**

` protected void sendControlToVehicle(ControlSignal vehicleControl) {
    if ((usbConnection != null) && usbConnection.isOpen() && !usbConnection.isBusy()) {
      String message = String.format("c%d,%d\n",
              (int) (vehicleControl.getLeft() * speedMultiplier),
              (int) (vehicleControl.getRight() * speedMultiplier));
      **LOGGER.d("Control: " + message);**
      usbConnection.send(message);
    }
  }`

thias15, 2020-09-21:
Then compile and run app. Keep it connected to USB of the laptop and connect the BT controller. Select *6:Logcat* from the bottom, and enter "Control:" in the search window. Now when you move joysticks on the game controller, you should see the messages being sent in the Window. Can you post them here?

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

thias15, 2020-09-21:
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

My bad, remove the ** around LOGGER, was trying to make it bold, but forgot I'm in code mode...
`LOGGER.d("Control: " + message);`

thias15, 2020-09-21:
> Are you already on the Slack channel?

Join [Slack](https://join.slack.com/t/openbot-community/shared_invite/zt-hpso8cfl-JO9OVhVMdUWvR4vDXwcMGA)

parixit, 2020-09-21:
A/libc: Fatal signal 11 (SIGSEGV), code 1, fault addr 0x8c080000 in tid 15642 (org.openbot), pid 15642 (org.openbot)
Changes were not applied.
We were unable to deploy your changes: MISSING_AGENT_RESPONSES

thias15, 2020-09-21:
Can you restart Android studio and try again?

parixit, 2020-09-21:
Ok, an update on where we are.  Big thank you to @thias15 for walking me through.
Turned on logging and for some strange reason my PS4 controller is triggering logging with the square button instead of the X.  Will try to another usb cable and to try to send a signal from the Arduino to the pins directly.

BrandenSebring, 2020-09-21:
@parixit when we used the older phone(note 4) , it would log start and stop with different button (we heard it) and the "blinkers" would get hit with gas or r1 buttons. This sounds like something in android is mapping the buttons differently.

parixit, 2020-09-23:
I finally got the motors to move!  It turns out I had a bad L298N board.  I am pasting firmware code for the Arduino Nano to test the motors.  If others are having the same issue this helped me troubleshoot.
`//This is to test the motors
//It will send a signal to move the motors

  //set up pins
  #define PIN_PWM1 5
  #define PIN_PWM2 6
  #define PIN_PWM3 9
  #define PIN_PWM4 10

void setup() {
  // put your setup code here, to run once:

  //Outputs
  pinMode(PIN_PWM1,OUTPUT);
  pinMode(PIN_PWM2,OUTPUT);
  pinMode(PIN_PWM3,OUTPUT);
  pinMode(PIN_PWM4,OUTPUT);

}

void loop() {
  // put your main code here, to run repeatedly:
  analogWrite(PIN_PWM1, 128);
    analogWrite(PIN_PWM2, 0);
    analogWrite(PIN_PWM3, 128);
    analogWrite(PIN_PWM4, 0);
    delay(5000);

}`

Closed 2020-09-23.

Thread 54 (2020-09-22):

Slim model for build plates 200x200

manair, 2020-09-22:
200x200 it usually an entry level for 3D printer. This project is awesome and will reach more people if we can get real slim model 😁 .  If someone has a working model for  200x200 please share. I tried working on it with blender but I am not an expert with 3D modeling. Even if the need can have it in pieces and put it back together some way it be at lease a solution.
Thanks

thias15, 2020-09-23:
Check out the [glueable body](https://github.com/intel-isl/OpenBot/tree/master/body/cad/glue_body). It can be printed on a 150x140 build plate.

Closed 2020-09-23.

Thread 57 (2020-09-24):

When I am training the data, it always display "There are 0 train images and 0 test images"

KevinBuddy, 2020-09-24:

thias15, 2020-09-24:
Please provide more details. What is your folder structure? How did you configure the paths in Jupyter?

KevinBuddy, 2020-09-24:
I have copied all the txt under sensor_data and jpeg files under images into my_openbot_1

KevinBuddy, 2020-09-24:
If I copied the whole directory into my_openbot_1,it will display an error

KevinBuddy, 2020-09-24:
I can not find any document of associate_frames.Is that your private library？

KevinBuddy, 2020-09-24:
Can you give me the information about associate_frames.match_frame_ctrl_cmd?

KevinBuddy, 2020-09-24:
I got it.

thias15, 2020-09-24:
You need to put the complete folders in the my_openbot_1 folder. The structure is train_data --> datasets --> recordings. The associate_frames.py is a python file with the utility functions for matching frames and controls.

thias15, 2020-09-24:
> I got it.

Is the issue solved?

KevinBuddy, 2020-09-30:
thanks, the issue is solved.

Closed 2020-09-26.

Thread 61 (2020-09-26):

Separate designator for second U1 pin header

agios, 2020-09-26:
Could the second pin header get a separate designator in the BOM, also adding it to the centroid file?

As it is, when requesting assembly for the custom PCB, PCBWay complains that they do not know where to place it

thias15, 2020-09-28:
Unfortunately it's no so easy to do this, since the footprint is associated with the silk screen and a 3D model of pin headers and Arduino. Just adding a new designator on the PCB and updating the BOM would be easy though. I guess the centroid file could be adjusted manually? But usually through-hole components are mounted manually anyways.

Closed 2020-10-19.

Thread 62 (2020-09-27):

Sonarr and indicator not working

yangtfu, 2020-09-27:
I'm not familear with JAVA, so I just test the arduino firmware, sonar and indicator LED seem work fine. But when I pugin the phone and make it follow a person, the robot bump around and the indictors never light up. Is there anything wrong with my android app?

thias15, 2020-09-28:
Your Android app is fine. For the person following neither the indicator nor the ultrasonic sensor are used. That being said, I will probably implement stopping based on the ultrasonic sensor, since several people have expressed interest in this feature. The indicators are only used for training autonomous driving policies.

Closed 2020-09-28.

Thread 65 (2020-09-29):

[Feature] Build and publish Android Debug apk from GitHub Actions

francisduvivier, 2020-09-29:
Hi, just first want to say thanks a lot for this project, it really helps me for getting into hobby robotics, AI,  3D printing, electronics and Arduino.
I was looking at the build pipelines for Android and I see that currently, the android app is not being built(since `android/gradlew` is executed from the root of the repo, which has no gradle project) or uploaded.

I've worked with Bitbucket pipelines and I would love to contribute and get some experience with GitHub's build pipelines, so I would like to improve this in 2 PR's:
1. Add a build step to build the app module, I'm thinking of using https://github.com/marketplace/actions/android-build for that, but I still have to experiment with that a little.  With this, we can already ensure that on every PR, the app build is still working.

2. Upload the debug apk to the build artifacts. I was thinking to follow [this guide](https://github.com/marketplace/actions/upload-files-to-a-github-release) for that, but here also I still have to experiment a little first. With this, people could download this apk to their device so that they would not necessarily need to install android studio. They would still have to change settings on their phone to allow the installation though so this PR should also include some documentation with a (or link to) explanation about installing a debug apk on  your android phone.

A nice third step would be to instead upload a signed apk, but this requires to store the signing keys somewhere safe, so I won't be able to set that up as an external contributor.
And from there, you could also include an automatic deployment to the F-Droid repo or google play store. But also, since it requires signing keys and authorization, it's out of scope for an external contributor I would think.

Let me know if you guys think the above 2 PR's would be useful. The downside will be that the build will take a lot longer, I think it can certainly add multiple minutes to the build.

thias15, 2020-09-29:
Hi @francisduvivier.

This is great!

(1) I never actually checked the workflow, just assumed it worked. So this would be a great contribution! Ideally, it would only run when files in the android folder are changed and not for any push to the repo.

(2) This is also a good idea. I'm actually just about the tag the first release, now that the project seems to be semi-stable and some people were able to go through the complete process. Just to make sure, this would only run when a new release is tagged correct? There should not be a new release for every push to the repo.

(3) I also agree on this and we are working on it. However, it requires some internal approvals to host the app in the Playstore.

francisduvivier, 2020-09-29:
(1) Good point regarding changed files, we can arrange that with https://docs.github.com/en/free-pro-team@latest/actions/reference/workflow-syntax-for-github-actions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,

(2) Yes I should actually split this in 2 parts as well since there is a difference between [GitHub release assets](https://github.com/actions/upload-release-asset) and [GitHub Action build artifacts](https://docs.github.com/en/free-pro-team@latest/actions/guides/storing-workflow-data-as-artifacts). And so actually I would say that we use the build artifacts every time the apk is built, since the time-cost of uploading is very small compared to the build and it is IMO useful if you on every PR with changed android files can easily download the apk and quickly check the functionality when you want to. Also people who need access to a quick fix which is not released yet but is already on master could use this, or if you want people to check that a PR fixes their android issue for them.
Then as a 2.2 step, we can upload the same artifacts as a release asset in case of a tagged release, but it's a different trigger, different destination and a different Github Action, so it's quite a separate thing.

(3) Indeed, I am certainly not expecting this to be done anytime soon and I think the above stuff can stand fine on its own, it was just my Idea of where this could eventually go. Having a signing key would certainly already be a good step, so that you can upload the release version to the release assets and so that it is not signed with the google debug key. But yeah, you need to make sure that this key can only be used when authorized by owners, I don't know if there is a way to automate that in a public Github project.

thias15, 2020-10-02:
This issue is completed with #68, #73 and #74.

Closed 2020-10-02.

Thread 66 (2020-09-29):

[Feature] Add automatic stopping based on ultrasonic sensor.

thias15, 2020-09-29:
Add the option to the Arduino code to stop the car within some threshold of an obstacle based on the ultrasonic sensor.

JNK88545, 2020-10-06:
void stop1(){
   ping_time = millis();
  if (distance_cm<=130){
             analogWrite(PIN_PWM1,0);
             analogWrite(PIN_PWM2,0);
             analogWrite(PIN_PWM3,0);
             analogWrite(PIN_PWM4,0);
  }
}
**Can this function be achieved by writing this way? I failed**

thias15, 2020-10-07:
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

I just merged a PR #77 which has this feature.

Closed 2020-10-07.

Thread 70 (2020-09-29):

[Feature] Display battery voltage and speed/rpm in the app.

thias15, 2020-09-29:

vkuehn, 2020-11-21:
I would think HUD like to waste not to much space or do you have a certain style in mind ?

thias15, 2020-11-25:
Hi @vkuehn. Are you still planning to work on this?

vkuehn, 2020-11-26:
@thias15 I understood there is no real demand and a refactoring planned. However if need yes I could do that.
If so It's the states of the base, So Battery level of the motor driver ?

Closed 2020-12-17.

Thread 79 (2020-10-08):

Could you share the STL file of Speed Sensor gear?

aolihu, 2020-10-08:
I can't find the STL file of Speed Sensor gear in the Robot Body.
Could you share it?
Thanks.

thias15, 2020-10-08:
When we bought the speed sensors, the discs came with it. However, someone has posted about their OpenBot build on [YouMagine](https://www.youmagine.com/designs/ultimaker-2-printable-openbot-body) and has uploaded a 3D model for the encoder disc [here](https://www.youmagine.com/documents/92751/download).

Closed 2020-10-08.

Thread 85 (2020-10-15):

AliExpress Arduino Nano link is for ATmega168P Microcontroller instead of 328p

francisduvivier, 2020-10-15:
I was just checking out the Arduino Nano in the body parts and I noticed that the [aliexpress link](https://www.aliexpress.com/item/32866959979.html) is for an ATmega168P while the arduino [firmware documentation](https://github.com/intel-isl/OpenBot/blob/master/firmware/README.md) mentions an ATmega328P microcontroller and the amazon links are also for a ATmega328P.

Will this [firmware](https://github.com/intel-isl/OpenBot/blob/master/firmware/openbot_v1_nano/openbot_v1_nano.ino) be compatible with the hardware from the AliExpress link?

thias15, 2020-10-16:
I did not realize that the Aliexpress link points to a ATmega168P Arduino. Never tested such a board, but it should work. The only real difference between 168 and 328 is the amount of memory. The firmware only uses about 25% memory on the 328, so it should be fine.

francisduvivier, 2020-10-16:
Alrighty, I ordered this one some time ago, but it hasn't arrived yet.
When it has and it doesn't work, I'll open a new issue.

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

Closed 2020-10-16.

Thread 86 (2020-10-23):

OpenBot phone using front camera

NathanielChavdarov, 2020-10-23:
Hey guys,

I've made my OpenBot and upon installing the app, the phone views through the front camera and not the rear camera. I tried all the buttons on my controller and look at the .ino code but I still haven't been able to find out why it's happening. Can you please help me out?

Many thanks,
Nathaniel

thias15, 2020-10-23:
Which phone are you using? I guess you already found the solution in the open issue.

Closed 2020-10-23.

Thread 89 (2020-11-03):

Why can't my car turn?

xyz2k8, 2020-11-03:
Why can't my car turn? Does the control information sent by mobile app use the data of speed sensor?

thias15, 2020-11-03:
No not at this time. Did you try the tests in the Arduino setup via the Serial Monitor?

xyz2k8, 2020-11-04:
I know. I guess the steering control comes from the position of the ROI in the image identified by the neural network, right? I haven't checked the serial port information carefully, because the USB cable was not connected to the computer during the test, which is a bit inconvenient. I think I can send the serial port information to another mobile phone via Bluetooth, or add a window to the app to display these logs in the future.

thias15, 2020-11-04:
Yes, the object detector will produce a bounding box. Based on this bounding box appropriate controls are produced to keep the object centered. If you want to use the autopilot network, you need to train it on your own dataset. I would highly recommend to send controls with the serial monitor first to make sure your car works correctly.

xyz2k8, 2020-11-09:
In the end, it was found that the reason for the inability to turn was that the switch of my phone's automatic rotation was not turned on.

Closed 2020-11-04.

Thread 90 (2020-11-05):

How to replace the Bluetooth remote controller (PS4)？

xyz2k8, 2020-11-05:
If I train an autonomous driving network by myself, do I have to rely on a Bluetooth remote controller to collect data? Can I use another mobile phone to send control commands via Bluetooth to the mobile phone installed in the car?

thias15, 2020-11-05:
In principle it should work to use another phone as BT controller. But we have not tried this.

xyz2k8, 2020-11-06:
I understand, thank you for your reply.

thias15, 2020-11-06:
Let me know if you were able to get it to work.

38293312, 2020-11-09:
In fact, I prefer AI. You don't need to operate it manually. You can consider replacing the motherboard in the future. Develop voice dialogue or voice control commands!

thias15, 2020-11-09:
Yes voice control is on our list of features to be added, but will still take some time. Feel free to contribute it if you like.

xyz2k8, 2020-11-10:
> Yes voice control is on our list of features to be added, but will still take some time. Feel free to contribute it if you like.

I reviewed the code carefully, trying to find out how to label when collecting the data, so that I could find an alternative.  Does the collected training data contain PS4 control instructions?  I installed a Bluetooth module on the car, which can remotely control the car. If the collected data contains Bluetooth control commands, I can send it to the mobile phone through the USB serial port.  Do you have a better way to replace Bluetooth PS4?

38293312, 2020-11-10:
> 是的，语音控制在我们要添加的功能列表中，但仍需要一些时间。如果您愿意，可以随时贡献它。

Sorry, I don’t know much about the code, but I can give a good idea and mind

thias15, 2020-11-11:
@xyz2k8 yes, you can send the control commands to the phone and then log them inside the SensorService.java class. The data received from the Arduino is in [line228](https://github.com/intel-isl/OpenBot/blob/bcfa1abf72b4af497419399931e3068768a886a7/android/app/src/main/java/org/openbot/SensorService.java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). You then need to extract the controls and save them to the control log. Note that the vehicle log is only sent once a second. You will want to send the controls at a higher frequency. I would recommend at least every 30ms. If you do not disable the vehicle log, you will also need a header to know which message you have received from the Arduino.
```
appendLog(mCtrlLog, SystemClock.elapsedRealtimeNanos() + "," + leftCtrl + "," + rightCtrl);
```

In [line405](https://github.com/intel-isl/OpenBot/blob/bcfa1abf72b4af497419399931e3068768a886a7/android/app/src/main/java/org/openbot/SensorService.java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) the controls from the CameraActivity are received. This corresponds to either the controls from a connected BT game controller or from the neural network that's running (you can also log while a network is running). Since you won't have an external controller connected, you can just leave it. But if you want to be sure there is no interference with what you will be writing to the log, you can comment this line.

xyz2k8, 2020-11-11:
@thias15 👍
Thank you very much for your guidance, this is exactly the solution I expected.  I'll try it this weekend.

thias15, 2020-11-17:
Any luck?

xyz2k8, 2020-11-20:
Sorry, there is no time to deal with this, you can close this issue first, and I will report if there is progress in the future.

thias15, 2021-01-01:
@xyz2k8 there is now a dedicated app that lets you use another phone as remote control for OpenBot. You can download it from the artifacts or compile the controller module in the android folder.

Thread 93 (2020-11-06):

Test indicator leds

nanotuxi, 2020-11-06:
Building this project is a lot of fun. Thanks for it.
One thing that irritated me at the beginning when the indicator led have been wired and 1st tests were successful everything worked but the leds seemed to be unresponsive. Reading the source code I found the reason was that they only work, if a game pad controller is attached via bluetooth for training the model. As I do not have a game controller at all (although I like to play very much ;-) the leds would never work?!?

To see if the wiring of the leds are made correctly I simply wrote some test code that is executed in the init phase of the arduino and lets the leds blink once for 1 second by simply adding these lines in the `setup()` of `openbot_v1_nano.ino`:
```
    void setup()
    {
    [... ]
     // test if the led wiring is correct
      digitalWrite(PIN_LED_RB,HIGH);
      delay(1000);
      digitalWrite(PIN_LED_RB,LOW);
      delay(1000);
      digitalWrite(PIN_LED_LB,HIGH);
      delay(1000);
      digitalWrite(PIN_LED_LB,LOW);
      delay(1000);```
    [...]
    }

thias15, 2020-11-06:
Thanks. Will add this to next firmware update.

thias15, 2020-11-06:
This is now added in PR #92.

nanotuxi, 2020-11-07:
Thanks for that.

francisduvivier, 2020-11-08:
Tx!

Closed 2020-11-08.

Thread 100 (2020-11-09):

Confused about directory structure

zlite, 2020-11-09:
Thanks for the quick response. I am a bit confused about the next step, because the instructions are not clear about where to place the training data you've pulled off your phone. What's the difference between "train_data" and "test_data"? Which one (or both) should the images and sensor data folders go into?

I've set up my directory structure as follows,
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

with the images and sensor folders in the train_data folder and nothing in the test_data folder. But that doesn't seem to work.
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

Can you add a sample screenshot of the correct directory structure and file locations? The text-tree you've provided so far and the instructions in the Jupyter notebook don't explain this

thias15, 2020-11-10:
The folder structure is explained [here](https://github.com/intel-isl/OpenBot/tree/master/policy#data-collection). Basically, inside each, the train_data and test_data folder, you can make folders for each dataset you collect and give it a name such as "my_openbot_1", "my_openbot_2", etc. Inside these folders, you drop all the zip files from that recording session and unpack them. I can add a screenshot to the repo to make it more clear.

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

The reason for the train_data and test_data folder is to have some data for validation/testing during training that has not been seen. This then gives you an indication during training of how well this policy may transfer. The

common split is 80% training data and 20% test data.

thias15, 2020-11-10:
Also, you might find issue #31 helpful for getting the training to work.

zlite, 2020-11-10:
Just to be clear, since I can't tell from the screenshot, I should place the *same* Images and Sensor Data folders and files in both the Test and Train folders?  Or should I some runs in Test and *others* in Train so that they have different data to look at, as your note suggests?

zlite, 2020-11-10:
Reading as much as I can, I think the clearer way to put this in the documentation would be with an example, perhaps like this:

1) Collect five data sets (five runs over the same area, pressing record for each one)
2) Copy all those zip files to your PC
3) Unzip them and put four of them in the Train folder, each as an Images (containing all the images) and Sensor Data (containing all the sensor data text files) folder within a folder with the run number
4) Put the remaining run in the Test folder, also within Images and Sensor data folders inside a run number folder.

This ratio of 80% training/20% testing data is a good rule of thumb for all your data gathering going forward

thias15, 2020-11-11:
The data in the train_data and test_data folders should be different. As you can see in the screenshot in the folders with the different runs (my_openbot_1, my_openbot_2) are just the extracted log folders that come from the OpenBot phone. The folder names correspond to the timestamp of when the log was started (trigger on the controller). I did update the description in the Readme yesterday. Let me know if this is easier to understand.

zlite, 2020-11-11:
Thanks for the explanations (and sorry for being dim ;-) It is clearer now, although I still like the idea of providing an example, as I did above, for those who really want it spelled out.

thias15, 2020-11-11:
Ok, thanks for your feedback, will see how I can incoporate that.

zlite, 2020-11-12:
Having now put the files in a directory structure as instructed, I'm getting this error. There seems to be some confusion: should the Sensor Data folder be *within* the Images folder, as this error suggests, or at the same level as the Images folder, as the documentation says?
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

thias15, 2020-11-12:
No, it should be as the documentation says. You are missing one level of directories. Right now you put the extracted zip files directly into `dataset/train_data/`. But there should be subfolders corresponding to the recording sessions. So for example you collect some data for learning to drive around your kitchen block in the morning. Then you create the folder `dataset/train_data/kitchen_morning` and then extract all of the zip files into that folder. Then you may collect more data in the evening, and will put it into `dataset/train_data/kitchen_evening`. By default, you will train on all data. However, you can also specify in the notebook to train only on specific folders. This is useful if you want to train different policies with data collected in different environments (e.g. another subfolder `living_room_morning`).

Similarly, you might have different openbots, e.g. `my_openbot_1`, `my_openbot_2`, etc. This is the example from the documentation and what I posted a screenshot of above. I hope this makes sense now.

zlite, 2020-11-12:
Sorry for being so dim! I guess I was just confused by the example screenshot you provided, where you have different OpenBot numbers in the Test and Train directories.  Wouldn't it be clearer and simpler to use the same OpenBot number for both, which I presume is the most common case (people only have one)?

Like this:
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

thias15, 2020-11-13:
Yes, you are probably right.

Closed 2020-11-13.

Thread 95 (2020-11-09):

How can I fix the mistake of sharp cornering or turning the corner of the robot while following human?

quockhanh1198, 2020-11-09:
Hello Thias, I ran the model on my Xiaomi Redmi Note 7 phone and it looks pretty ok. But in some cases when human go too fast or a sharp turn, the robot cannot detect people anymore and cannot follow. Can you help me fix these points ? Thank you very much !

thias15, 2020-11-09:
If the person is too close to the robot and makes very sharp turns, the person may be out of the view. In this case there is no way for the robot to recover until the person comes into view again. In addition, the object detector is also not perfect and may not always be able to detect people correctly. One thing you can do to improve detections, is mounting the phone tilted slightly upwards.

quockhanh1198, 2020-11-09:
Thank you for your reply, and please can you tell me why I should tilt the phone up slightly?

Closed 2020-11-09.

Thread 96 (2020-11-09):

How to connect the mobile phone and arduino nano?

38293312, 2020-11-09:
Very good project, thank you for sharing。
Use the OTG function of the mobile phone to connect to the mini USB interface of Arduino Nano?

In the future, you can consider adding new functions to the walking robot？

38293312, 2020-11-09:
从相关文章里面都了解到是通过OTG连接arduino nano.

thias15, 2020-11-09:
Yes, we will add more features to OpenBot in the future. It sounds like your issue is resolved (USB OTG). I will close the issue. Please reopen and provide further details if the issue persists.

Closed 2020-11-09.

Thread 97 (2020-11-09):

The 3D printing file size is not suitable for the I3 frame printer, ha ha!

38293312, 2020-11-09:
I really like this project and want to DIY one, but my I3 frame 3D printer cannot print OPEBOT files. I have a headache!
I just read the related articles and found that the "speed sensor" has no model. I found it on the Internet and there is no one. Can you tell me an alternative model? Can all modules of this signal be used?
"The slot-shaped through-beam photoelectric, as long as the non-transparent object passes through the slot, it can trigger to output 5V TTL level. Using Schmitt trigger to de-jitter pulse"

thias15, 2020-11-09:
Could you please elaborate why you cannot print?

I assume the speed sensor is an unrelated issue. What do you mean by model of the speed sensor? It is an optical encoder and the disk attached to the motor shaft, interrupts the optical signal. By counting the interrupts, the number of rotations can be measured.

38293312, 2020-11-09:
> 您能否详细说明为什么无法打印？
>
> 我认为速度传感器是一个无关紧要的问题。速度传感器的型号是什么意思？它是一个光学编码器，并且光盘固定在电机轴上，可中断光学信号。通过计算中断次数，可以测量转数。

Hahaha, what I mean by unprintable means that the size of the object exceeds the size that the I3 printer can print.
Can the speed sensor not be used?

thias15, 2020-11-09:
You can try the [glueable body](https://github.com/intel-isl/OpenBot/tree/master/body/cad/glue_body). As for the speed sensor, yes it should work. Are you asking about a specific model that's different from the one in the BOM?

38293312, 2020-11-10:
> 您可以尝试可[胶粘的身体](https://github.com/intel-isl/OpenBot/tree/master/body/cad/glue_body)。至于速度传感器，是的，它应该可以工作。您是否要询问与BOM表中的模型不同的特定模型？

Yes, after your reminder, I noticed that there are close-up models in the BOM! Thank you very much, so you can print, I am preparing electronic components, ready to assemble one by hand, thank you again for sharing!

Closed 2020-11-11.

Thread 99 (2020-11-09):

Garbled text in app

zlite, 2020-11-09:
On a Pixel 4, the app shows this Chinese text when connected to OpenBot. Otherwise works normally

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

thias15, 2020-11-09:
Is your phone from China? It may be related to the Java locale.

thias15, 2020-11-09:
I have never seen something like this. :) I believe, you are using a cheap Arduino clone with a very long Chinese product name. You can fix this by changing [line 963](https://github.com/intel-isl/OpenBot/blob/08bd925fcdbdd7eadcba8d096ab181a16ec67a1a/android/app/src/main/java/org/openbot/CameraActivity.java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) in CameraActivity.java to
```
connectionSwitchCompat.setText("Connected");
```

Please let me know if that fixes your issue.

zlite, 2020-11-09:
No, it's a standard Google Pixel 4 from the US. Running Android 11.

Yes, it is a Chinese Arduino clone, although a very nice one (DFRobot Romeo board): https://www.dfrobot.com/romeo.html

zlite, 2020-11-10:
That fix worked, thanks!
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

Closed 2020-11-10.

Thread 105 (2020-11-12):

Issue with Indicator Log?

zlite, 2020-11-12:
The Jupyter Notebook doesn't like the IndicatorLog.txt file

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

thias15, 2020-11-13:
Check if the indicatorLog is empty. If there is only the header, you can add `0,0` in the next line. It should add the status of the indicators at the beginning of the log automatically to make sure it's never empty. I will look into this issue. As workaround, you can press the triangle button on the PS4 at the start of the recording, or manually add an entry as described above.

zlite, 2020-11-13:
Yes, that was the problem. One of the indicatorLogs in one of the runs had only the header. I added 0,0 and it now trains

thias15, 2020-11-13:
Great to hear it. I will double-check the Android code and see if I can reproduce and fix this issue.

zlite, 2020-11-13:
I'm now getting errors again, despite checking that all the IndicatorLog.txt entries had a header and at least one entry. Very frustrating.
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

My datasets are [here](https://drive.google.com/drive/folders/14VfBgP-RqKDuHjsf0Dv8rGd025HkR6cn?usp=sharing). Can you see anything obviously wrong with them?

thias15, 2020-11-14:
Some of you ctrl_log files in both train_data and test_data are completely empty. I will revisit the code the make it more robust and produce more meaningful error messages. But I'm not sure how you ended up with empty files. I have collected several hours of data, and not encountered such issues. If you can figure out why you have these empty files, please let me know so I can fix it.

zlite, 2020-11-14:
Wow -- I've got no idea! The only change I made to the Android app was the one you suggested to not display the long Chinese Arduino board name.

I presume the ctrlLog.txt is tracking my PS4 controller input? But I notice that there are a lot of other zero-length sensor files in some of those runs, too.

I'm not quite sure how to properly exit the Android app when I'm done, so after I press X to stop logging, I just disconnect the phone from the bot and sometimes after that the app freezes. Do you think that a bad exit from the app could cause those zero-length files?

zlite, 2020-11-14:
One other possibility. I changed the Arduino code to use quadrature encoders, and I wonder if the interrupts are disrupting some serial flow at 115k. I also get freezes after a few minutes of driving, like this report:
https://openbot-community.slack.com/archives/C01BRGE07QQ/p1603981059143500

My modified Arduino code is [here](https://github.com/zlite/OpenBot/blob/master/firmware/openbot_new.ino)

Maybe I should be logging at a slower serial rate, like 57k?  It's been a long time since I used classic Atmega 328 Arduinos (as opposed to modern boards, like Teensy or 32u4) so maybe they can't handle 115k serial and interrupts at the same time?

thias15, 2020-11-14:
The best way to exist the app is via the back button. Make sure to wait a little bit after collecting the data before you kill the app, to make sure the data is completely written.

>I presume the ctrlLog.txt is tracking my PS4 controller input?

Yes.

>But I notice that there are a lot of other zero-length sensor files in some of those runs, too.

Yes, if the sensors don't exist on your phone some files will be empty. But only the control and indicator logs are currently used.

zlite, 2020-11-14:
Interestingly, on the runs where the ctrlLog size is zero, most of the other sensors are also zero, even though my phone has those sensors and other runs they're not zero. So it definitely looks like a logging issue with the Android app;

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

thias15, 2020-11-15:
Is it possible that the app crashed or was killed in these instances? Because if the log is not closed properly, it may be empty. The file does not get saved after each timestep, but only after the buffer is full or after logging is stopped.

thias15, 2020-11-18:
With further testing I was not able to reproduce. Will close it for now. Please reopen if you have any idea what caused the issue in the logs so I can fix it.

Closed 2020-11-18.

Thread 106 (2020-11-13):

"Invalid Argument Error"

zlite, 2020-11-13:
During training, I get this error (using TF 2.0.0 on Windows 10)

Train for 339.0 steps, validate for 246 steps
Epoch 1/10
  1/339 [..............................] - ETA: 52:40WARNING:tensorflow:From C:\Users\chris\miniconda3\envs\openbot\lib\site-packages\tensorflow_core\python\ops\resource_variable_ops.py:1781: calling BaseResourceVariable.__init__ (from tensorflow.python.ops.resource_variable_ops) with constraint is deprecated and will be removed in a future version.
Instructions for updating:
If using Keras pass *_constraint arguments to layers.
INFO:tensorflow:Assets written to: models\my_openbot_cil_mobile_lr0.0001_bz16_bn\checkpoints\cp-0001.ckpt\assets
  1/339 [..............................] - ETA: 1:51:07
---------------------------------------------------------------------------
InvalidArgumentError                      Traceback (most recent call last)
<ipython-input-32-05b56d02e65c> in <module>
      5                     callbacks=[callbacks.checkpoint_cb(checkpoint_path),
      6                                callbacks.tensorboard_cb(log_path),
----> 7                                callbacks.logger_cb(log_path)])

~\miniconda3\envs\openbot\lib\site-packages\tensorflow_core\python\keras\engine\training.py in fit(self, x, y, batch_size, epochs, verbose, callbacks, validation_split, validation_data, shuffle, class_weight, sample_weight, initial_epoch, steps_per_epoch, validation_steps, validation_freq, max_queue_size, workers, use_multiprocessing, **kwargs)
    726         max_queue_size=max_queue_size,
    727         workers=workers,
--> 728         use_multiprocessing=use_multiprocessing)
    729
    730   def evaluate(self,

~\miniconda3\envs\openbot\lib\site-packages\tensorflow_core\python\keras\engine\training_v2.py in fit(self, model, x, y, batch_size, epochs, verbose, callbacks, validation_split, validation_data, shuffle, class_weight, sample_weight, initial_epoch, steps_per_epoch, validation_steps, validation_freq, **kwargs)
    322                 mode=ModeKeys.TRAIN,
    323                 training_context=training_context,
--> 324                 total_epochs=epochs)
    325             cbks.make_logs(model, epoch_logs, training_result, ModeKeys.TRAIN)
    326

~\miniconda3\envs\openbot\lib\site-packages\tensorflow_core\python\keras\engine\training_v2.py in run_one_epoch(model, iterator, execution_function, dataset_size, batch_size, strategy, steps_per_epoch, num_samples, mode, training_context, total_epochs)
    121         step=step, mode=mode, size=current_batch_size) as batch_logs:
    122       try:
--> 123         batch_outs = execution_function(iterator)
    124       except (StopIteration, errors.OutOfRangeError):
    125         # TODO(kaftan): File bug about tf function and errors.OutOfRangeError?

~\miniconda3\envs\openbot\lib\site-packages\tensorflow_core\python\keras\engine\training_v2_utils.py in execution_function(input_fn)
     84     # `numpy` translates Tensors to values in Eager mode.
     85     return nest.map_structure(_non_none_constant_value,
---> 86                               distributed_function(input_fn))
     87
     88   return execution_function

~\miniconda3\envs\openbot\lib\site-packages\tensorflow_core\python\eager\def_function.py in __call__(self, *args, **kwds)
    455
    456     tracing_count = self._get_tracing_count()
--> 457     result = self._call(*args, **kwds)
    458     if tracing_count == self._get_tracing_count():
    459       self._call_counter.called_without_tracing()

~\miniconda3\envs\openbot\lib\site-packages\tensorflow_core\python\eager\def_function.py in _call(self, *args, **kwds)
    518         # Lifting succeeded, so variables are initialized and we can run the
    519         # stateless function.
--> 520         return self._stateless_fn(*args, **kwds)
    521     else:
    522       canon_args, canon_kwds = \

~\miniconda3\envs\openbot\lib\site-packages\tensorflow_core\python\eager\function.py in __call__(self, *args, **kwargs)
   1821     """Calls a graph function specialized to the inputs."""
   1822     graph_function, args, kwargs = self._maybe_define_function(args, kwargs)
-> 1823     return graph_function._filtered_call(args, kwargs)  # pylint: disable=protected-access
   1824
   1825   @property

~\miniconda3\envs\openbot\lib\site-packages\tensorflow_core\python\eager\function.py in _filtered_call(self, args, kwargs)
   1139          if isinstance(t, (ops.Tensor,
   1140                            resource_variable_ops.BaseResourceVariable))),
-> 1141         self.captured_inputs)
   1142
   1143   def _call_flat(self, args, captured_inputs, cancellation_manager=None):

~\miniconda3\envs\openbot\lib\site-packages\tensorflow_core\python\eager\function.py in _call_flat(self, args, captured_inputs, cancellation_manager)
   1222     if executing_eagerly:
   1223       flat_outputs = forward_function.call(
-> 1224           ctx, args, cancellation_manager=cancellation_manager)
   1225     else:
   1226       gradient_name = self._delayed_rewrite_functions.register()

~\miniconda3\envs\openbot\lib\site-packages\tensorflow_core\python\eager\function.py in call(self, ctx, args, cancellation_manager)
    509               inputs=args,
    510               attrs=("executor_type", executor_type, "config_proto", config),
--> 511               ctx=ctx)
    512         else:
    513           outputs = execute.execute_with_cancellation(

~\miniconda3\envs\openbot\lib\site-packages\tensorflow_core\python\eager\execute.py in quick_execute(op_name, num_outputs, inputs, attrs, ctx, name)
     65     else:
     66       message = e.message
---> 67     six.raise_from(core._status_to_exception(e.code, message), None)
     68   except TypeError as e:
     69     keras_symbolic_tensors = [

~\miniconda3\envs\openbot\lib\site-packages\six.py in raise_from(value, from_value)

InvalidArgumentError: 2 root error(s) found.
  (0) Invalid argument:  Cannot batch tensors with different shapes in component 0. First element had shape [96,256,3] and element 15 had shape [300,300,3].
	 [[node IteratorGetNext (defined at C:\Users\chris\miniconda3\envs\openbot\lib\site-packages\tensorflow_core\python\framework\ops.py:1751) ]]
  (1) Invalid argument:  Cannot batch tensors with different shapes in component 0. First element had shape [96,256,3] and element 15 had shape [300,300,3].
	 [[node IteratorGetNext (defined at C:\Users\chris\miniconda3\envs\openbot\lib\site-packages\tensorflow_core\python\framework\ops.py:1751) ]]
	 [[IteratorGetNext/_6]]
0 successful operations.
0 derived errors ignored. [Op:__inference_distributed_function_5273]

Function call stack:
distributed_function -> distributed_function

thias15, 2020-11-13:
It looks like you had the Detector_V1 enabled during data collection (it processes images with a 300x300 resolution). You need to collect data with the autopilot model selected (it process images with 256x96) resolution. Check the second step in [data collection](https://github.com/intel-isl/OpenBot/tree/master/policy#data-collection).

Closed 2020-11-14.

Thread 107 (2020-11-13):

Cannot test with "c128,128" command!

38293312, 2020-11-13:
After successfully encoding with the latest code, the OLED display is normal. I just made the most basic connection. Now I mainly test whether the 4 motors are normal. Using "Cannot test with "c128,128" command", the motor does not rotate, the serial port software The card does not change on line 10.

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

38293312, 2020-11-13:
I tried both the high and low OE driven by the L298N motor, but it still couldn't rotate.

thias15, 2020-11-13:
It looks like your Arduino is not connected to GND. You need to wire the GND pin from your Arduino to the GND of the L298N.

thias15, 2020-11-13:
Another thing you can check is if the new line terminator is enabled in the serial monitor. By default it should be.

38293312, 2020-11-13:
> 您可以检查的另一件事是在串行监视器中是否启用了新的线路终止器。默认情况下应该是。

The GND and arduino GND of the L298N 12V power supply are connected together, and the test with a multimeter is OK

38293312, 2020-11-13:
thank you very much. The problem is solved!

thias15, 2020-11-13:
How did you solve the problem in the end?

Closed 2020-11-13.

Thread 109 (2020-11-13):

Person Following False Positives

mahumada408, 2020-11-13:
Hi All,

Thanks for the great software!

One thing, I seem to be getting a bunch of false positives where the app falsely labels things as `person`. For example, I've had the bot falsely label a stationary truck as a person. Is there anything I can do? Also, would it be possible to publish out the detection probability? Maybe we could have the motors run when the probability is passed a certain threshold.

Thanks!

thias15, 2020-11-14:
This is already implemented (see [here](https://github.com/intel-isl/OpenBot/blob/27c299b85f757ef4a9256583564f478239ddcf7e/android/app/src/main/java/org/openbot/NetworkActivity.java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)). But the object detectors are not perfect. I'm planning to port yolo-v4 at some point which should lead to more reliable detections.

mahumada408, 2020-11-14:
@thias15 , great! Thanks!

For fun, can I change that threshold and re-build the app? How would I go about doing that? (sorry I have 0 experience with android app development)

thias15, 2020-11-14:
Yes, you can change it [here](https://github.com/intel-isl/OpenBot/blob/27c299b85f757ef4a9256583564f478239ddcf7e/android/app/src/main/java/org/openbot/NetworkActivity.java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). Default is 50%. Keep in mind that usually the confidence won't be above 60% or 70%. Also, by tilting the phone upward in the phone mount, you can improve detections since the camera you see you better.

Closed 2020-12-07.

Thread 111 (2020-11-15):

Error in documentation

zlite, 2020-11-15:
In the Driving Policy section, the documentation says we will find the Network folder in the following location
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

At least on Windows, it's actually in this location (nested deeper in the Src folder)
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

thias15, 2020-11-15:
Yes, good point. I usually directly drop it into the folder in Android Studio. There the `src/main` folders are skipped. I will update this in the documentation.

Thanks!

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

Closed 2020-11-15.

Thread 116 (2020-11-18):

Android app crashes when logging started

zlite, 2020-11-18:
Your latest version of the Android app (updated two days ago) now crashes immediately every time when logging is started. Tested on Android 11 on Pixel 4

thias15, 2020-11-18:
Thanks for raising this issue. The changes were quite minor, mainly porting everything to the new SDK/API version. I will look into it.

zlite, 2020-11-18:
Might be a permissions thing?

zlite, 2020-11-18:
FWIW, If I just download and install the pre-compiled APK, it works, but asks me for permission to access files, camera, an Arduino, which the one I compiled myself in Android Studio doesn't (perhaps because I load it via developer mode)

thias15, 2020-11-18:
The permission handling is normal. I just finished my meetings and will look into it now. In the meantime, you can download the previous version of the app, for example from release v0.1

thias15, 2020-11-18:
Ok, turns out the file storage permission handline was changed in API30 (Android 11). I have reverted back to API28 for now. This solves the issue for now. I will look for better solution that works well with API30.

Closed 2020-11-18.

Thread 118 (2020-11-20):

How to charge my phone right on the robot ?

quockhanh1198, 2020-11-20:
Hi Thias, when I run the model with the phone's GPU the performance is very good so I intend to set it up by default, but the phone is quite battery consuming and I am not sure how to maintain the battery of the phone by charging the phone on robot most effective. Can you help me? Thank you so much !

thias15, 2020-11-20:
You could try a cable like [this](https://www.amazon.com/dp/B07CG3MR48). Connect one end to the Arduino and another to a power bank. Another option, if you are good with electronics/soldering is to open a USB cable and connect the 5V lines to the regulator on the L298N.

quockhanh1198, 2020-11-20:
Thank you for your reply

JamesNewton, 2021-03-12:
Many phones will not charge and operate an OTG device at the same time. I made a list of the ones that do. Also of some tablets and phones which have a seperate power jack.
http://www.massmind.org/techref/io/usb/otg.htm

Closed 2020-11-23.

Thread 119 (2020-11-20):

How to train the robot to avoid obstacles

Jojo11111, 2020-11-20:
Hello, thanks for your great work on this project. We have problems in training the car to avoid obstacles. We would like to know that if your chairs as obstacles are always placed in the same positions  or placed randomly during each data collection process.

thias15, 2020-11-20:
They are placed randomly during data collection. During test time they are placed in different locations. How much data did you collect? Can you share an image/video of your data collection setup?

Jojo11111, 2020-11-21:
We collect about 6000 images with obstacles by running a python file written by ourselves. We use a game controller to control the car to avoid obstacles and record the datas just like what you did. The result is that the car runs into the obstacles without any tendency to turn around.

thias15, 2020-11-23:
Ok, that's a very small dataset. I don't quite understand: Do you collect data with game controller or with a Python script? Can describe your data collection pipeline and maybe some sample images?

Jojo11111, 2020-11-25:
We collect data with game controller and save the data to matched_frame_ctrl_cmd_processed.txt with a python script

Here are some frames
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

And here is the matched_frame_ctrl_cmd_processed.txt
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

According to your previous reply, I think our method is correct, but the dataset is too small. We may try again later and then tell you the result.

Jojo11111, 2020-11-26:
This time we have more images for training and testing but it still doesn't works well.
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

we set epoch 60 and here are the training results
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

But when the tf model was converted to tflite model, an error occurred.
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
We are not sure what caused this error. But when we set epoch 40, the tflite model saved successfully.
Then we used the epoch_40-model for navigation and obstacle avoidance, but the result was discouraging.
Could you give us some suggestions?

thias15, 2020-11-30:
`[Errno 12] Cannot allocate memory` means that you do not have enough RAM memory for the conversion. I guess the memory is already at the limit during training.

The sudden drop in performance during training is not good. Maybe the learning rate is too high. What hyperparameters do you use? (learning rate, batch size, etc.)?

Jojo11111, 2020-12-07:
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

thias15, 2020-12-09:
For training the final model, it is recommended to increase the batch size. You may also try to use another model. The `model.cil_mobile` is a very compact model. You could try for example `model.pilot_net`. It has a higher capacity and may be able to learn your task more easily.

thias15, 2020-12-15:
Closing due to inactivity. Feel free to reopen or reach out on Slack.

Jojo11111, 2020-12-22:
Thanks you very much, we will try it later.

Closed 2020-12-15.

Thread 124 (2020-12-09):

[Feature] Maintain settings on configuration changes and between app runs

msesma, 2020-12-09:
Current implementation of the app maintains the camera selection on configuration changes, like a device rotation.

This feature proposal if for maintaining all settings not only during configuration changes but also between app runs.

Settings that will be persisted:

- Data Logger, and logging state.
- USB connection speed.
- Drive mode
- Camera
- Vehicle control
- Model
- Device
- Threads

Settings that won't be persisted

- Controller switch (For safety reasons)
- Connection switch (It changes automatically if a device is connected)

thias15, 2020-12-09:
This sounds great! I think the logging state should probably not be persistent either, since logging is usually turned on/off by a user during data collection. Thanks @msesma.

msesma, 2020-12-09:
Sounds reasonable. In that case I´ll make logging state survive configuration changes only.

vkuehn, 2020-12-10:
@msesma there is already some psersistence for the camera switch. please make sure it doesn't conflict with your changes

msesma, 2020-12-10:
@thias15 there is no need to persist camera on configuration changes anymore as it is persisted even between runs. But I will use that to persist log mode instead.

Closed 2020-12-11.

Thread 143 (2021-01-09):

how to connect ps3 controller to the app?

shark526, 2021-01-09:
This is a awesome project, thanks to all the contributors. I have already built the car success not trying turn to the drive policy training.
I have PS3 controller but could not find any clue on how to connect to the openbot app.
Anyone have such experience on this? Appreciate for your help.

thias15, 2021-01-09:
I'm not 100% sure about PS3 controller. But for a PS4 controller you just pair it with the phone via Bluetooth. There is also a smartphone app now. So if you have another phone you can also use that to control the bot.

shark526, 2021-01-10:
Hi @thias15 , thanks for the reply. Yeah I know the controller app in the repo, but unfortunately I don't have another Android phone.
Connect to ps4 controller must be easier. I had use the ps3 controller connect to Android phone many years ago,  but it required rooted phone and another app.  Wondering how the ps3 controller work with openbot...

thias15, 2021-01-10:
I don't see why the PS3 controller would be a y different from the PS4 controller. Did you try to pair?

shark526, 2021-01-10:
> I don't see why the PS3 controller would be a y different from the PS4 controller. Did you try to pair?

yes，no Bluetooth device could be found on phone after the PS button clicked.
PS3 controller should be the tricky Bluetooth device, I remember for the root phone solution, need connect with a otg wire, use another app to detect the mac address, then pair the Bluetooth...

thias15, 2021-01-11:
Ok, maybe it is easier to just buy a cheap knock-off BT game controller.

Closed 2021-01-12.

Thread 147 (2021-01-13):

Fix STL models for glue model

thias15, 2021-01-13:
Currently, there seems to be an issue when importing into Cura for slicing.

Closed 2021-01-20.

Thread 151 (2021-01-21):

About the policy

wangruoyao, 2021-01-21:
I'm new here and actually don't  know how the training works. Just import the images when I'm driving with trying to achieve some goals such as follow human or along the black line and train them in tensorflow?Do the neural network really know what it is doing?

I'm wondering if I can label the picture manually and train the car more intelligently such as recognize mini traffic light and then do what it is supposed do, and identify a particular people by outlook such as face, clothes, height or something, not just a general human and etc..

And even more, if I can train them individually and deploy them on the car?  Like find pictures online to improve the accuracy of recognition and then combine with the manually drive to let it know how to act at the circumstance. Despise the priority(when images have two or above different types of labels).

thias15, 2021-01-21:
The autopilot just regresses images to controls. The task needs to be setup in such a way that it is possible to infer the controls only from the image. So for example, if you drive the car to follow a black line and record the data, the network can learn to imitate this behaviour. More complex tasks can also be learned with more data, but the current network only support single-frame predictions. So if the network has to reason about the environment from memory, it won't work.

The alternative is to build a system. For example like the object detector which is trained offline to detect objects and a large-scale dataset. The predictions are then used to compute controls. You could similarly run multiple networks, e.g. one to detect traffic signs, one to follow the road, one to stop for obstacles, etc. Then you could build a state machine that produces controls taking all those predictions into account.

wangruoyao, 2021-01-22:
Thanks for your reply. Now I know how it works better, it is based on images rather than on labels right？

 I will try it from a simple way like follow a black line and see how it works.

And then try the second suggestion, which looks like really hard to achieve for me.

Closed 2021-01-23.

Thread 160 (2021-02-25):

Gerber files request

xebbmw, 2021-02-25:
Hello,

I found this interesting project and I would like to build it as an educational project.

I am planning to submit the Gerber files to a manufacturer and then solder the parts myself using a hot air station and a solder iron.

Soldering 0603 SMD parts is doable, but I would prefer instead to solder 0805 SMD. Please provide another version of Gerber files (v2a) where the parts in size 0603 are replaced by 0805 size.

Thanks in advance for your help.

thias15, 2021-02-25:
The gerber files are in the repo. Please refer to the [README](https://github.com/intel-isl/OpenBot/tree/master/body/pcb/README.md) for more info.

xebbmw, 2021-02-25:
> If you prefer I can give you access to the EasyEDA project or export it to a format you can work with. Then you can make any required changes yourself.
Hello,
Thanks for your help. I would prefer access to the files in Eagle CAD (version 7.50) or KiCAD format. Then I can do the required changes myself. Later I can provide you the new version, maybe others would be interested too.

thias15, 2021-02-25:
That sounds great. Here is the converted file (in KiCAD format). There were a few warnings during the conversion. So please let me know if the attached file works. [
[PCB_OpenBotV2.kicad_pcb.txt](https://github.com/intel-isl/OpenBot/files/6045532/PCB_OpenBotV2.kicad_pcb.txt)
](url)

xebbmw, 2021-02-26:
Thanks, I tried to open the file. Not sure if it is the correct file, because I see the PCB has different components (about 13 resistors, 4 capacitors and an small integrated circuit with 48 pins) and also a different layout. See attached file how it looks in Kicad:
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
Also there is another problem, in Kicad I only see pads not the component itself (like resistor for example). It will be difficult in this way to change the component footprint size just by manipulating the pads size.

thias15, 2021-03-02:
Sorry, it seems I uploaded the wrong file by mistake. I have reuploaded. The problem is that I can only export a json file from EasyEDA. I found an online tool to convert to kicad, but it is possible that the components are lost in that process. Here is also the original [json file](https://github.com/intel-isl/OpenBot/files/6071067/DRV8871_Rev2_2021-03-02_19-55-05.json.txt). This is the tool I used [easyeda2kicad](https://wokwi.com/easyeda2kicad). Hope this helps. I have reopened the issue. If this still not works, I can make the changes and provide an updated Gerber file.

xebbmw, 2021-03-03:
Thanks a lot, this time worked just fine! I was able to convert the file and then open it in Kicad. I made the changes for the components C1, C2, LED1, R7, R1, R2, these are now in 0805 format. Here is how it looks right now:
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
I will enlarge just a bit the tracks and then I will generate the Gerber file. I will provide you the files afterwards.

thias15, 2021-03-03:
Thanks @xebbmw. The only thing is that the OpenBot logo and text seem to be messed up by the conversion. But I guess that is not a big deal.

xebbmw, 2021-03-04:
I added the logo that I found on Github, but I could not find the second logo that is in the middle of the board. Also I don't know if there is something else on the other side of the board.
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
Please add the second logo so I could insert it also.

thias15, 2021-03-04:
Not sure how to export the icon. You could just find one with a permissive license that looks similar. The icon is just to show the the PCB may become hot during operation and should not be touched. There is nothing on the other side of the board for now.

xebbmw, 2021-03-06:
I added the second logo from the file pcb_2d_v2.png from this repository and then I imported it. This is the new version with a screenshot from the Gerber viewer.
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
If is ok with you, I will send you all the Gerber files so you can add them to the repository.

thias15, 2021-03-08:
Yes, that would be great. Thanks a lot! This will be very helpful for ppl who want to solder by hand.

xebbmw, 2021-03-12:
I attached a zip file with all the Gerber files. Thanks once again for providing me the sources!
[gerber_v2a.zip](https://github.com/intel-isl/OpenBot/files/6127380/gerber_v2a.zip)

Closed 2021-03-08.

Thread 189 (2021-05-07):

A Issue In Python Controller

Twisted-Fates, 2021-05-07:
Hello!
When I open keyboard-pygame.py or keyboard-click.py，the phone can't connect my computer(Windows 10).

thias15, 2021-05-07:
Can you please elaborate on the problem. Are you seeing some error message? Did you toggle to the "smartphone controller" on the OpenBot app.

Twisted-Fates, 2021-05-07:
Thankyou for your reply!
This is my problem:

------------------&nbsp;原始邮件&nbsp;------------------
发件人: ***@***.***&gt;;
发送时间: 2021年5月8日(星期六) 凌晨0:45
收件人: ***@***.***&gt;;
抄送: ***@***.***&gt;; ***@***.***&gt;;
主题: Re: [intel-isl/OpenBot] A Issue In Python Controller (#189)

Can you please elaborate on the problem. Are you seeing some error message? Did you toggle to the "smartphone controller" on the OpenBot app.

—
You are receiving this because you authored the thread.
Reply to this email directly, view it on GitHub, or unsubscribe.

Twisted-Fates, 2021-05-08:
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

Twisted-Fates, 2021-05-08:
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

Please help me.
I don't know how to deal with it.

thias15, 2021-05-08:
It looks like you executed the `pip install -r requirements.txt` before activating the environment and it installed fine. So try conda deactivate so you are in the base environment where it seems to be installed and then run the script. When you are in the conda environment it seems pygame cannot be found which seems very strange since it is very common. You could also try to install pygame via conda using the command `conda install pygame` after activating the environment.

thias15, 2021-05-08:
When you run the conda install the error message states you don't have the channels for pygame, so you need to try the command I posted above: `conda install -c cogsci pygame`

thias15, 2021-05-08:
When you do not have the environment activated and you see "Waiting for connection", this is the expected behavior, so it seems to be working. However, it seems the devices cannot see each other. If your router has a 2.4Ghz and 5Ghz mode, it could be that the phone and laptop are connected to different versions of your network. So you can try to disable the 5Ghz band on your router.

thias15, 2021-05-08:
Are phone and laptop connected to the same WiFi? Do both have a valid IP address?

Twisted-Fates, 2021-05-09:
My laptop create a Mobile hotspot and phone connect to it.

------------------&nbsp;原始邮件&nbsp;------------------
发件人: ***@***.***&gt;;
发送时间: 2021年5月9日(星期天) 凌晨1:51
收件人: ***@***.***&gt;;
抄送: ***@***.***&gt;; ***@***.***&gt;;
主题: Re: [intel-isl/OpenBot] A Issue In Python Controller (#189)

Are phone and laptop connected to the same WiFi? Do both have a valid IP address?

—
You are receiving this because you authored the thread.
Reply to this email directly, view it on GitHub, or unsubscribe.

thias15, 2021-05-09:
@izivkov do you have any intuition if a direct connection via hotspot would work?

izivkov, 2021-05-09:
The connection was meant to be used as two devices on the same network connected to the same router.

I think somebody had a similar problem before. They resolved it by using one phone as a hotspot, and two other phones for the controller and the bot. They had problem if one of the phone was used as the hotspot and running the controller or the bot software on it. I think it has to do with how services are discovered on the network.

thias15, 2021-05-10:
Also, you can try the latest OpenBot app version from master. You can download it from [here](https://github.com/intel-isl/OpenBot/actions/runs/818493537).

Twisted-Fates, 2021-05-10:
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

thias15, 2021-05-10:
Ok, it seems the pygame in the conda channel needs python 3.5. So you need to downgrade your python installation. Or use the Installation outside the conda environment.

thias15, 2021-05-10:
Did you try the app version I liked above outside the conda environment where the pygame installation had worked?

thias15, 2021-05-12:
Any update?

Twisted-Fates, 2021-05-12:
Sorry！I am busy recently.（crying...）

thias15, 2021-05-18:
Closing due to inactivity. If the problem persists, feel free to open again.

Closed 2021-05-18.

Thread 190 (2021-05-09):

Can't see Video on PC (Windows 10) with python

bender2po, 2021-05-09:
**Describe the bug**
Can't see Video on PC (Windows 10) with python.

**To Reproduce**
Steps to reproduce the behavior:
1. Go to 'cmd'
2. Type  'python keyboard-pygame.py --video'
3. See error: I cannot see any video stream of the robot.

**Expected behavior**
I am expecting to see a video pop-up and which displays camera-view of the robot.

**Screenshots**
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

**Desktop (please complete the following information):**
 - OS: Windows 10

**Smartphone (please complete the following information):**
 - Device: Motorola 5gs plus

thias15, 2021-05-09:
It's not tested on Windows but should work. On the phone are you on the FreeRoam screen? Only on that screen video is implented right now. Does the connection work otherwise, i.e. can you control the bot with the keyboard?

bender2po, 2021-05-09:
Thank you for the response.

I checked for 'Default' and 'FreeRoam' screens. Video stream is not working for both.

I think connection is established because I can see speed and steering values changing on the FreeRoam-screen on the phone, according to the keyboard input.

Currently, I am performing only open-loop testing, i.e., the bot is not connected yet.

thias15, 2021-05-09:
Ok, video should also work open loop. Just the latency is currently still a bit too high to drive. Have you agreed to the permissions for camera and audio? @izivkov do you have any idea what the problem might be?

izivkov, 2021-05-09:
From the screenshot, looks like the python app is disconnected at this time. The last line reads "Received"only, which means the program did not receive any data from the Bot, and this causes the python program to exit. Try restarting the python and establish connection again.
If no video, try switching between FreeRoam and Default screen, a few times. In FreeRaom screen, should see video.

bender2po, 2021-05-10:
I don't think connection disconnected because I can still control the values (speed, steering on FreeRoam) via keyboard.

I tried as @izivkov suggested. Still no luck. Please see screen-shot below:
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

izivkov, 2021-05-10:
Hmm, there should be "VIDEO_SERVER_URL" and "VIDEO_COMMAND" sent to the python program, which I don't see. Did you press the "Controller" button (left most button at the bottom of the FreeRoam screen on the android app)? This should change its icon from a controller to a phone.

izivkov, 2021-05-10:
I can see two reasons why the video is not started:
1. Camera permissions is not set. You can manually check this by going to the app settings, find the OpenBot app, and check permissions. If not set, you can set the camera permission manually from there.
2. The network connection is of type "Nearby", which cannot carry video. This happens if WiFi on the phone is turned off, or you are not logged in to a WiFi network. Make sure both the Phone and the PC are connected on the same WiFi network. As I mention in response to another issue, the Hotspot should not be one of the devices. Please try another hotspot, like another phone, and both the Bot phone and the PC should connect to this hotspot.

izivkov, 2021-05-10:
You also updated to the latest app version, right? The python script works with the latest APK.

bender2po, 2021-05-10:
I am also expecting to see "VIDEO_SERVER_URL" and "VIDEO_COMMAND" in order to satisfy the python's 'if-conditions'.

1. Camera, Location, Microphone, Storage permissions were given.
2. I tried connecting Computer (python) and Phone (OpenBot) to the router as well as another phone's hot spot. Same result in the both scenarios. That is video is not working. However, I could play with keyboard on computer, and, see speedometer and steering GUI on OpenBot app is changing nicely (ie, no visual delay).
3. I am using 'OpenBot-0.3.1.apk'. Is this the latest one?

izivkov, 2021-05-10:
OK, forget what I said about the network connection type. I deleted this comment. This is not the problem since you are communicating to the python script.
So, just check the following:
1. You are running the latest APK for the bot app.
2. Your camera permission is enables in the setting for the OpenBot app.
3. You are using  a third device for hotspot.

izivkov, 2021-05-10:
You can download the app from here, using the barcode:

https://github.com/intel-isl/OpenBot/tree/master/android

bender2po, 2021-05-10:
The barcode directs me to the version 'OpenBot-0.3.1.apk'. Which is already in use.

izivkov, 2021-05-10:
Yes, I need to investigate a bit more. All the basics are correct and it should work. Maybe you can help by trying with a different phone.

bender2po, 2021-05-10:
I just tried with Oneplus-Nord. Still no luck.

thias15, 2021-05-10:
Can you try the latest OpenBot app version from master? You can download it from [here](https://github.com/intel-isl/OpenBot/actions/runs/818493537).

bender2po, 2021-05-10:
@thias15 It is getting stuck here:
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

thias15, 2021-05-10:
Ok, you are almost there now. In principle you should then  see a window with the video stream open. It may take a few seconds. Does it just get stuck there indefinitely? Did you move/rotate the phone in the meantime? This can cause issues since on every rotation it will try to reconnect.

bender2po, 2021-05-10:
Yes, it is stuck indefinitely!!

I locked the phone screen in Potrait in one scenario and Landscape in an another scenario. In both the scenarios the python-script got stuck. (FYI, the phone getting heated up nicely. I guess the phone is doing hard work )

thias15, 2021-05-10:
Ok, great to hear it! If you figure out at some point what the issue was, it would be very helpful to know for others.

bender2po, 2021-05-10:
Sure, I will post here if I figure out the reason.

moneypi, 2021-05-26:
Hello, I met the same problem, any help?
Thanks!

bender2po, 2021-05-27:
@moneypi I am not expert in this field. This is what worked for me (and a workaround as well):
1. Installed the debug version of android app from here: https://github.com/intel-isl/OpenBot/actions/runs/818493537
2. Replaced some part of 'play_video' method in the VideoPlayer with below snippet
`    def play_video(self):
        if not self.stream:
            print(f'Sream not set')
            return
        print(f'Opening the stream...{self.stream}')
        cap = cv2.VideoCapture(self.stream)

        while(cap.isOpened()):
            ret, img = cap.read()
            #img = cv2.rotate(img, cv2.ROTATE_180)
            cv2.imshow('Video', img)
            cv2.waitKey(1)`
3. (optional) reduce pygame window size from setup_screen
4. Make sure your PC and phone are connected to same WiFi source
5. Open the debug app and select 'Free Roam'. On your PC: run the python code with '--video'. Now, you would see two pop-ups: one for stream and another for pygame control. You should select the pygame window to use keyboard control.
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

moneypi, 2021-05-27:
Thanks, my friend fix this for me.
He comment ```andGate.addCondition("camera permission");``` from https://github.com/intel-isl/OpenBot/blob/master/android/app/src/main/java/org/openbot/env/RtspServer.java and rebuild Android APP.
And I got Video Stream.

FYI, my phone is Redmi K30 5G/MIUI 12.1.8.

izivkov, 2021-05-27:
Hmm, you need camera permissions. You have bypassed it for now, but can
cause problems in the future.

The first think I would check is if the app has camera permissions from the
setup.

If not, you can set it manually. But I would uninstall the app, build it
again, and it should ask you to grant permission for the camera.

If not, you maybe running a pretty old version of Android. What is your
Android version.

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

moneypi, 2021-05-27:
Android Version 11
And，when running the app first time, I got the question: Take photos and record videos. And I select "Allow only while using the app".

I am not familiar with Android, maybe that's the reason.

izivkov, 2021-05-27:
Thanks, I'll check if the code has a problem with android 11.

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

moneypi, 2021-05-28:
My friend told me that is the problem of MIUI, which is different with the standard Android.

BaoAn21, 2025-04-03:
I see that this is a closed issue, but I face this and can not make it work, could anyone help me

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
I got to this point, and pygame was just freeze (you can see my mouse is loading) I need to force quit it because it was not run.
I use Samsung A06

BaoAn21, 2025-04-03:
I see that this is closed issue, but I face this and can not make it work.

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
I got to this point, and pygame was just freeze, I need to Force Quit the app, no video streaming happen
I use Samsung A06,
Could anyone help me? Thank you in advance

Closed 2021-05-10.

Thread 193 (2021-05-12):

Logger fragment

thias15, 2021-05-12:
- Detailed settings menu to specify custom resolution and cropping
- Training image → Image
- Preview image → Video (mp4)
- Detailed settings menu where user can choose sensors they want to log individually (+ select all option), only report and log sensor that are available on that phone
- Local Save/ Server upload toggle

thias15, 2021-07-22:
Will be handled in separate PRs.

Closed 2021-07-22.

Thread 197 (2021-05-14):

Spring cleaning

thias15, 2021-05-14:
- go through crash logs and fix bugs

thias15, 2021-06-07:
There do not seem to be any crashes that affect multiple users. There are some crashes that are due to development.

Closed 2021-06-07.

Thread 206 (2021-07-21):

ImageUtils.getScreenOrientation is not supported in older devices and causes crash

MohammedZ666, 2021-07-21:
The following method was updated [in this commit](https://github.com/intel-isl/OpenBot/commit/7e6b220f0988746f6ebdbdaea5a585e29b86f7b0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) to remove the depreciated call `activity.getWindowManager().getDefaultDisplay().getRotation()`  Unfortunately this crashes my device which has API 21. The call  `activity.getDisplay().getRotation()` requires API level 30:
```
public static int getScreenOrientation(Activity activity) {
    switch (activity.getDisplay().getRotation()) {
      case Surface.ROTATION_270:
        return 270;
      case Surface.ROTATION_180:
        return 180;
      case Surface.ROTATION_90:
        return 90;
      case Surface.ROTATION_0:
      default:
        return 0;
    }
  }
```
Can I replace this method with the following one?
```
public static int getScreenOrientation(Activity activity) {
    int rotation = Build.VERSION.SDK_INT >= Build.VERSION_CODES.R?
             activity.getDisplay().getRotation() : activity.getWindowManager().getDefaultDisplay().getRotation();
    switch (rotation) {
        case Surface.ROTATION_270:
          return 270;
        case Surface.ROTATION_180:
          return 180;
        case Surface.ROTATION_90:
          return 90;
        case Surface.ROTATION_0:
        default:
          return 0;

    }
  }
```
**Adding the above call fixes my problem.**

This is my logcat:
```
07-21 22:27:48.332 29430-29430/org.openbot E/AndroidRuntime: FATAL EXCEPTION: main
    Process: org.openbot, PID: 29430
    java.lang.NoSuchMethodError: No virtual method getDisplay()Landroid/view/Display; in class Landroid/app/Activity; or its super classes (declaration of 'android.app.Activity' appears in /system/framework/framework.jar)
        at org.openbot.env.ImageUtils.getScreenOrientation(ImageUtils.java:228)
        at org.openbot.common.CameraFragment.bindCameraUseCases(CameraFragment.java:102)
        at org.openbot.common.CameraFragment.setAnalyserResolution(CameraFragment.java:188)
        at org.openbot.autopilot.AutopilotFragment.onViewCreated(AutopilotFragment.java:116)
        at androidx.fragment.app.Fragment.performViewCreated(Fragment.java:2987)
        at androidx.fragment.app.FragmentStateManager.createView(FragmentStateManager.java:546)
        at androidx.fragment.app.FragmentStateManager.moveToExpectedState(FragmentStateManager.java:282)
        at androidx.fragment.app.FragmentManager.executeOpsTogether(FragmentManager.java:2189)
        at androidx.fragment.app.FragmentManager.removeRedundantOperationsAndExecute(FragmentManager.java:2106)
        at androidx.fragment.app.FragmentManager.execPendingActions(FragmentManager.java:2002)
        at androidx.fragment.app.FragmentManager$5.run(FragmentManager.java:524)
        at android.os.Handler.handleCallback(Handler.java:739)
        at android.os.Handler.dispatchMessage(Handler.java:95)
        at android.os.Looper.loop(Looper.java:148)
        at android.app.ActivityThread.main(ActivityThread.java:7223)
        at java.lang.reflect.Method.invoke(Native Method)
        at com.android.internal.os.ZygoteInit$MethodAndArgsCaller.run(ZygoteInit.java:1230)
        at com.android.internal.os.ZygoteInit.main(ZygoteInit.java:1120)
```
**This way older devices like mine may be supported. Thanks!**

thias15, 2021-07-21:
Please follow the [contribution guidelines](https://github.com/intel-isl/OpenBot/blob/master/CONTRIBUTING.md) to open a PR. You can then link this issue to it. Thank you very much!

MohammedZ666, 2021-07-21:
Thanks!

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

Closed 2021-07-21.

Thread 209 (2021-07-22):

App crashes in Autopilot fragment, when "Auto Mode" switch is activated

MohammedZ666, 2021-07-22:
**Bug Description**
App crashes in the **Autopilot fragment** when the **Auto Mode** switch is activated.

**To Reproduce**
Steps to reproduce the behavior:
1. Go to **Autopilot**
2. Turn on the **Auto Mode** switch
3. App may immediately crash
4. Logcat:
```
07-22 10:07:53.736 27209-27581/org.openbot E/AndroidRuntime: FATAL EXCEPTION: inference
    Process: org.openbot, PID: 27209
    android.view.ViewRootImpl$CalledFromWrongThreadException: Only the original thread that created a view hierarchy can touch its views.
        at android.view.ViewRootImpl.checkThread(ViewRootImpl.java:8203)
        at android.view.ViewRootImpl.invalidateChildInParent(ViewRootImpl.java:1309)
        at android.view.ViewGroup.invalidateChild(ViewGroup.java:5430)
        at android.view.View.invalidateInternal(View.java:13959)
        at android.view.View.invalidate(View.java:13923)
        at android.view.View.invalidate(View.java:13907)
        at android.widget.TextView.checkForRelayout(TextView.java:8373)
        at android.widget.TextView.setText(TextView.java:5001)
        at android.widget.TextView.setText(TextView.java:4828)
        at android.widget.TextView.setText(TextView.java:4803)
        at org.openbot.autopilot.AutopilotFragment.handleDriveCommand(AutopilotFragment.java:443)
        at org.openbot.autopilot.AutopilotFragment.lambda$processFrame$18$AutopilotFragment(AutopilotFragment.java:424)
        at org.openbot.autopilot.-$$Lambda$AutopilotFragment$AD5NQvceNuqdJYNKu4y74kjwNKo.run(lambda)
        at android.os.Handler.handleCallback(Handler.java:739)
        at android.os.Handler.dispatchMessage(Handler.java:95)
        at android.os.Looper.loop(Looper.java:148)
        at android.os.HandlerThread.run(HandlerThread.java:61)
```

**Fix**
In AutopilotFragment.handleDriveCommand the textview **controlInfo** is being updated from a **child** thread. It should be **called from the main thread**, in this way:
```
  protected void handleDriveCommand(Control control) {
    vehicle.setControl(control);
    float left = vehicle.getLeftSpeed();
    float right = vehicle.getRightSpeed();
    requireActivity()
        .runOnUiThread(
            () ->
                binding.controllerContainer.controlInfo.setText(
                    String.format(Locale.US, "%.0f,%.0f", left, right)));
  }
```
In the same way, the onConnectionEstablished is updating another text view:
```
@Override
  public void onConnectionEstablished(String ipAddress) {
    requireActivity().runOnUiThread(() -> binding.ipAddress.setText(ipAddress));
  }
```

**Screenshots**
Here is the gif for better explanation:
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

**Smartphone (please complete the following information):**
 - Device: [e.g. Samsung J7]
 - OS: [e.g. Android 6]

**Additional context**
Add any other context about the problem here.

thias15, 2021-07-22:
Interesting. In newer versions of Android this is not a problem.

thias15, 2021-07-22:
Fixed in #210

Closed 2021-07-22.

Thread 211 (2021-07-22):

App crashes in Object Tracking fragment, when "Auto Mode" switch is activated

MohammedZ666, 2021-07-22:
**Bug Description**
App crashes in the **Object Tracking Fragment** when the **Auto Mode** switch is activated.

**To Reproduce**
Steps to reproduce the behavior:
1. Go to **Object Tracking**
2. Turn on the **Auto Mod**e switch
3. App may immediately crash
4. Logcat:
```
07-22 12:02:06.196 26472-26554/org.openbot E/AndroidRuntime: FATAL EXCEPTION: inference
    Process: org.openbot, PID: 26472
    android.view.ViewRootImpl$CalledFromWrongThreadException: Only the original thread that created a view hierarchy can touch its views.
        at android.view.ViewRootImpl.checkThread(ViewRootImpl.java:8203)
        at android.view.ViewRootImpl.invalidateChildInParent(ViewRootImpl.java:1309)
        at android.view.ViewGroup.invalidateChild(ViewGroup.java:5430)
        at android.view.View.invalidateInternal(View.java:13959)
        at android.view.View.invalidate(View.java:13923)
        at android.view.View.invalidate(View.java:13907)
        at android.widget.TextView.checkForRelayout(TextView.java:8373)
        at android.widget.TextView.setText(TextView.java:5001)
        at android.widget.TextView.setText(TextView.java:4828)
        at android.widget.TextView.setText(TextView.java:4803)
        at org.openbot.objectNav.ObjectNavFragment.handleDriveCommand(ObjectNavFragment.java:500)
        at org.openbot.objectNav.ObjectNavFragment.lambda$processFrame$20$ObjectNavFragment(ObjectNavFragment.java:481)
        at org.openbot.objectNav.-$$Lambda$ObjectNavFragment$0cdHF_u8fuQJw1ABfb-EY_bHL6g.run(lambda)
        at android.os.Handler.handleCallback(Handler.java:739)
        at android.os.Handler.dispatchMessage(Handler.java:95)
        at android.os.Looper.loop(Looper.java:148)
        at android.os.HandlerThread.run(HandlerThread.java:61)
```

**Fix**
In ObjectNavFragment.handleDriveCommand the textview **controlInfo** is being updated from a **child** thread. It should be **called from the main thread**, in this way:
```
  protected void handleDriveCommand(Control control) {
    vehicle.setControl(control);
    float left = vehicle.getLeftSpeed();
    float right = vehicle.getRightSpeed();
    requireActivity()
        .runOnUiThread(
            () ->
                binding.controllerContainer.controlInfo.setText(
                    String.format(Locale.US, "%.0f,%.0f", left, right)));
  }
```
In the same way, the onConnectionEstablished is updating another text view:
```
@Override
  public void onConnectionEstablished(String ipAddress) {
    requireActivity().runOnUiThread(() -> binding.ipAddress.setText(ipAddress));
  }
```
[This is similar to this issue](https://github.com/intel-isl/OpenBot/issues/209)

**Screenshots**
Here is the gif for a better explanation:
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

**Smartphone (please complete the following information):**
 - Device: [e.g. Samsung J7]
 - OS: [e.g. Android 6]

thias15, 2021-07-22:
Interesting. In newer versions of Android this is not a problem.

Closed 2021-07-22.

Thread 215 (2021-08-16):

video stream problem: pps_id 1388 out of range

thomasfermi, 2021-08-16:
**Describe the bug**
When I run `python keyboard-pygame.py --video`, I do not see a video but rather the following error messages in the terminal

```bash
Starting video...
Opening the stream...
[h264 @ 000002203bf6e0c0] pps_id 1388 out of range
[h264 @ 000002203bf6e0c0] pps_id 1388 out of range
[h264 @ 000002203bf6e0c0] decode_slice_header error
[h264 @ 000002203bf6e0c0] no frame!
Checking the stream...
[h264 @ 000002203c03eb00] pps_id 1388 out of range
[h264 @ 000002203c03eb00] decode_slice_header error
[h264 @ 000002203c03eb00] no frame!
Can't read stream
```

**To Reproduce**
On Windows 10, do
```bash
conda create -n openbot python=3.7
conda activate openbot
cd python
conda install pip
pip install -r requirements.txt
python keyboard-pygame.py --video
```

(I also tried to create an environment from the `policy` folder (without tensorflow, since I do not need that) first and then install the requirements from the `python` folder. Makes no difference)

**Expected behavior**
Video Stream should be visible

**Desktop:**
 - OS: Windows 10

**Smartphone:**
 - Device: Pixel 4a
 - Android 11

**Additional context**
I can view the stream in VLC media player. I also tried adding the following snippet to the `VideoPlayer` class in `keyboard-pygame.py` (right after `print("Can't read stream")`; depends on [python-vlc](https://pypi.org/project/python-vlc/))
```python
 import vlc
 player=vlc.MediaPlayer(self.stream)
 player.play()
```
That leads to the video stream being played. But of course this is not a proper solution.

thomasfermi, 2021-08-16:
Update: Just tried the same thing with an Ubuntu machine and I get the same error. So maybe something is wrong with the way I set up my conda environment? Or is it the Android app?

thias15, 2021-08-16:
@izivkov could you look into this?

izivkov, 2021-08-17:
I will take a look at this.

thomasfermi, 2021-08-17:
Hi @izivkov , thanks for taking a look! I tried with the latest [master build](https://github.com/isl-org/OpenBot/actions/runs/1137164158) but got the same results. Later today I will try with another phone, currently I only have mine.

By the way: When I connect with VLC, the video lags by roughly 2 seconds. Is that also the lag you experience?

izivkov, 2021-08-17:
> Hi @izivkov , thanks for taking a look! I tried with the latest [master build](https://github.com/isl-org/OpenBot/actions/runs/1137164158) but got the same results. Later today I will try with another phone, currently I only have mine.
>

OK, trying another phone will narrow the problem. My best guess is that unlike VLC, python's `opencv` does not support some codec in some phones. I read there is a way to force a specific codec on the python side, like MP4.

> By the way: When I connect with VLC, the video lags by roughly 2 seconds. Is that also the lag you experience?

Yes, there is a delay in the video. This is typical for RTSP protocol. The Android app also supports WebRTC, which is much better, but it only works with the Android controller app. I have not been able to figure out how to get it to work with Python nativity. It is also a serverless version WebRTC (to make it easier to setup with the controller app), so will not work with a standard WebRTC client, like a Node/Web Browser. Maybe another feature is to add `standard` WebRTC.

thomasfermi, 2021-08-17:
I just tried with a Huawei phone. I get until the point when the "Stream resolution" is being printed to console:
```bash
Starting video...
Opening the stream...
Checking the stream...
Stream resolution: (720, 720, 3)
```
Then the python application freezes. I tried with the master build of the app, and the regular version.

Regarding RTSP and WebRTC: Would be really nice to have WebRTC work with the python app, since 2s delay is really a problem...

izivkov, 2021-08-17:
OK, thanks for trying. So the phone does make some difference. One basic think to try is to check the permissions on the OpenBot app. Permissions should be set when the app if first run, but just to be sure: From your phone settings -> "Apps and notifications" -> "OpenBot" app -> Permissions, and make sure all permissions are enabled, especially "Camera".

I remember for Huawei phone in particular, somebody had a problem reading the permissions from the app, even if they are set correctly. He fixed the issue by commenting line 60 in RtspServer class in the app.

```// andGate.addCondition("camera permission");```

You may want to try that.

izivkov, 2021-08-18:
Nevermind, ignore my previous comment. I forgot you could stream to VLC.

izivkov, 2021-08-20:
OK, since `VLC` seems to work better than `opencv`, I will replace the opencv in the python script with this:

```https://pypi.org/project/python-vlc/```

Now, python/pygame is not really my forte, so if somebody here has a burning desire to take a crack at it, please go ahead.

izivkov, 2021-08-20:
Just noticed, for the above to work, a VLC player has to be installed on the machine. So this is not ideal. Any alternative ideas will be appreciated.

thomasfermi, 2021-08-25:
Yeah, you are right, `python-vlc` works, but depends on a VLC installation. Maybe it is better to spend time on getting the WebRTC connection to work, rather than improving the current RTSP connection (which is laggy).

Sadly I do not have any knowledge in this domain... Once I find some time, I will try to learn a bit about WebRTC

izivkov, 2021-08-25:
@Mention ***@***.***>  Ok, I'm a little busy these days, so
cannot work on this at the moment. If you decide to work on it, I can be of
assistance.

On Wed, Aug 25, 2021, 10:58 AM Mario Theers ***@***.***>
wrote:

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

izivkov, 2021-09-01:
@thias15 , @thomasfermi
I am looking at how to implement WebRTC for the desktop. AFAIK, there is no python library to display the WebRTC stream, similar to RTSP. So, the video can be displayed in the browser, with some JS. So, here is my approach:
- Write a small Python program to connect to the bot app as it does now. This way there is not change the to bot app.
- The Python app will act as a web server to the web browser and the JavaScript. It will also proxy the commands from the bot to the JS and browser.
- The JS code will handle all WebRTC protocol, and will show the video in the browser.
I makes sense the commands to the bit to be sent from the browser. Also, I have not fugured a way for the Python code to act as a keyboard handler and a web server at the same time, but maybe this is possible. This way we only have one window on focus.
- There may need to be some UI controls  in addition the the video element to drive the robot.
- In this way, this essentially becomes a JS project, because all the logic will reside on the browser. I like to get your opinion of this is something worth doing, or if you have any other suggestions.

thomasfermi, 2021-09-05:
Hey @izivkov ! I am happy to give my personal opinion :)

From my perspective the promise of the python app is the following: Yes, you can control the bot via keyboard, but what is even better is that the python app is an entry point for personal projects. The code should give easy access to the robot's sensors (including video) as well as its actuators. Python is a great language for beginners to start playing with the bot.

If there is no suitable library for grabbing the WebRTC stream in python, this is a big problem of course. I found [this library](https://github.com/aiortc/aiortc) but probably you already checked that out.

The idea with JS code sounds promising! I am not sure however what the purpose of the python app would be then. Maybe one should do everything in JS in this case? A lot of people know JS, so the app could still be an entry point for beginners to build personal projects. I do not know much JS, but I would certainly play around with such a JS app.

izivkov, 2021-09-06:
@thomasfermi , thanks for your input. I looked at `aiortc` at one time, but I thought it had too many OS dependencies. However, at a closer look, this may not be a big issue, if at all. Looks promising, and I will attempt to integrate it in the bot's python code.

thomasfermi, 2021-09-06:
Hey @izivkov , that sounds awesome :) Looking forward to it!

izivkov, 2021-09-21:
Unfortunately, I run into problems interfacing python WebRTC to the open bot android app. The two can exchange information, but they fail to negotiate WenRTC capabilities. I think this is due to some incompatibilities between the implementation of `aiortc` and and Google's Android implementation `https://webrtc.org/`.

Second problem is playing the video in python. All the `aiortc` examples I have seen use  python as the source of the video, and a web browser as the display. In our case we want to use android app as the source, and python to display the video.

In any case, if somebody is interested to investigate further, I have put the related code on my GitHub repository here:

https://github.com/izivkov/OpenBot/tree/ivo/python-webrtc

thomasfermi, 2021-09-29:
Hi @izivkov , thanks for looking into it. Too bad that there is an incompatibility.

thias15, 2021-12-21:
@thomasfermi, please try out the new node-js server by @izivkov

Closed 2021-12-21.

Thread 216 (2021-08-16):

Taobao purchase links on CN version of `build your robot body` are unable to use

AmagiDDmxh, 2021-08-16:
**Describe the bug**

Links in the section of "料清单" are unable to open and use, which simply redirect to Taobao home page all the time whether I've logged in or not

PAGE LINK: https://github.com/isl-org/OpenBot/blob/master/body/README_CN.md

**To Reproduce**
Steps to reproduce the behavior:
1. Go to 'https://github.com/isl-org/OpenBot/blob/master/body/README_CN.md'
2. Click on any '淘宝购买' in “料清单” section
3. Open up Taobao link but non of any item detail page was shown

**Expected behavior**
Should open up a detailed HW item page

**Screenshots**
If applicable, add screenshots to help explain your problem.

**Desktop (please complete the following information):**
 - OS: Mac OS
 - Browser Chrome
 - Version 92.0.4515.131

**Additional context**

Haven't found anything useful, the share link format of Taobao seems to change every year? Let me try to figure out this!

thias15, 2021-08-16:
Can you fix it @leegang or @AmagiDDmxh and send a PR. In general the Chinese documentation is very updated and could really use an overhaul across the complete repo.

thias15, 2021-09-10:
Anyone who can updated the Chinese links and documentation?

Closed 2021-12-21.

Thread 230 (2021-10-18):

.github/workflows/traffic.yml: All jobs have failed

vkuehn, 2021-10-18:
**Describe the bug**
after having cloned that repository for while suddenly I get that error

.github/workflows/traffic.yml: All jobs have failed

looking at the yml it looks like it is getting statistics about the repo from another repo.

**To Reproduce**
just fork the repo

**Expected behavior**
no issues after forking the repo.

Multiple solutions are possible here. However forking is a part of the github standard flow so any solution to it is greatly appreciated.

**Screenshots**
not applicable

**Desktop (please complete the following information):**
github repo issue

**Smartphone (please complete the following information):**
not needed in that context

**Additional context**
already started the discussion in slack about it

thias15, 2021-11-12:
There are two possible solutions:
1) Go to your fork, e.g. in your case https://github.com/vkuehn/OpenBot/settings/actions and disable all actions or filter out the traffic.yml.
2) Delete the traffic.yml from the workflow folder in your fork: https://github.com/vkuehn/OpenBot/blob/master/.github/workflows/traffic.yml

vkuehn, 2021-11-15:
than I would be never able to contribute again...right ?

Closed 2021-11-12.

Thread 233 (2021-11-10):

Add button to web interface to manually trigger data preprocessing

thias15, 2021-11-10:
Add button to the uploaded tab which will scan the upload folder for items that have been added manually and preprocess them.

thias15, 2021-12-21:
@sanyatuning

sanyatuning, 2021-12-21:
@thias15 a simple page reload will rescan the uploaded dir.
Do you want a "redo matching" to this menu?
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

Or something else?

thias15, 2022-01-31:
Redo matching in this menu would be great.

thias15, 2022-05-11:
@sanyatuning what would actually be great is:
(1) Add an option to redo matching for datasets to the dropdown. This can be used if users added data manually.
(2) Run redo matching when dataset is moved since the file paths in the metadata won't be correct anymore. Running the matching code again will also updated the filepath for each data sample.

thias15, 2022-10-13:
Hi @sanyatuning. Just wanted to follow up if you would still be interested to work on this?

Thread 252 (2022-01-27):

broken link

omer-re, 2022-01-27:
**Describe the bug**
the links to
```
You will also need a phone mount. Here is one option:

    Mpow Dashboard Car Phone Mount (EU, US)
```

on [Build your own](https://github.com/isl-org/OpenBot/blob/master/body/README.md)
are not available.
I tried searching for a new page of the same product but couldn't find any.

However, the 3d printed one is amazingly good.

omer-re, 2022-01-27:
found this product that might be a nice fit

https://www.banggood.com/Ulanzi-ST-06S-Phone-Clip-with-Two-Cold-Shoe-Vertical-Shooting-Smartphone-Clamp-Mount-Holder-Tripod-Mount-DSLR-Camera-Mount-for-Vlog-Live-Bro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

Closed 2022-02-16.

Thread 268 (2022-03-22):

openbot functionalities

robotixdevteam, 2022-03-22:
Today, controller app has crashed which has been downloaded from QR code. previously app is working we have faced bluetooth connection stability issues, is there any update for this issues???

thias15, 2022-03-22:
Can you please provide further details. @izivkov can you help @robotixdevteam to figure out a solution?

robotixdevteam, 2022-03-23:
sorry, now we have removed all the previous apps and installed new ones again now. They are installed.
But now we are facing mobiles are not getting connected to each other?

izivkov, 2022-03-23:
If you are talking about the controller phone not connecting to the robot
phone: make sure both phones are on the same LAN, not using data
connection. Make sure they are using the same router, i.e. not on a
University WiFi network, or something like that. Then try a few times,
sometimes they don't connect the first time.

If still doesn't work, please provide more information on what is going on
and your setup.

Thanks

On Wed, Mar 23, 2022, 12:23 AM robotixdevteam ***@***.***>
wrote:

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

robotixdevteam, 2022-03-23:
These are the steps we followed for connecting the mobiles.
connected the mobile to bot and open the apps in the mobile and change the control in viewer app to phone and have wait for some time. one more thing we connected the mobiles to same wifi connection. We have tried this many times still they are connected. I want to know whether the procedure for connecting is right or we are missing something to change?

robotixdevteam, 2022-03-23:
hi, another thing i would like to know is why you are using the arduino 33 iot, as the mobile has both wifi and bluetooth?

izivkov, 2022-03-23:
Ok, looks like you are doing the right steps, but also try the following:

1. Restart the Controller App on the right phone each time you are trying to connect
2. On the Main software, switch control between Gamepad and Phone a few times, The connection is getting initiated when the "Phone" control mode is selected.
3. Also, from the main screen, selected "Free Form" icon, and then switch the "Controller" icon (bottom left button) a few times.

Hope this helps

izivkov, 2022-03-23:
https://user-images.githubusercontent.com/4115966/159732255-eadd8d57-75c6-4a7a-ba94-0a46891d1a87.mp4

robotixdevteam, 2022-03-24:
is the phones are connected using the wifi or bluetooth?

thias15, 2022-03-28:
> ng about the controller phone not connecting to the robot phone: make sure both phones are on the same LAN, not using data connection. Make sure they are using the same router, i.e. not on a University WiFi network, or something like that. Then try a few times, sometimes they don't connect the first time.

This is just since the Arduino 33 IOT can be used also for other things. But it can work with Arduino Nano as well.

thias15, 2022-03-28:
There should not be a specific requirement for which phones can be used, but we did not test with the phones you mentioned above. You closed the issue, so I just wanted to check if the issue is resolved now from your end?

robotixdevteam, 2022-03-28:
No, the issue was not solved we are trying to understand where exactly is the problem if you have any ideas on how to solve it share with us?

robotixdevteam, 2022-03-28:
we wanted to open a new issue regarding it so we closed it

izivkov, 2022-03-28:
As I discussed with @robotixdevteam team last week, the problem seems to occur in only one of the phones: Redme. Since we cannot test all phones, we need to work together with the team on this issue. Maybe the team can provide some logs from this phone, to see if there are any crashes or what the problem is.

robotixdevteam, 2022-03-30:
we tested the node-js .while testing node-js, we came across certain issue of connectivity with some windows laptops. It is working good with raspberry pi and ubuntu os. currently, Have you tested the node-js with windows laptops. Right now, we are testing the python controller. Oh yes, i forgot to mention the main issue connectivity among two mobile phones that issue has not been solved from our side. Is there any updates regarding it.

robotixdevteam, 2022-03-30:
we tested the python code. some windows laptops there is connectivity issue and rest even though it is connected and popup-dialogue can  be seen but the video is not streaming through both RTSP and WEBRTC. We have not tested the python code as well as node-js in real time.

izivkov, 2022-03-30:
> we tested the python code. some windows laptops there is connectivity issue and rest even though it is connected and popup-dialogue can be seen but the video is not streaming through both RTSP and WEBRTC. We have not tested the python code as well as node-js in real time.

The Python controller works with RTSP video only.
Check and disable any firewall and virus protection on your Windows machines, maybe this will help.
The NodeJS and Python controllers have been developed on and for Linux-based OS's so far. It would be great if we can get them working on Windows, though.

robotixdevteam, 2022-03-31:
Prevously it connected to windows without video streaming but after disabling the protection and firewall it is not even getting connected.

thias15, 2022-04-28:
Any update on this?

izivkov, 2022-04-29:
This looks more like a configuration or a firewall issue. I think the same software works on some systems, but not on others. The Python controller was tested on Linux, and I left is as a "TO DO" to test on Windows, and recommend configuration. As of now, we cannot say that the Python controller is tested or supported on Windows. Since I am not running Windows on any of my machines, somebody can test it and let us know.

Closed 2022-04-29.

Thread 270 (2022-03-30):

Upload error on arduino IDE

jony-g06, 2022-03-30:
I just downloaded the firmware file to my computer in order to get the code for the openbot and, after checking it, it gives an error on line 238 that says "'coast_mode' does not name a type", even though it is defined as a boolean on line 62 with a value of 1. What can I do to fix the error?

thias15, 2022-03-30:
Which vehicle are you trying to compile for?

jony-g06, 2022-03-31:
>

The openbot that appears on the website

quentin-leboutet, 2022-03-31:
Hi jony-g06,
did you try moving the line 238 inside the **void setup()** scope ?  Something like:

```
void setup()
{
...
#if (OPENBOT == LITE)
  coast_mode = !coast_mode;
#endif
}
```
This solves the issue in my case.

thias15, 2022-03-31:
Thanks @quentin-leboutet, I merged your PR. @jony-g06 can you pull again from master and try if it works for you?

Closed 2022-03-31.

Thread 274 (2022-04-05):

Openbot hardware

robotixdevteam, 2022-04-05:
Hi, We have used Arduino nano in our project with the old boot loader we cannot able to make it work in sense we are not able to replicate some of the functionalities of the openbot but we can make it work with Arduino uno.

thias15, 2022-04-05:
We have used the Arduino Nano with old Bootloader for all experiments. What does not work for you?

robotixdevteam, 2022-04-06:
The nano with old bootloader is not responding with the phone. can you help us through this?

robotixdevteam, 2022-04-12:
Sorry, For now we are going ahead with the uno board which is working for us

Closed 2022-04-22.

Thread 275 (2022-04-06):

why openbot app is not supported all other android versions?

Srini4063, 2022-04-06:
**Describe the problem**
A clear and concise description of what the problem is or what information you are looking for.

**To Reproduce**
Steps to reproduce the behavior:
1. Go to '...'
2. Click on '....'
3. Scroll down to '....'
4. See error

**Expected behavior**
A clear and concise description of what you expected to happen.

**Screenshots**
If applicable, add screenshots to help explain your problem.

**Desktop (please complete the following information):**
 - OS: [e.g. Windows, Linux, iOS]
 - Browser [e.g. chrome, safari]
 - Version [e.g. 22]

**Smartphone (please complete the following information):**
 - Device: [e.g. Samsung S20]
 - OS: [e.g. Android 11]
 - Browser [e.g. stock browser, chrome]
 - Version [e.g. 0.1.1, master]

**Additional context**
Add any other context about the problem here.

Srini4063, 2022-04-06:
why  openbot was not supported all other android version ?

thias15, 2022-04-06:
What do you mean?

Srini4063, 2022-04-06:
Other android phones are not communicated well what can I do?

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

quentin-leboutet, 2022-04-07:
Hi [Srini4063](https://github.com/Srini4063), could you give us more details about the problem you are currently experiencing? To be able to support you, we need to understand the context in which you encountered this issue, so that we can reproduce it. For instance, which version of Android are you using? What is your operating system? What is your version of Android Studio? What is the observed behavior? Which protocol did you follow to get this behavior? Which features seem to be affected? Do you have any error messages? This is really important.

thias15, 2022-04-22:
Closing due to inactivity.

Closed 2022-04-22.

Thread 284 (2022-05-05):

video stream error

alstjr510, 2022-05-05:
**Describe the problem**
A clear and concise description of what the problem is or what information you are looking for.
It connects when I run (python keyboard-pygame.py --video), but the video doesn't come out of my laptop!

Can't read stream is an error message when running ( python keyboard-pygame.py --video)

I want to know the camera address information of the cell phone connected to the open bot.(On Openbot Application)

**To Reproduce**
Steps to reproduce the behavior:
1.conda activate [your env]
2.cd Openbot
3.cd controller
4.cd python
5. python keyboard-pygame.py --video

**Expected behavior**
A clear and concise description of what you expected to happen:
I can see the video of the cell phone camera connected to the open-bot app on my laptop.

**Screenshots**
If applicable, add screenshots to help explain your [problem.]

**Desktop (please complete the following information):**
 - OS: Linux
 - Browser :  chrome
 - Version 18.04

**Smartphone (please complete the following information):**
 - Device: Samsung S10
 - OS: Android 12
 - Browser :chrome
 - Version : I didn't understand what version you were talking about.

**Additional context**
Add any other context about the problem here.

thias15, 2022-05-05:
Did you choose RTSP in the settings of the OpenBot app?

alstjr510, 2022-05-05:
> Did you choose RTSP in the settings of the OpenBot app?

Yes, I know that there are WebRTC and RTSP in Stream mode. And I set it to RTSP.

thias15, 2022-05-11:
@izivkov any ideas?

alstjr510, 2022-05-23:
Hello! I'm working on your open-bot project. There is one question.
Even if I update the app, Point Goal Navigation is not on the interface, but hasn't the function been added yet?

alstjr510, 2022-10-11:
Yes, I know that there are WebRTC and RTSP in Stream mode. And I set it to RTSP.
-----Original Message-----
From: ***@***.***>
To: ***@***.***>;
Cc: ***@***.***>; ***@***.***>;
Sent: 2022-05-05 (목) 15:08:25 (GMT+09:00)
Subject: Re: [isl-org/OpenBot] video stream error (Issue #284)

Did you choose RTSP in the settings of the OpenBot app?
—
Reply to this email directly, view it on GitHub, or unsubscribe.
You are receiving this because you authored the thread.Message ID: ***@***.***>

Closed 2022-06-02.

Thread 287 (2022-06-30):

Current step show Failed

emo8899, 2022-06-30:
**Describe the problem**
Current step show Failed after Current epoch(100%)&Training(100%)

**To Reproduce**
Steps to reproduce the behavior:
1. uploaded the training sources.
2. Move the training sources to Train datasets.
3. Go to Train and click the start(Use the default Settings.)
4. See error

**Expected behavior**
Current step show Pass

**Screenshots**
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

**Desktop (please complete the following information):**
 - OS: [MACOS(10.15.7 (19H1715))]
 - Browser [Edge]
 - Version [ 103.0.1264.37]

**Smartphone (please complete the following information):**
 - Device: [Huawei nova7 SE 5G]
 - OS: [Android 11]
 - Browser [n/a]
 - Version [0.6.0-openbot-master]

**Additional context**

emo8899, 2022-07-01:
> How many epoch are you running.
10times
Which version of tensorflow are you using?
tensorflow-2.9.1

emo8899, 2022-07-01:
I try to set num epoch 50, error look the same.
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

thias15, 2022-07-19:
Can you try to replace `val_mean_absolute_error` with `val_mae`. It seems the name was changed. Alternatively, you could try an older version of tensorflow, e.g. 2.6.0.

emo8899, 2022-07-19:
replace val_mean_absolute_error with val_mae not working, but I can successfully train using the method of a YouTube writer. It doesn't require your computer to have a lot of processing power, it uses Google Cloud computing to process data very quickly.  FYI!  https://www.youtube.com/watch?v=JMKPMcqvYKo

thias15, 2022-07-26:
Any update on this @emo8899 ?

emo8899, 2022-07-27:
i used the google driver to training robot, it's looks good.   a man who is a youtube author used Google Cloud computers to train the robots.

thias15, 2022-10-13:
So did you manage to resolve the error?

thias15, 2022-10-13:
@emo8899 it seems that this was resolved by using the Colab notebook. Is that correct? Will close for now, feel free to reopen if the issue persists.

Closed 2022-10-13.

Thread 290 (2022-07-25):

Do you plan to support multicopters?

atolkachiov, 2022-07-25:
As far as I understand, there are plenty of pros to use smartphones as onboard computer for multicopters, for starters at least.
* sensors to maintain stable flight
* independent power source
* 4g connectivity
* ML-grade performance
* great price
* availability (which is often a blocker if you are going to make a build using some SBCs)

Do you have it on your roadmap? Looking for contributors?

thias15, 2022-07-26:
Hi @atolkachiov. We have considered it before, but there were a few concerns.
(1) People may be more hesitant to put their phone on a flying platform
(2) On quadrotors weight is a major concern and phones have quite a bit of extra weight due to battery, screen and chassis
(3) Integration of a full flight control stack in Android requires a lot of work

As a result the first priority has been ground vehicles. That being said, contributions would be most welcome.

atolkachiov, 2022-07-27:
Probably it would be easier to rely on Ardupilot compatible SoC as a flight controller and have smartphone as an auxiliary [companion computer](https://ardupilot.org/dev/docs/companion-computers.html) module focused on ML tasks and autonomous flight. As Ardupilot supports Odroid boards which run Android, adding multirotors supports may essentially be introducing MAVLink protocol bridge API available for the user app.

I understand all the concerns, but professional turnkey solutions cost a fortune and even then often they are not available because of chip shortage. Having some extra weight onboard sounds like an acceptable tradeoff If you can get powerful GPU + quality cameras + lidar + cellular connectivity for a few hundreds dollars. Good for learning and prototyping.

thias15, 2022-10-13:
Hi @atolkachiov. I'm closing this for now since this is not a high priority on our roadmap and we have very limited bandwidth. However, if you would be interested to work on this we would be happy to support as much as we can!

Closed 2022-10-13.

Thread 293 (2022-08-29):

firmware

mjanddy, 2022-08-29:
when I upload the firmware,it is error which that is some fuction is declared after. How should I fix it?
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

quentin-leboutet, 2022-08-29:
Hello mjanddy,

thank you for using OpenBot !
Could you give us more information about the context in which you encounter this error so that we can reproduce it ?
For instance, on which board are you trying to flash this code ?
Did you modify the firmware ? In which way ?

Thank you

Quentin

quentin-leboutet, 2022-08-30:
Strange... I cannot reproduce your bug. Are you using the last IDE version ? What are your exact settings ?

mjanddy, 2022-08-30:
> Strange... I cannot reproduce your bug. Are you using the last IDE version ? What are your exact settings ?

I use arduion ide 1.8.19; just as  github setting

mjanddy, 2022-08-30:
> > Strange... I cannot reproduce your bug. Are you using the last IDE version ? What are your exact settings ?
>
> I use arduion ide 1.8.19; just as github setting

> Strange... I cannot reproduce your bug. Are you using the last IDE version ? What are your exact settings ?

 and now  I moved the position of the function, but I'm not sure if it's correc

quentin-leboutet, 2022-08-30:
Did you try compiling the firmware using the Arduino [cloud IDE](https://create.arduino.cc) ?

mjanddy, 2022-08-30:
> the Arduino [cloud IDE](https://create.arduino.cc/editor) ?

ok,I will try it ,thanks!

mjanddy, 2022-08-30:
> Did you try compiling the firmware using the Arduino [cloud IDE](https://create.arduino.cc/editor) ?

It is ok,thank you!

Closed 2022-08-30.

Thread 294 (2022-09-06):

IOS support,

thebigboss84, 2022-09-06:
The documentations refers to IOS support is coming soon , do you have a timeline for this to come ?

Thanks ,

quentin-leboutet, 2022-09-07:
Hello Aboude ,

A prototype of the OpenBot app is indeed being developed and should be released to the public in a couple of months (probably in around 2-3 months).

Regards

Quentin

thebigboss84, 2022-09-08:
Well great news ! If you need a beta tester my car is built and ready to accept phone 😅

thias15, 2022-10-13:
@thebigboss84 are you on Slack? We will announce the release there and ask for beta testers.

Closed 2022-10-13.

Thread 295 (2022-10-13):

Where precisely is ESP32 being used in the DIY bot ?

mugdhapendse, 2022-10-13:
I am unable to see ESP32 in the wiring diagram of DIY bot.
So, when should the steps mentioned in the ESP32 be implemented ? Is it an alternative to arduino nano ?

mugdhapendse, 2022-10-14:
Alright, understood. A couple more questions though :

1] For the current DIY version, are we not enabling bluetooth and wifi feature ? What is the exact purpose of these features ?

2] In the overall project,  we need only 1 smartphone to be mounted on the bot, right ?

mugdhapendse, 2022-10-14:
@thias15 Could you assign this to me ?

I would firstly like to contribute to the the documentation of "Arduino Firmware" that the ESP32 kit is only for the RTR version to avoid any further confusion of other users.

I also plan on using only ESP32 in the DIY version and sharing the project here eventually.

Do let me know if this is possible.

thias15, 2022-11-29:
@mugdhapendse your contributions will be most welcome. The BT on the ESP will allow wireless connection between microcontroller and Smartphone App (WIP). Having WiFi on the ESP32 is a bonus that can enable further applications in the future, e.g. send commands over network without a phone.

marshalab, 2024-11-22:
[openbot_sch.xlsx](https://github.com/user-attachments/files/17873453/openbot_sch.xlsx)
Hello/ I am collect some data from source in the table. This is may help you.

In my research version, I want to use the M5stask Lego modules that have been lying in a drawer for a long time. This should make a great build for experimentation. Already found two NXT motors with built-in encoders, smartphone. Now it is necessary to establish order and find the module itself esp32 m5stask.

Thread 307 (2022-11-15):

Add a pipeline to train yolov5 object-detection model on custom data

mnrozhkov, 2022-11-15:
**Is your feature request related to a problem? Please describe.**
Sometimes users may want to train a custom object-detection model with YoloV5 and use it in the OpenBot.
To make it simple, we may provide a pipeline to collect/annotate/train/deploy model to the robot.
This request is focusing of the model training pipeline.

**Describe the solution you'd like**
Proposed solution utilizes DVC to run end-to-end YoloV5 model training in Docker
- DVC pipeline (`dvc.yaml) has three stages: download_model, train, val and exports
  - download_model: download pre-train model
  - train: train a model
  - val: run validation checks
  - exports: export models into required formats
- the pipeline configuration is in `params.yaml` file

DVC allows to automate model training & validation. With DVC remote storage setup, user may store models in local or cloud storages. Using DVC users may switch between different experiments and model versions

Prototype: https://github.com/mnrozhkov/OpenBot/tree/dev-object-detection (in progress)

**Describe alternatives you've considered**
1. There are two alternatives on YoloV5 dev environment setup: using virtual environment or Docker.
Docker looks more appealing because it make environment setup simple and reproducible. Also, it's easier to control location of output artefacts (models, plots...)

2. The pipeline can be moved into a separate repository. It may be easier to experiment and share models.

**Additional context**

Next steps/ideas:
- add a pipeline to prepare/link custom dataset (share dataset?)
- add CI configuration to run model training in Cloud
- add Model Registry (to make it easy to plug and play with different models)

thias15, 2022-11-16:
This looks great @mnrozhkov. Looking forward to a PR in the future.

Thread 320 (2022-12-21):

Bot react on voice commands ?

reger24, 2022-12-21:
Hi @thias15 ,

**would you accept a pull request for implementing of a voice recognition feature** into the android app, so bot can react on voice commands or is that out of scope **?**

**Describe**
The idea is, to use the ML example ("[TensorFlow Lite Speech Command Recognition Android Demo](https://github.com/tensorflow/examples/tree/189c662d500c20b9f9e93fef0af97d5311e64377/lite/examples/speech_commands/android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)") which can recognize (out-of-the-box) "yes, no, up, down, left, right, on, off, stop, go" as a starting point.
I'd implement it in a way that it can be activated (or is active) in the auto-modes so the user can interfere with the controls by a voice command e.g. "stop" to overwrite/correct bot steering/speeds to perform a emergency stop or to have the bot rotate to find the object for tracking etc......
My preference would be to implement it as service so it can be used (activated) from/for any activity.

reger24, 2022-12-21:
OK, then I'll start coding.
cu

izivkov, 2022-12-21:
@reger24 How do you plan to do it? Would it be part of the main app or would it reside on another device, acting as a controller? I think both are valid options, but if it is separate phone, you don't have to shout at the robot. ;-)

reger24, 2022-12-21:
@izivkov My plan is to make it part of the main app (so you would need to shout at the robot) !
Was also thinking about it as feature or replacement for the phonecontroller, but discarded the idea,
because my interest is to have a way to influence the robot mainly during auto-modes, not to replace the joystick.

izivkov, 2022-12-21:
👍

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

reger24, 2022-12-23:
fyi: progress can be viewed in clone branch https://github.com/reger24/OpenBot/tree/VoiceRecognition

(as it may take some days and commits before ready for a pull request).

reger24, 2022-12-27:
fyi: first testing went not very well,
due to the (higher as expected) negative effect of noise level from bot motors.
After a start command barely any following voice command is recognized.
've to see if I find a tweak to overcome this hurdle.

izivkov, 2022-12-27:
I'm also not sure about the latency. I have no experience with how fast
voice commands are interpreted, but I imagine there would be some delay in
processing them. Having worked on the various remote controllers for the
bot, I know repeated steering commands need to be sent in fast succession
for good performance. But don't let me discourage your development. I think
it would be a great feature if we can implement it.

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

reger24, 2022-12-27:
@izivkov Thanks for your hint and encouragement,
but the issue during first testing was/is the background noise the motors make while driving and the voice recognition apparently too sensitive to background noise/sounds so the recognition itself doesn't work well as it does in quiet environment (with the given neural network).
Currently I see still some options to try, 've to see if it improves it enough for an acceptable workaround.

reger24, 2023-02-08:
### fyi - giving up on unsolved motor noise problem - for a direct robot app voice recognition

The noise from robot's motors is a bigger problem as anticipated,
because the microphone is very close to the motors, so that this noise dominates the recording.
The motor noise is as loud as the voice if one shouts at the robot from close distance.

I experimented with different noise filters to eliminate/reduce the motor noise without success,
as the frequencies overlap with the voice command frequencies, with the result that recording quality is not high enough for recognition.

Tried filters are
- lowpass, highpass, bandpass/-reject filter from [marytts.signalproc.filter](https://github.com/marytts/marytts/tree/master/marytts-signalproc/src/main/java/marytts/signalproc/filter)
- and [rnnoise4j library](https://github.com/henkelmax/rnnoise4j) (w/o specific training data)
as said without success.

I end up with last option, using voice recognition only if robot doesn't move or via a distant microphone.
Both not intended (by me) at this time for the small command set that comes with the used voice recognition sample ,
so I'll stop working on this feature for now.

thias15, 2023-02-08:
Hi @reger24 that's too bad. How about connecting a BT headset to the phone? Then you can just talk into the microphone and will avoid all of these noise issues.

reger24, 2023-02-09:
Now, as I found the manual of my BT headset how to bring it in pairing mode to connect to robot's phone,
I'll give it a try with your suggestion (and see if I can get far enough away from the crying motors ;-)

reger24, 2023-02-10:
Hi @thias15,   short feedback on your input:
first rudimentary testing shows the suggested BT headset workaround could work. at least voice commands where recognized (not all the time but much better as before),
so worsewhile to spend a bit more time for further testing and tuning.
cu

thias15, 2023-02-11:
If you are standing a few meters away and microphone is close to your face it should be fine. Another option is to use a different motor, for example the 520. It makes less noise.

Closed 2023-02-08.

Thread 324 (2022-12-24):

Android app communicated via Bluetooth with the on-board microcontroller

RoachWZ, 2022-12-24:
**Is your feature request related to a problem? Please describe.**
Mobile phone data cable connection is not beautiful, you can add a Bluetooth module, use mobile phone Bluetooth connection it.

**Describe the solution you'd like**
Android app communicated via Bluetooth with the on-board microcontroller, drove the motors and parsed data from the sensors.

**Describe alternatives you've considered**
Bluetooth protocol uses SPP.

**Additional context**
It looks something like these
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

RoachWZ, 2022-12-26:
Use  Bluetooth connection can charge phone right on the robot #118

RoachWZ, 2022-12-26:
Oh, I don't have a Bluetooth handle. I haven't considered the Bluetooth handle control. I haven't verified that the mobile phone Bluetooth is connected to the car and the handle at the same time.

RoachWZ, 2022-12-26:
I read the source code. There is a code for connecting the mobile phone. Connecting the code with the handle is to disconnect the mobile phone, which is a bit confusing.
`      switch (controlMode) {
        case GAMEPAD:
          binding.controllerContainer.controlMode.setImageResource(R.drawable.ic_controller);
          disconnectPhoneController();
          break;
        case PHONE:
          binding.controllerContainer.controlMode.setImageResource(R.drawable.ic_phone);
          if (!PermissionUtils.hasControllerPermissions(requireActivity()))
            requestPermissionLauncher.launch(Constants.PERMISSIONS_CONTROLLER);
          else connectPhoneController();
          break;
      }`

RoachWZ, 2022-12-26:
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

I seem to understand. Connect to the phone like a keyboard.

Thread 336 (2023-02-14):

[DIY] Nano board freeze and stop accepting commands after starting the motor with c command.

shashank734, 2023-02-14:
Hey Folks, Building DIY and Connected the Arduino nano with the studio, Uploaded the firmware it's connected and showed the data on OLED and serial monitor both. when I send the i0,1, i1,0 ... commands, it's working fine.

But when I send the c command motor starts, but OLED turns off, and it stops sending the data on the serial monitor, it stops accepting the commands need to unplug the USB and insert it again to stop the motor. Turn on/off the power switch without removing the USB. still, motor starts and not accepting commands to make it work need to remove the USB. I think the board freezes after sending motor commands. Tried with Not connected to the phone yet.

The same is happening with the phone App; after starting the motor, no other commands working need to reconnect.

PS: I observe with the phone it was accepting the instructions when the motor was at a slow speed once the motor is at high-speed everything gets freeze.

Using this board https://robu.in/product/arduino-nano-board-r3-ch340-chip-with-usb-cable-solderedarduino-nano-r3-usb-cable/

Thanks for great project :)

thias15, 2023-02-14:
Hi @shashank734. It sounds like the electric noise of the motors might be causing interference. Can you try to shield the USB cable and keep it as far as possible from the motor wires? Another reason could be a faulty board (but then it's weird why it works for low motor speeds), especially the cheap Arduino clones are not always reliable.

shashank734, 2023-02-16:
Hi @thias15, Thanks for the response will try this on the weekend and update here. Actually, it's only sometimes working at a slow speed; it worked only a few times for a few seconds than stuck.

shashank734, 2023-02-19:
Hey tried to put Arduino at distance from the motor, and then it works but after some time again freezes. Maybe an issue with Arduino but don't know why it's working sometimes by putting it at a distance.

thias15, 2023-03-03:
Hard to debug remotely. Would recommend trying a new/different Arduino board.

Thread 340 (2023-03-05):

Run Object Tracking mode on server / Run Object Tracking mode on prefilmed video instead of camera

RoBoFAU, 2023-03-05:
Hello everybody,

I have two questions for the Object Tracking mode:

my first question:
is it possible to evaluate the camera recordings on a computer/server instead of on the smartphone?
that means the input for the neural network comes from the smartphone, the object detection runs externally on the server and the output of the evaluation is also sent back to the smartphone. I have read that the mode Autopilot and FreeRoam works with a computer, however in this case the car is controlled by the computer. In case of object detection the car should drive itself, only the object detection runs externally on the server.

the second question:
is it possible to use a pre-recorded video instead of the "live" camera to test the object recognition via the app. Of course, then it makes no sense to let the car drive. The point here is just to illustrate the performance of the pre-trained network.

thias15, 2023-03-05:
For running on a video, it should be easy enough to write a python script to load one of the detection models and then feed images through. Sending video to a computer and controls back to the robot is already supported. What's missing is to run the network on the server to predict the controls.

If you just want to test with Yolov5 with videos you can directly use the [provided script](https://github.com/ultralytics/yolov5#documentation). It works with images, videos, etc.

RoBoFAU, 2023-03-05:
For running on a video, it should be easy enough to write a python script to load one of the detection models and then feed images through. Sending video to a computer and controls back to the robot is already supported. What's missing is to run the network on the server to predict the controls.
**you mean this part, right? or the node.js data? https://github.com/isl-org/OpenBot/tree/master/controller/python**

If you just want to test with Yolov5 with videos you can directly use the [provided script](https://github.com/ultralytics/yolov5#documentation) - check section Inference with detect.py. It works with images, videos, etc.
**- Yes, I know. But there is a difference running the script on the computer instead of using the OpenBot App with this neural network...**

RoBoFAU, 2023-03-06:
I did everything to set up the python controller.
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

But now, it is waiting for connection and doesn't connect in minutes.
Phone and Laptop are connected to the same network (external hotspot from a second phone)

Both, with and without --video do not work.

Any idea what the problem is?
Do I have to install something else than the requirements.txt so "show" the incoming video from the roboter app?

khoatranrb, 2023-04-19:
>

Did you fix it?

sanjeevitinker, 2023-09-19:
Hello @khoatranrb @RoBoFAU ,

I'm glad to hear that the issue has been resolved!

For anyone who encounters the same problem, please note that the issue has been addressed and fixed in Issue #351 (Python controller cannot connect). The solution involves updating the Python code to use port 8081 instead of 19400, ensuring it matches the port configuration in the OpenBot Robot App.

You can find more details and the fixed code in this link: [Issue #351](https://github.com/isl-org/OpenBot/issues/351#issuecomment-1723239666).

Thread 341 (2023-03-23):

Build an expanded version of the DIY version available for most popular 3D printers

Christos-Ps, 2023-03-23:
Since i build my first DIY Openbot this week using the published 3d stl files (https://github.com/isl-org/OpenBot/tree/master/body/diy/cad), i realized that the following problems could be adressed:

1. Most popular 3D printers (like the Ender 3 i used) have a usable print area of 220 x 220 mm. However, the size of the build surface actually measures 235 x 235 mm which can be used for the "Slim_Body" only version. Unfortunately the "Slim_Body" version lacks the most valuable bumpers that the "Regular_Body" provides.
3. More over I am afraid that the available space inside the DIY version of the bot is very limited, resulting in:

- cabling difficulty
- preventing any hardware future expansion connectivity, since even if you decide to use extra sensors there is no space inside the shell
- assembly difficulty, especially when you need to need to fix connectors that were removed due to cable stress on assembly

As a result:
I have redesigned the bottom and top stl trying to get the best of both worlds, since i would like to avoid the "glued" version for structural integrity reasons.
What i did was the following:

1. I used the "Regular_Body" version as a template
2. I replaced the back bumper with a slim one
3. I reduced the wheelbase to bumper dimension
4. I created a top cover height towards the half of the openbot, resulting to almost double height from center to back.
5. As an extra cherry to the pie (after my kids request) i created an extra version with lego combatible bricks patch on top of the back to be able to let them play & learn robotics.

I am attaching some screenshots if you like it and also agree that it could help others!
On the next step i will upload the stl files according to your guidelines
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

Best regards
Christos

Christos-Ps, 2023-03-23:
Hi @thias15

I have uploaded all stl+readme file in Pull request #342 and i closed the request
https://github.com/isl-org/OpenBot/pull/342
Please let me know if i missed any step needed for the folder creation

Cheers!

Christos-Ps, 2023-03-27:
Hi @thias15
Is the #342 working for you, or i shouldn't have closed it prior to review?

Cheers

Closed 2023-04-06.

Thread 354 (2023-04-26):

Unpowered arduino nano

rfedersp, 2023-04-26:
Hi, I'm a total beginner in electronics and I'm trying to build the DIY version of OpenBot (which is a great project!). The problem is that I can't power the Arduino Nano with the voltage divider bridge... Is my assembly wrong?

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

thias15, 2023-04-26:
Hard to tell from the image but looks roughly ok. Can you measure the voltage with a multimeter? Note that if you built the voltage divider as per instructions and connected it to the corresponding pins the purpose is not to power the Arduino but to measure the battery voltage. The Arduino is powered via the USB connection to the phone.

rfedersp, 2023-04-27:
I measure a voltage of 0.6 but it must be normal if it is not intended to power the arduino.
On the other hand, when I connect my phone to the arduino, no led lights up, is that normal?

rfedersp, 2023-04-27:
The problem was with my OTG cable... Everything works now!
Thank you for your help :)

Closed 2023-04-27.

Thread 355 (2023-04-29):

Unable to compile when DIY_ESP32 is selected

thebigboss84, 2023-04-29:
I get this error redefinition ‘ CH_PWM_L1’
Other robots like RTR compiled just fine .

thias15, 2023-04-29:
Thanks. Sounds like a bug. We will look into it.

thias15, 2023-04-29:
Should be fixed now.

Closed 2023-04-29.

Thread 357 (2023-05-04):

NodeMCU ESP32s

lechfak, 2023-05-04:
Hello.
I want to make DİY_ESP32 with NodeMCU ESP32s.
I used L298 as motor driver.

Where should I connect the CH_PWM_L1/ L2/R1/R2 and PIN_PWM_LF1/LB1... pins? I don't understand this.
When CH_PWM_L1 remains as is, all engines are running in NO_PHONE mode only. But none of them work in normal mode.

When I do the same with CH_PWM_... and PIN_PWM_.LF/LB.., only the motors on the left respond to commands.
//PWM properties
const int FREQ = 5000;
const int RES = 8;
const int CH_PWM_L1 =13;
const int CH_PWM_L2 = 12;
const int CH_PWM_R1 = 27;
const int CH_PWM_R2 = 33
const int PIN_PWM_LF1 = 13;
const int PIN_PWM_LF2 = 12;
const int PIN_PWM_LB1 = 13;
const int PIN_PWM_LB2 = 12;
const int PIN_PWM_RF1 = 27;
const int PIN_PWM_RF2 = 33;
const int PIN_PWM_RB1 = 27;
const int PIN_PWM_RB2 = 33;

What can I do?

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

thias15, 2023-05-04:
Please use the latest firmware. The `CH_PWM` can just have values 0,1,2,3. The physical GPIO pins are defined as `PIN_PWM_LF1`, `PIN_PWM_LB1`, etc. Note that LF (left front) and LB (left back) are defined as the same pin since we only have two outputs - one for the left side and the other for the right side. You should connect pins 13 and 12 to IN1 and IN2 to control the left side and pins 27 and 33 to IN3 and IN4 to control the right side.

thias15, 2023-05-04:
If it works in the No_PHONE mode, it means that the wiring is correct. It seems the issue you are facing is with the connection between robot and phone then. Did you try to send commands from the serial monitor in Arduino? Does the robot info screen work when the robot is connected?

lechfak, 2023-05-05:
Hi.
1.  yes. i try to send commands from the serial monitor in Arduino. wıth c255,255. but there is no change
2. robot info screen dont work when the robot is connected
![WhatsApp Image 2023-05-05 at 14 41 33 (1)](https://user-images.githubuserconten
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
t.com/24843137/236449220-bd0543d9-e887-4c8c-8ffc-2f94f8914491.jpeg)
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

lechfak, 2023-05-09:
Hi.
I was able to connect to the device using bluetooth connection.
It didn't happen with the USB cable at the same settings.
The robot info screen has seen the device.
but after working for a few seconds, the device turns itself off by giving this error:

Guru Meditation Error: Core  1 panic'ed (InstrFetchProhibited). Exception was unhandled.
Core 1 register dump:
PC      : 0x00000000  PS      : 0x00060130  A0      : 0x800d14e9  A1      : 0x3ffcafc0
A2      : 0x3ffc45f8  A3      : 0x00000000  A4      : 0x0000aeb4  A5      : 0x0000da80
A6      : 0x00000020  A7      : 0x3ffc90e0  A8      : 0x800d6caf  A9      : 0x3ffcafa0
A10     : 0x3ffc45f8  A11     : 0x3ffba660  A12     : 0x00000005  A13     : 0x00000005
A14     : 0x00000003  A15     : 0x00060023  SAR     : 0x0000000a  EXCCAUSE: 0x00000014
EXCVADDR: 0x00000000  LBEG    : 0x4000c28c  LEND    : 0x4000c296  LCOUNT  : 0x00000000

ELF file SHA256: 0000000000000000

Backtrace: 0x00000000:0x3ffcafc0 0x400d14e6:0x3ffcafe0 0x400d1586:0x3ffcb000 0x400d860c:0x3ffcb020 0x400905de:0x3ffcb040

Rebooting...
ets Jun  8 2016 00:22:57

rst:0xc (SW_CPU_RESET),boot:0x13 (SPI_FAST_FLASH_BOOT)
configsip: 0, SPIWP:0xee
clk_drv:0x00,q_drv:0x00,d_drv:0x00,cs0_drv:0x00,hd_drv:0x00,wp_drv:0x00
mode:DIO, clock div:1
load:0x3fff0018,len:4
load:0x3fff001c,len:1216
ho 0 tail 12 room 4
load:0x40078000,len:10944
load:0x40080400,len:6388
entry 0x400806b4

hardikgarg02, 2023-09-15:
Hey! Which Android device have you used for connecting to the robot? If connecting via USB and the serial monitor is not sending commands to the robot, try using a different device for the connection.

hemangjoshi37a, 2024-10-14:
I am using the defualt firmware file and getting this error in my esp32 devkit v1 :
```
17:29:17.656 -> rst:0x8 (TG1WDT_SYS_RESET),boot:0x13 (SPI_FAST_FLASH_BOOT)
17:29:17.656 -> configsip: 0, SPIWP:0xee
17:29:17.656 -> clk_drv:0x00,q_drv:0x00,d_drv:0x00,cs0_drv:0x00,hd_drv:0x00,wp_drv:0x00
17:29:17.656 -> mode:DIO, clock div:1
17:29:17.656 -> load:0x3fff0030,len:4832
17:29:17.656 -> load:0x40078000,len:16460
17:29:17.656 -> load:0x40080400,len:4
17:29:17.656 -> load:0x40080404,len:3504
17:29:17.656 -> entry 0x400805cc
17:29:18.399 -> ets Jul 29 2019 12:21:46
```

Thread 377 (2023-10-20):

Unable to Connect Android App Openbot to Controller App

A-janjan, 2023-10-20:
I have encountered an issue where the Openbot app is unable to connect to the Controller app. I have installed both of them and connected them to the same network, but they aren't connected to each other. Additionally, I have changed the controller type to phone.

What should I do?

Is there any log?

Eashika2504, 2023-10-23:
Make sure to open the controller app first and then connect to OpenBot by switching the controller mode to phone. If you're still facing issues, consider switching to a different device.

A-janjan, 2023-10-23:
It didn't work for 3 devices;  Are there any logs or things that can show me what happened backstage?

hardikgarg02, 2023-12-14:
Yes, When successful connection establishes, in robot app log appears  as  "Client connected: <IPv6 link-local address of wifi>".   And if there comes any error it shows "Got exception: <error> ".

abhijeetmhatre, 2024-01-10:
I am also facing the same issue.

The setup is pixel6a(controller) running a WiFi hotspot. Samsung Galaxy M31(robot) and also a laptop. Tried reversing the two phones. Also tried  third phone hosting the hotspot instead of one of the  two

 I am able to control the car using the python scripts. in laptop but not with the controller app.

M-S-10, 2024-02-21:
It works fine for me! Make sure that both the phones are on the same WiFi Network.

A-janjan, 2024-03-02:
Thanks

M-S-10, 2024-03-06:
Did it work? if yes then please close this issue.

A-janjan, 2024-03-07:
Yeah, but the main solution is changing the stream mode from RTSP to WebRTC. Thanks to all.

Closed 2024-03-07.

Thread 378 (2023-10-21):

Running without stopping

A-janjan, 2023-10-21:
When I go to the Robot info section and then click the forward or backward command in the send command section, I see that my motors start running without stopping. Additionally, when I click stop, nothing changes.

I use POCO X3 Pro.

hardikgarg02, 2023-11-02:
Please ensure that the app maintains a stable Bluetooth connection with the robot, without any disconnections between commands.

A-janjan, 2023-11-03:
No, I didn't use Bluetooth. I just used the main application and the following sections:

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

A-janjan, 2023-11-07:
I did the firmware testing with an Arduino serial monitor, and at first, I sent, for example, c100,100 and then the motors started running. but after I sent c0,0 and the motors didn't stop. I don't know why motors can't be stopped.

Eashika2504, 2023-12-15:
Ensure that your motor connections are accurate, and double-check that the specified serial pin numbers in the code align with the actual hardware configuration.

A-janjan, 2024-03-02:
ok

A-janjan, 2024-03-03:
After I sent a command via a serial monitor (e.g., c50,0), the motors moved correctly, but the serial connection disconnected, and I couldn't send a new command.

A-janjan, 2024-03-27:
The main problem arises when I enable #define HAS_OLED 1 in the DIY body firmware. Consequently, other commands fail to send correctly. However, after disabling the OLED, everything is fixed.

Closed 2024-05-08.

Thread 384 (2023-12-01):

I am unable to see ESP32 in the wiring diagram of DIY bot.

thawfeekahamed, 2023-12-01:
I am unable to see ESP32 in the wiring diagram of the DIY bot.
 Can do steps mentioned in the ESP32 be implemented circuit digram send it or any diy esp32 pcb circuit

Eashika2504, 2023-12-15:
As of now ESP32 in the wiring diagram of DIY bot is not available, you can see here the issue in reference to you: #295

thawfeekahamed, 2023-12-27:
esp32 the DIY bot working? Now.

lechfak, 2024-01-25:
> esp32 the DIY bot working? Now.

absolute not

Closed 2025-05-29.

Thread 385 (2023-12-06):

ObjectNavSegment control result should be mirrored when using front facing camera

yijunwu, 2023-12-06:
**Description**
Currently, in ObjectNavSegment, when using front facing camera of the phone, the vehicle's target control is incorrect. When the object is at the vehicle's left front, it turns to right, and vice versa. Currently, in order for the bot to do object nav correctly, one has to put the phone upside down, but consequently the controling UI is upside down too, which is inconvienient to use.

**To Reproduce**
Steps to reproduce the behavior:
1. With current release 0.7.1, let the phone screen facing to vehicle's front, and switch to front facing camera
2. Go to Object Tracking segment
3. Try object tracking
4. See error - control should be mirrored

**Expected behavior**
When the phone screen facing to vehicle's front, and using front facing camera, control target should be correct so that the bot can follow detected object.

**Smartphone:**
 - Device: some main stream phones, Samsung S20FE & Samsung A40S tested
 - OS: Android 10 & Android 13 tested
 - Version 0.7.1, master

**Suggested fix**
Fix should be easy, I'll create a pull request soon

yijunwu, 2023-12-06:
I've created a pull request ([386](https://github.com/isl-org/OpenBot/pull/386)) to fix this issue. I've tested the fix and it works.

Closed 2023-12-28.

Thread 399 (2024-02-29):

Error when training model

M-S-10, 2024-02-29:
**Describe the bug**
Failing to convert data to tfrecord

**To Reproduce**
Steps to reproduce the behavior:
1. Uploaded the sessions
2. Divided into training and testing
3. Started model training

**Expected behavior**
Initialization of model training

**Screenshots**
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

**Desktop (please complete the following information):**
 - OS: Windows 11
 - Browser : Any

**Additional context**
[conda_output_log.txt](https://github.com/isl-org/OpenBot/files/14444543/conda_output_log.txt)

Oops! Image D:/T-Works cannot be found.
TFRecord file created successfully.
broadcast message Loading data from tfrecord...
Number of training instances:  0
Number of test instances:  0
broadcast failed
Exception in callback _chain_future.<locals>._set_state(<Future pendi...tures.py:384]>, <Future at 0x...StopIteration>) at D:\mssha\Apps\Anaconda\envs\openbot\lib\asyncio\futures.py:378
handle: <Handle _chain_future.<locals>._set_state(<Future pendi...tures.py:384]>, <Future at 0x...StopIteration>) at D:\mssha\Apps\Anaconda\envs\openbot\lib\asyncio\futures.py:378>
Traceback (most recent call last):
  File "D:\mssha\Apps\Anaconda\envs\openbot\lib\asyncio\events.py", line 80, in _run
    self._context.run(self._callback, *self._args)
  File "D:\mssha\Apps\Anaconda\envs\openbot\lib\asyncio\futures.py", line 380, in _set_state
    _copy_future_state(other, future)
  File "D:\mssha\Apps\Anaconda\envs\openbot\lib\asyncio\futures.py", line 356, in _copy_future_state
    dest.set_exception(_convert_future_exc(exception))
TypeError: StopIteration interacts badly with generators and cannot be raised into a Future

M-S-10, 2024-03-03:
Running in C Drive now. TF Record files are getting created but another error at the next step.

M-S-10, 2024-03-03:
TFRecord file created successfully.
broadcast message Loading data from tfrecord...
Image shape:  (96, 256, 3)
Command:  0.0
Label:  [0.23529412 0.23529412]
Number of training instances:  28238
Number of test instances:  8671
broadcast preview None
broadcast failed [Errno 2] No such file or directory: 'C:\\Users\\mssha\\OpenBot\\policy\\models\\openbot_cil_mobile_lr0.0003_bz128_bn\\model.png'
Future exception was never retrieved
future: <Future finished exception=FileNotFoundError(2, 'No such file or directory')>
Traceback (most recent call last):
  File "D:\Anaconda\envs\openbot\lib\concurrent\futures\thread.py", line 58, in run
    result = self.fn(*self.args, **self.kwargs)
  File "C:\Users\mssha\OpenBot\policy\openbot\server\api.py", line 211, in train
    raise e
  File "C:\Users\mssha\OpenBot\policy\openbot\server\api.py", line 205, in train
    tr = start_train(params, my_callback)
  File "C:\Users\mssha\OpenBot\policy\openbot\train.py", line 624, in start_train
    do_training(tr, callback, verbose)
  File "C:\Users\mssha\OpenBot\policy\openbot\train.py", line 437, in do_training
    tf.keras.utils.plot_model(model, to_file=dot_img_file, show_shapes=True)
  File "D:\Anaconda\envs\openbot\lib\site-packages\keras\utils\vis_utils.py", line 440, in plot_model
    dot.write(to_file, format=extension)
  File "D:\Anaconda\envs\openbot\lib\site-packages\pydot\core.py", line 1663, in write
    with io.open(path, mode="wb") as f:
FileNotFoundError: [Errno 2] No such file or directory: 'C:\\Users\\mssha\\OpenBot\\policy\\models\\openbot_cil_mobile_lr0.0003_bz128_bn\\model.png'
Unregistering...
unhandled exception during asyncio.run() shutdown
task: <Task finished name='Task-3' coro=<_run_app() done, defined at D:\Anaconda\envs\openbot\lib\site-packages\aiohttp\web.py:287> exception=NameError("name 'info' is not defined")>
Traceback (most recent call last):
  File "D:\Anaconda\envs\openbot\lib\site-packages\aiohttp\web.py", line 429, in _run_app
    await asyncio.sleep(delay)
  File "D:\Anaconda\envs\openbot\lib\asyncio\tasks.py", line 652, in sleep
    return await future
asyncio.exceptions.CancelledError

During handling of the above exception, another exception occurred:

Traceback (most recent call last):
  File "D:\Anaconda\envs\openbot\lib\site-packages\aiohttp\web.py", line 431, in _run_app
    await runner.cleanup()
  File "D:\Anaconda\envs\openbot\lib\site-packages\aiohttp\web_runner.py", line 293, in cleanup
    await site.stop()
  File "D:\Anaconda\envs\openbot\lib\site-packages\aiohttp\web_runner.py", line 76, in stop
    await self._runner.shutdown()
  File "D:\Anaconda\envs\openbot\lib\site-packages\aiohttp\web_runner.py", line 369, in shutdown
    await self._app.shutdown()
  File "D:\Anaconda\envs\openbot\lib\site-packages\aiohttp\web_app.py", line 423, in shutdown
    await self.on_shutdown.send(self)
  File "D:\Anaconda\envs\openbot\lib\site-packages\aiohttp\signals.py", line 34, in send
    await receiver(*args, **kwargs)  # type: ignore
  File "C:\Users\mssha\OpenBot\policy\openbot\server\zeroconf.py", line 70, in on_shutdown
    await do_close(zc)
  File "C:\Users\mssha\OpenBot\policy\openbot\server\zeroconf.py", line 64, in do_close
    await zc.unregister_service(info)
NameError: name 'info' is not defined

Thread 401 (2024-03-08):

Problem in connection to node-js controller

A-janjan, 2024-03-08:
I have a problem connecting to the robot via the node-js controller in Ubuntu. I connected them to the same network but nothing happened. What should I do?

These are my terminal logs:

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

hardikgarg02, 2024-03-12:
On Connecting to phone, is web interface opening on the local ? And if not try to switch the control mode to phone.

A-janjan, 2024-06-03:
Ok, thanks.

Closed 2024-06-03.

Thread 405 (2024-03-16):

ESP32-S3 support

samuk, 2024-03-16:
**Is your feature request related to a problem? Please describe.**
I have a ESP32-S3 based robot that I'd like to use with openbot

**Describe the solution you'd like**
ESP32-S3 support is added

**Describe alternatives you've considered**
Using and alternate older MCU

**Additional context**
This is the desktop sized bot I'd like to use https://rosmo-robot.github.io/

marshalab, 2025-02-19:
https://github.com/ob-f/OpenBot/issues/455
Adding esp32-s3 can be easily done in the firmware. You need to start with defining the peripheral pin configuration #define. As far as I have studied the firmware, there is no difference between esp32 and esp32-s3.
The firmware code is not very readable, but the definitions are clearly written. You can copy the robot profile from the image and reassign the pins. True, the esp32 has some subtleties, not all pins can work as output. But since you have a working robot, the correct configuration has already been taken care of.

Thread 406 (2024-03-20):

OpenBot with Arduino Uno

devils13, 2024-03-20:
This is not about an issue but for seeking advice.

I bought a robot car off Aliexpress and its parts are very much over-lapped with OpenBot's except for Nano board. It has a Chinese UNO board. I would like to convert it to an OpenBot.

Just wondering if the code will work on the Uno board since Uno has less analogue pins. Do I need to change any codes e.g selecting UNO instead of NANO etc.

Thanks.

devils13, 2024-03-21:
I have almost zero knowledge on coding, but I can see the following lines in the firmware. It says 'Do not change' the definitions. So, if Uno works with the code can I leave the definition as is? Also, Uno only has A0 to A5. So, can I change it to A5 or something?

Line 36 #define NANO 328 //Atmega328p
....
Line 114 #define MCU NANO
....
Line 132 const int PIN_VIN = A7;

I ordered Nano boards in January and I still haven't got them. That's why I am trying it with Uno.

Closed 2024-03-21.

Thread 414 (2024-05-31):

Autopilot mode, switch Auto Mode, control_buttons display error

mixiaojiediy, 2024-05-31:
**Describe the bug**
In Autopilot, when I turn off Auto Mode, The Drive Mode of the control buttons is highlighted, but at this time it is in Phone mode.

hardikgarg02, 2024-06-18:
Hey @mixiaojiediy , created [PR](https://github.com/isl-org/OpenBot/pull/436) for this . Can you test and check for the bug.

Thread 432 (2024-06-17):

Upload error : exit status 2 on chip ESP32-D0WD-V3 (revision v3.0)

hexs00si, 2024-06-17:
**Describe the problem**
Despite the successful compilation of the given sketch , along with using the right board and port with all the compatible libraries , the sketch fails to be flashed on the firmware . It generates the following error message

```
Sketch uses 1038073 bytes (79%) of program storage space. Maximum is 1310720 bytes.
Global variables use 45708 bytes (13%) of dynamic memory, leaving 281972 bytes for local variables. Maximum is 327680 bytes.
esptool.py v4.6
Serial port /dev/cu.usbserial-210
Connecting....
Chip is ESP32-D0WD-V3 (revision v3.0)
Features: WiFi, BT, Dual Core, 240MHz, VRef calibration in efuse, Coding Scheme None
Crystal is 40MHz
MAC: 78:e3:6d:c6:93:40
Uploading stub...
Running stub...
Stub running...
Changing baud rate to 921600
Changed.

A fatal error occurred: Unable to verify flash chip connection (Invalid head of packet (0xE0): Possible serial noise or corruption.).
Failed uploading: uploading error: exit status 2**
A clear and concise description of what the problem is or what information you are looking for.

```
**To Reproduce**
Steps to reproduce the behaviour:
1. Go to tools and select your respective board , for me i chose the ESP32 Dev module
2. Select the appropriate port.
3. Verify your sketch , as well as the installed libraries.
4. Click on upload.

**Expected behavior**
The sketch should be successfully flashed to the connect esp32 chip.

**Desktop (please complete the following information):**
 - OS: [macOS sonoma14.5]
 - Arduino IDE [version 2.3.2]

hexs00si, 2024-06-17:
[433](https://github.com/isl-org/OpenBot/pull/433). Please review and merge

hemangjoshi37a, 2024-10-14:
I am getting this error in the serial console while uploading the default firmware to my esp32 devkit v1 :
```

17:29:17.656 -> rst:0x8 (TG1WDT_SYS_RESET),boot:0x13 (SPI_FAST_FLASH_BOOT)
17:29:17.656 -> configsip: 0, SPIWP:0xee
17:29:17.656 -> clk_drv:0x00,q_drv:0x00,d_drv:0x00,cs0_drv:0x00,hd_drv:0x00,wp_drv:0x00
17:29:17.656 -> mode:DIO, clock div:1
17:29:17.656 -> load:0x3fff0030,len:4832
17:29:17.656 -> load:0x40078000,len:16460
17:29:17.656 -> load:0x40080400,len:4
17:29:17.656 -> load:0x40080404,len:3504
17:29:17.656 -> entry 0x400805cc
17:29:18.399 -> ets Jul 29 2019 12:21:46
```

please help.

Thread 437 (2024-06-19):

Missing feature of scanning and connecting to a local WiFi network

hexs00si, 2024-06-19:
**Is your feature request related to a problem? Please describe.**
I am trying to connect the openBot to a local wifi network so that i can fetch parameters from different sensors , pins and send their respective values to a web app through http methods , but i am unable to do so as it is missing the **firmware** is missing the native feature or code to scan and connect to the local wifi network . It gets frustrating browsing multiple web pages to find the solution to include the wifi library and then code to get the desired result.

**Describe the solution you'd like**
A feature updated in the _**firmware**_ to scan , connect and disconnect from a wifi network of choice , Additional features such as checking the connection status and getting the IP address of the openbot connected.

**Describe alternatives you've considered**
No major alternatives , apart from continuously and recursively browse multiple web pages in order to implement the feature

**Additional context**
This could help developers seamlessly integrate any web related feature and even create web servers to feed their web applications with data readings or other bi-directional communication needs. Someone who is not well wersed with **Computer Networks** could make use of this feature to seamlessly develop web apps

hexs00si, 2024-06-19:
The following issue can be resolved using the library **<WiFi.h>** . The ESP32 board can act as _Wi-Fi Station, Access Point or both._
We would use our board as a **WiFi Station** for the following implementation
This can be implemented in the following manner :
```
#include "WiFi.h"

const char* ssid = "REPLACE_WITH_YOUR_SSID"; // Preferred network SSID
char password[50]; // Buffer to store user input for password

void setup() {
  Serial.begin(115200);

  // Set WiFi to station mode and disconnect from an AP if it was previously connected.
  WiFi.mode(WIFI_STA);
  WiFi.disconnect();
  delay(100);

  Serial.println("Setup done");

  // Scan for networks and check for the preferred network
  scanAndConnect();
}

void scanAndConnect() {
  Serial.println("Scan start");

  // WiFi.scanNetworks will return the number of networks found.
  int n = WiFi.scanNetworks();
  Serial.println("Scan done");

  bool ssidFound = false;

  if (n == 0) {
    Serial.println("no networks found");
  } else {
    Serial.print(n);
    Serial.println(" networks found");
    Serial.println("Nr | SSID                             | RSSI | CH | Encryption");

    for (int i = 0; i < n; ++i) {
      // Print SSID and RSSI for each network found
      Serial.printf("%2d", i + 1);
      Serial.print(" | ");
      Serial.printf("%-32.32s", WiFi.SSID(i).c_str());
      Serial.print(" | ");
      Serial.printf("%4ld", WiFi.RSSI(i));
      Serial.print(" | ");
      Serial.printf("%2ld", WiFi.channel(i));
      Serial.print(" | ");
      switch (WiFi.encryptionType(i)) {
        case WIFI_AUTH_OPEN:            Serial.print("open"); break;
        case WIFI_AUTH_WEP:             Serial.print("WEP"); break;
        case WIFI_AUTH_WPA_PSK:         Serial.print("WPA"); break;
        case WIFI_AUTH_WPA2_PSK:        Serial.print("WPA2"); break;
        case WIFI_AUTH_WPA_WPA2_PSK:    Serial.print("WPA+WPA2"); break;
        case WIFI_AUTH_WPA2_ENTERPRISE: Serial.print("WPA2-EAP"); break;
        case WIFI_AUTH_WPA3_PSK:        Serial.print("WPA3"); break;
        case WIFI_AUTH_WPA2_WPA3_PSK:   Serial.print("WPA2+WPA3"); break;
        case WIFI_AUTH_WAPI_PSK:        Serial.print("WAPI"); break;
        default:                        Serial.print("unknown");
      }
      Serial.println();

      // Check if the preferred network is found
      if (WiFi.SSID(i) == ssid) {
        ssidFound = true;
      }

      delay(10);
    }
  }

  Serial.println("");

  if (ssidFound) {
    Serial.print("Preferred network ");
    Serial.print(ssid);
    Serial.println(" found. Please enter the password:");

    while (!Serial.available()) {
      // Wait for user input
    }
    Serial.readBytesUntil('\n', password, sizeof(password));

    // Connect to the network
    connectToWiFi();
  } else {
    Serial.println("Preferred network not found. Please try again.");
  }

  // Delete the scan result to free memory.
  WiFi.scanDelete();
}

void connectToWiFi() {
  WiFi.mode(WIFI_STA);
  WiFi.begin(ssid, password);
  Serial.print("Connecting to WiFi ..");
  while (WiFi.status() != WL_CONNECTED) {
    Serial.print('.');
    delay(1000);
  }
  Serial.println("Connected to WiFi");
  Serial.print("IP address: ");
  Serial.println(WiFi.localIP());
}

void loop() {
  // Your main code here
}

```

Thread 440 (2024-07-01):

Unable to complile code for ESP32.

Getafix17, 2024-07-01:
I successfully compiled and uploaded the code to an Arduino Nano; however,, I am struggling to compile the code to ESP32.
I have included all the necessary libraries for ESP32 and BLE. I will be using an L298n an Android phone and a ESP32.
Perhaps I missed something.
My config for ESP32 in Arduino IDE:
//MCUs
 #define NANO 328 //Atmega328p
 #define ESP32 32 //ESP32

//Robot bodies with Atmega328p as MCU --> Select Arduino Nano as board
  #define DIY 0        // DIY without PCB
  #define PCB_V1 1     // DIY with PCB V1
  #define PCB_V2 2     // DIY with PCB V2
  #define RTR_TT 3     // Ready-to-Run with TT-motors
  #define RC_CAR 4     // RC truck prototypes
  #define LITE 5       // Smaller DIY version for education
//Robot bodies with ESP32 as MCU --> Select ESP32 Dev Module as board
  #define RTR_TT2 6   // Ready-to-Run with TT-motors
  #define RTR_520 7    // Ready-to-Run with 520-motors
  #define MTV 8        // Multi Terrain Vehicle
  #define DIY_ESP32 9  // DIY without PCB

//------------------------------------------------------//
// SETUP - Choose your body
//------------------------------------------------------//

// Setup the OpenBot version (DIY, PCB_V1, PCB_V2, RTR_TT, RC_CAR, LITE, RTR_TT2, RTR_520, DIY_ESP32,OPENBOT DIY)
#define OPENBOT DIY_ESP32

SETTINGS - Global settings
//------------------------------------------------------//

// Enable/Disable no phone mode (1,0)
// In no phone mode:
// - the motors will turn at 75% speed
// - the speed will be reduced if an obstacle is detected by the sonar sensor
// - the car will turn, if an obstacle is detected within TURN_DISTANCE
// WARNING: If the sonar sensor is not setup, the car will go full speed forward!
#define NO_PHONE_MODE 1

// Enable/Disable debug print (1,0)
#define DEBUG 1

// Enable/Disable coast mode (1,0)
// When no control is applied, the robot will either coast (1) or actively stop (0)
boolean coast_mode = 0;

My snippet for DIY ESP32
//-------------------------DIY_ESP32----------------------//
#elif (OPENBOT == DIY_ESP32)
const String robot_type = "DIY_ESP32";
#define MCU ESP32
#include <esp_wifi.h>
#define HAS_BLUETOOTH 1
#define analogWrite ledcWrite
#define attachPinChangeInterrupt attachInterrupt
#define detachPinChangeInterrupt detachInterrupt
#define digitalPinToPinChangeInterrupt digitalPinToInterrupt
#define PIN_PWM_L1 CH_PWM_L1
#define PIN_PWM_L2 CH_PWM_L2
#define PIN_PWM_R1 CH_PWM_R1
#define PIN_PWM_R2 CH_PWM_R2
#define HAS_VOLTAGE_DIVIDER 0
const float VOLTAGE_DIVIDER_FACTOR = (30 + 10) / 10;
const float VOLTAGE_MIN = 6.0f;
const float VOLTAGE_LOW = 9.0f;
const float VOLTAGE_MAX = 12.6f;
const float ADC_FACTOR = 3.3 / 4095;
#define HAS_INDICATORS 0
#define HAS_SONAR 0
#define SONAR_MEDIAN 0
#define HAS_SPEED_SENSORS_FRONT 0
//PWM properties
const int FREQ = 5000;
const int RES = 8;
const int CH_PWM_L1 = 0;
const int CH_PWM_L2 = 1;
const int CH_PWM_R1 = 2;
const int CH_PWM_R2 = 3;
const int PIN_PWM_LF1 = 13;
const int PIN_PWM_LF2 = 12;
const int PIN_PWM_LB1 = 13;
const int PIN_PWM_LB2 = 12;
const int PIN_PWM_RF1 = 27;
const int PIN_PWM_RF2 = 33;
const int PIN_PWM_RB1 = 27;
const int PIN_PWM_RB2 = 33;
const int PIN_SPEED_LF = 5;
const int PIN_SPEED_RF = 18;
const int PIN_VIN = 39;
const int PIN_TRIGGER = 25;
const int PIN_ECHO = 26;
const int PIN_LED_LI = 22;
const int PIN_LED_RI = 16;
#endif

 The error:
 Used: C:\Users\alexf\Documents\Arduino\libraries\ESP32_BLE_Arduino
 Not used: C:\Users\alexf\AppData\Local\Arduino15\packages\esp32\hardware\esp32\3.0.2\libraries\BLE
exit status 1
'ledcSetup' was not declared in this scope

thias15, 2024-07-01:
Try using version 2.x of Arduino-ESP32 since there were some [breaking changes](https://github.com/espressif/arduino-esp32/blob/master/docs/en/migration_guides/2.x_to_3.0.rst#ledc).

Closed 2024-07-01.

Thread 448 (2024-08-16):

Input 0 of layer "dense_3" is incompatible with the layer

sparta-2024, 2024-08-16:
**Describe the bug**
A clear and concise description of what the bug is.
    tf_results = model.predict(
                 ^^^^^^^^^^^^^^
  File "d:\Users\anaconda3\Lib\site-packages\tf_keras\src\utils\traceback_utils.py", line 70, in error_handler
    raise e.with_traceback(filtered_tb) from None
  File "C:\Users\dd\AppData\Local\Temp\__autograph_generated_filezo42g_5q.py", line 15, in tf__predict_function
    retval_ = ag__.converted_call(ag__.ld(step_function), (ag__.ld(self), ag__.ld(iterator)), None, fscope)
    ^^^^^
ValueError: in user code:

    File "d:\Users\anaconda3\Lib\site-packages\tf_keras\src\engine\training.py", line 2436, in predict_function  *
        return step_function(self, iterator)
    File "d:\Users\anaconda3\Lib\site-packages\tf_keras\src\engine\training.py", line 2421, in step_function  **
        outputs = model.distribute_strategy.run(run_step, args=(data,))
    File "d:\Users\anaconda3\Lib\site-packages\tf_keras\src\engine\training.py", line 2409, in run_step  **
        outputs = model.predict_step(data)
    File "d:\Users\anaconda3\Lib\site-packages\tf_keras\src\engine\training.py", line 2377, in predict_step
        return self(x, training=False)
    File "d:\Users\anaconda3\Lib\site-packages\tf_keras\src\utils\traceback_utils.py", line 70, in error_handler
        raise e.with_traceback(filtered_tb) from None
    File "d:\Users\anaconda3\Lib\site-packages\tf_keras\src\engine\input_spec.py", line 280, in assert_input_compatibility
        raise ValueError(

    ValueError: Exception encountered when calling layer 'pilot_net' (type Functional).

    Input 0 of layer "dense_3" is incompatible with the layer: expected axis -1 of input shape to have value 101, but received input with shape (None, 100)

    Call arguments received by layer 'pilot_net' (type Functional):
      • inputs=('tf.Tensor(shape=(None, 96, 256, 3), dtype=float32)', 'tf.Tensor(shape=<unknown>, dtype=float32)')
      • training=False
      • mask=None
**To Reproduce**
Steps to reproduce the behavior:
1. Go to '...'
2. Click on '....'
3. Scroll down to '....'
4. See error

**Expected behavior**
A clear and concise description of what you expected to happen.

**Screenshots**
If applicable, add screenshots to help explain your problem.

**Desktop (please complete the following information):**
 - OS: [e.g. Windows, Linux, iOS]
 - Browser [e.g. chrome, safari]
 - Version [e.g. 22]

**Smartphone (please complete the following information):**
 - Device: [e.g. Samsung S20]
 - OS: [e.g. Android 11]
 - Browser [e.g. stock browser, chrome]
 - Version [e.g. 0.1.1, master]

**Additional context**
Add any other context about the problem here.

isha382, 2024-08-21:
hi @sparta-2024, the issue is of the incompatibility with the version you can try with 2.9.0 version of tensorflow which is preferred version and can refer following documentation [policy](https://github.com/isl-org/OpenBot/blob/master/policy/README.md) for more information.

Closed 2025-02-03.

Thread 455 (2024-10-14):

getting this error in esp32

hemangjoshi37a, 2024-10-14:
```

17:28:34.751 -> rst:0x8 (TG1WDT_SYS_RESET),boot:0x13 (SPI_FAST_FLASH_BOOT)
17:28:34.751 -> configsip: 0, SPIWP:0xee
17:28:34.751 -> clk_drv:0x00,q_drv:0x00,d_drv:0x00,cs0_drv:0x00,hd_drv:0x00,wp_drv:0x00
17:28:34.784 -> mode:DIO, clock div:1
17:28:34.784 -> load:0x3fff0030,len:4832
17:28:34.784 -> load:0x40078000,len:16460
17:28:34.784 -> load:0x40080400,len:4
17:28:34.784 -> load:0x40080404,len:3504
17:28:34.784 -> entry 0x400805cc
17:28:35.526 -> ets Jul 29 2019 12:21:46
```

getting this error in esp32 by uploading the default firmware arduino file without any changes .

isha382, 2024-10-14:
Hi @hemangjoshi37a, You need to change this line  if (OPENBOT == DIY) to if(OPENBOT == DIY_ESP32) in the arduino file then you can upload.
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

hemangjoshi37a, 2024-10-14:
now i am getting this error :
```
/home/hemang/Documents/GitHub/OpenBot/firmware/openbot/openbot.ino: In function 'void setup()':
/home/hemang/Documents/GitHub/OpenBot/firmware/openbot/openbot.ino:906:3: error: 'ledcSetup' was not declared in this scope; did you mean 'ledc_stop'?
  906 |   ledcSetup(CH_PWM_L1, FREQ, RES);
      |   ^~~~~~~~~
      |   ledc_stop
/home/hemang/Documents/GitHub/OpenBot/firmware/openbot/openbot.ino:912:3: error: 'ledcAttachPin' was not declared in this scope; did you mean 'ledcAttach'?
  912 |   ledcAttachPin(PIN_PWM_LF1, CH_PWM_L1);
      |   ^~~~~~~~~~~~~
      |   ledcAttach

exit status 1

Compilation error: 'ledcSetup' was not declared in this scope; did you mean 'ledc_stop'?
```

hemangjoshi37a, 2024-10-14:
here is my final working code :
```c
#include <Arduino.h>
#include "driver/ledc.h"

const String robot_type = "DIY_ESP32";
// Required App Version: 0.7.0
// ---------------------------------------------------------------------------
// This Arduino Nano sketch accompanies the OpenBot Android application.
//
// The sketch has the following functionalities:
//  - receive control commands and sensor config from Android application (USB serial)
//  - produce low-level controls (PWM) for the vehicle
//  - toggle left and right indicator signals
//  - wheel odometry based on optical speed sensors
//  - estimate battery voltage via voltage divider
//  - estimate distance based on sonar sensor
//  - control LEDs for status and at front and back of vehicle
//  - send sensor readings to Android application (USB serial)
//  - display vehicle status on OLED
//
// Dependencies: Install via "Tools --> Manage Libraries" (type library name in the search field)
//  - Interrupts: PinChangeInterrupt by Nico Hood (read speed sensors and sonar)
//  - OLED: Adafruit_SSD1306 & Adafruit_GFX (display vehicle status)
//  - Servo: Built-In library by Michael Margolis (required for RC truck)
// Contributors:
//  - October 2020: OLED display support by Ingmar Stapel
//  - December 2021: RC truck support by Usman Fiaz
//  - March 2022: OpenBot-Lite support by William Tan
//  - May 2022: MTV support by Quentin Leboutet
//  - Jan 2023: BLE support by iTinker
// ---------------------------------------------------------------------------

// By Matthias Mueller, 2023
// ---------------------------------------------------------------------------

//------------------------------------------------------//
// DEFINITIONS - DO NOT CHANGE!
//------------------------------------------------------//

//MCUs
#define NANO 328 //Atmega328p
#define ESP32 32 //ESP32

//Robot bodies with Atmega328p as MCU --> Select Arduino Nano as board
#define DIY 0        // DIY without PCB
#define PCB_V1 1     // DIY with PCB V1
#define PCB_V2 2     // DIY with PCB V2
#define RTR_TT 3     // Ready-to-Run with TT-motors
#define RC_CAR 4     // RC truck prototypes
#define LITE 5       // Smaller DIY version for education
//Robot bodies with ESP32 as MCU --> Select ESP32 Dev Module as board
#define RTR_TT2 6   // Ready-to-Run with TT-motors
#define RTR_520 7    // Ready-to-Run with 520-motors
#define MTV 8        // Multi Terrain Vehicle
#define DIY_ESP32 9  // DIY without PCB

//------------------------------------------------------//
// SETUP - Choose your body
//------------------------------------------------------//

// Setup the OpenBot version (DIY, PCB_V1, PCB_V2, RTR_TT, RC_CAR, LITE, RTR_TT2, RTR_520, DIY_ESP32)
#define OPENBOT DIY_ESP32

//------------------------------------------------------//
// SETTINGS - Global settings
//------------------------------------------------------//

// Enable/Disable no phone mode (1,0)
// In no phone mode:
// - the motors will turn at 75% speed
// - the speed will be reduced if an obstacle is detected by the sonar sensor
// - the car will turn, if an obstacle is detected within TURN_DISTANCE
// WARNING: If the sonar sensor is not setup, the car will go full speed forward!
#define NO_PHONE_MODE 0

// Enable/Disable debug print (1,0)
#define DEBUG 0

// Enable/Disable coast mode (1,0)
// When no control is applied, the robot will either coast (1) or actively stop (0)
bool coast_mode = 1;

//------------------------------------------------------//
// CONFIG - update if you have built the DIY version
//------------------------------------------------------//
// HAS_VOLTAGE_DIVIDER                  Enable/Disable voltage divider (1,0)
// VOLTAGE_DIVIDER_FACTOR               The voltage divider factor is computed as (R1+R2)/R2
// HAS_INDICATORS                       Enable/Disable indicators (1,0)
// HAS_SONAR                            Enable/Disable sonar (1,0)
// SONAR_MEDIAN                         Enable/Disable median filter for sonar measurements (1,0)
// HAS_BUMPER                           Enable/Disable bumper (1,0)
// HAS_SPEED_SENSORS_FRONT              Enable/Disable front speed sensors (1,0)
// HAS_SPEED_SENSORS_BACK               Enable/Disable back speed sensors (1,0)
// HAS_SPEED_SENSORS_MIDDLE             Enable/Disable middle speed sensors (1,0)
// HAS_OLED                             Enable/Disable OLED display (1,0)
// HAS_LEDS_FRONT                       Enable/Disable front LEDs
// HAS_LEDS_BACK                        Enable/Disable back LEDs
// HAS_LEDS_STATUS                      Enable/Disable status LEDs
// HAS_BLUETOOTH                        Enable/Disable bluetooth connectivity (1,0)
// NOTE: HAS_BLUETOOTH will only work with the ESP32 board (RTR_TT2, RTR_520, MTV, DIY_ESP32)

// PIN_TRIGGER                          Arduino pin tied to trigger pin on ultrasonic sensor.
// PIN_ECHO                             Arduino pin tied to echo pin on ultrasonic sensor.
// MAX_SONAR_DISTANCE                   Maximum distance we want to ping for (in centimeters).
// PIN_PWM_T                            Low-level control of throttle via PWM (for OpenBot RC only)
// PIN_PWM_S                            Low-level control of steering via PWM (for OpenBot RC only)
// PIN_PWM_L1,PIN_PWM_L2                Low-level control of left DC motors via PWM
// PIN_PWM_R1,PIN_PWM_R2                Low-level control of right DC motors via PWM
// PIN_VIN                              Measure battery voltage via voltage divider
// PIN_SPEED_LB, PIN_SPEED_RB           Measure left and right back wheel speed
// PIN_SPEED_LF, PIN_SPEED_RF           Measure left and right front wheel speed
// PIN_LED_LB, PIN_LED_RB               Control left and right back LEDs (indicator signals, illumination)
// PIN_LED_LF, PIN_LED_RF               Control left and right front LEDs (illumination)
// PIN_LED_Y, PIN_LED_G, PIN_LED_B      Control yellow, green and blue status LEDs

//-------------------------DIY--------------------------//
#if (OPENBOT == DIY)
const String robot_type = "DIY";
#define MCU NANO
#define HAS_VOLTAGE_DIVIDER 0
const float VOLTAGE_DIVIDER_FACTOR = (20 + 10) / 10;
const float VOLTAGE_MIN = 2.5f;
const float VOLTAGE_LOW = 9.0f;
const float VOLTAGE_MAX = 12.6f;
const float ADC_FACTOR = 5.0 / 1023;
#define HAS_INDICATORS 0
#define HAS_SONAR 0
#define SONAR_MEDIAN 0
#define HAS_SPEED_SENSORS_FRONT 0
#define HAS_OLED 0
const int PIN_PWM_L1 = 5;
const int PIN_PWM_L2 = 6;
const int PIN_PWM_R1 = 9;
const int PIN_PWM_R2 = 10;
const int PIN_SPEED_LF = 2;
const int PIN_SPEED_RF = 3;
const int PIN_VIN = A7;
const int PIN_TRIGGER = 12;
const int PIN_ECHO = 11;
const int PIN_LED_LI = 4;
const int PIN_LED_RI = 7;

//-------------------------PCB_V1-----------------------//
#elif (OPENBOT == PCB_V1)
const String robot_type = "PCB_V1";
#define MCU NANO
#define HAS_VOLTAGE_DIVIDER 1
const float VOLTAGE_DIVIDER_FACTOR = (100 + 33) / 33;
const float VOLTAGE_MIN = 2.5f;
const float VOLTAGE_LOW = 9.0f;
const float VOLTAGE_MAX = 12.6f;
const float ADC_FACTOR = 5.0 / 1023;
#define HAS_INDICATORS 1
#define HAS_SONAR 1
#define SONAR_MEDIAN 0
#define HAS_SPEED_SENSORS_FRONT 1
#define HAS_OLED 0
const int PIN_PWM_L1 = 9;
const int PIN_PWM_L2 = 10;
const int PIN_PWM_R1 = 5;
const int PIN_PWM_R2 = 6;
const int PIN_SPEED_LF = 2;
const int PIN_SPEED_RF = 4;
const int PIN_VIN = A7;
const int PIN_TRIGGER = 3;
const int PIN_ECHO = 3;
const int PIN_LED_LI = 7;
const int PIN_LED_RI = 8;

//-------------------------PCB_V2-----------------------//
#elif (OPENBOT == PCB_V2)
const String robot_type = "PCB_V2";
#define MCU NANO
#define HAS_VOLTAGE_DIVIDER 1
const float VOLTAGE_DIVIDER_FACTOR = (20 + 10) / 10;
const float VOLTAGE_MIN = 2.5f;
const float VOLTAGE_LOW = 9.0f;
const float VOLTAGE_MAX = 12.6f;
const float ADC_FACTOR = 5.0 / 1023;
#define HAS_INDICATORS 1
#define HAS_SONAR 1
#define SONAR_MEDIAN 0
#define HAS_SPEED_SENSORS_FRONT 1
#define HAS_OLED 0
const int PIN_PWM_L1 = 9;
const int PIN_PWM_L2 = 10;
const int PIN_PWM_R1 = 5;
const int PIN_PWM_R2 = 6;
const int PIN_SPEED_LF = 2;
const int PIN_SPEED_RF = 3;
const int PIN_VIN = A7;
const int PIN_TRIGGER = 4;
const int PIN_ECHO = 4;
const int PIN_LED_LI = 7;
const int PIN_LED_RI = 8;

//-------------------------RTR_TT-----------------------//
#elif (OPENBOT == RTR_TT)
const String robot_type = "RTR_TT";
#define MCU NANO
#define HAS_VOLTAGE_DIVIDER 1
const float VOLTAGE_DIVIDER_FACTOR = (30 + 10) / 10;
const float VOLTAGE_MIN = 2.5f;
const float VOLTAGE_LOW = 9.0f;
const float VOLTAGE_MAX = 12.6f;
const float ADC_FACTOR = 5.0 / 1023;
#define HAS_INDICATORS 1
#define HAS_SONAR 1
#define SONAR_MEDIAN 0
#define HAS_BUMPER 1
#define HAS_SPEED_SENSORS_FRONT 1
#define HAS_SPEED_SENSORS_BACK 1
#define HAS_LEDS_FRONT 1
#define HAS_LEDS_BACK 1
#define HAS_LEDS_STATUS 1
const int PIN_PWM_L1 = 10;
const int PIN_PWM_L2 = 9;
const int PIN_PWM_R1 = 6;
const int PIN_PWM_R2 = 5;
const int PIN_SPEED_LF = A3;
const int PIN_SPEED_RF = 7;
const int PIN_SPEED_LB = A4;
const int PIN_SPEED_RB = 8;
const int PIN_VIN = A6;
const int PIN_TRIGGER = 4;
const int PIN_ECHO = 2;
const int PIN_LED_LI = A5;
const int PIN_LED_RI = 12;
const int PIN_LED_LB = A5;
const int PIN_LED_RB = 12;
const int PIN_LED_LF = 3;
const int PIN_LED_RF = 11;
const int PIN_LED_Y = 13;
const int PIN_LED_G = A0;
const int PIN_LED_B = A1;
const int PIN_BUMPER = A2;
const int BUMPER_NOISE = 512;
const int BUMPER_EPS = 10;
const int BUMPER_AF = 951;
const int BUMPER_BF = 903;
const int BUMPER_CF = 867;
const int BUMPER_LF = 825;
const int BUMPER_RF = 786;
const int BUMPER_BB = 745;
const int BUMPER_LB = 607;
const int BUMPER_RB = 561;

//-------------------------RC_CAR-----------------------//
#elif (OPENBOT == RC_CAR)
const String robot_type = "RC_CAR";
#define MCU NANO
#include <Servo.h>
Servo ESC;
Servo SERVO;
#define HAS_VOLTAGE_DIVIDER 0
const float VOLTAGE_DIVIDER_FACTOR = (20 + 10) / 10;
const float VOLTAGE_MIN = 0.0f;
const float VOLTAGE_LOW = 6.4f;
const float VOLTAGE_MAX = 8.4f;
const float ADC_FACTOR = 5.0 / 1023;
#define HAS_INDICATORS 0
#define HAS_SONAR 0
#define SONAR_MEDIAN 0
const int PIN_PWM_T = A0;
const int PIN_PWM_S = A1;
const int PIN_VIN = A7;
const int PIN_TRIGGER = 4;
const int PIN_ECHO = 4;
const int PIN_LED_LI = 7;
const int PIN_LED_RI = 8;

//-------------------------LITE-------------------------//
#elif (OPENBOT == LITE)
const String robot_type = "LITE";
#define MCU NANO
const float VOLTAGE_MIN = 2.5f;
const float VOLTAGE_LOW = 4.5f;
const float VOLTAGE_MAX = 5.0f;
#define HAS_INDICATORS 1
const int PIN_PWM_L1 = 5;
const int PIN_PWM_L2 = 6;
const int PIN_PWM_R1 = 9;
const int PIN_PWM_R2 = 10;
const int PIN_LED_LI = 4;
const int PIN_LED_RI = 7;

//-------------------------RTR_TT2----------------------//
#elif (OPENBOT == RTR_TT2)
const String robot_type = "RTR_TT2";
#define MCU ESP32
#include <esp_wifi.h>
#define HAS_BLUETOOTH 1
#define analogWrite ledcWrite
#define attachPinChangeInterrupt attachInterrupt
#define detachPinChangeInterrupt detachInterrupt
#define digitalPinToPinChangeInterrupt digitalPinToInterrupt
#define PIN_PWM_L1 CH_PWM_L1
#define PIN_PWM_L2 CH_PWM_L2
#define PIN_PWM_R1 CH_PWM_R1
#define PIN_PWM_R2 CH_PWM_R2
#define HAS_VOLTAGE_DIVIDER 1
const float VOLTAGE_DIVIDER_FACTOR = (30 + 10) / 10;
const float VOLTAGE_MIN = 6.0f;
const float VOLTAGE_LOW = 9.0f;
const float VOLTAGE_MAX = 12.6f;
const float ADC_FACTOR = 3.3 / 4095;
#define HAS_INDICATORS 1
#define HAS_SONAR 1
#define SONAR_MEDIAN 0
#define HAS_BUMPER 1
#define HAS_SPEED_SENSORS_FRONT 1
#define HAS_SPEED_SENSORS_BACK 1
#define HAS_LEDS_FRONT 1
#define HAS_LEDS_BACK 1
#define HAS_LEDS_STATUS 1
//PWM properties
const int FREQ = 5000;
const int RES = 8;
const int CH_PWM_L1 = 0;
const int CH_PWM_L2 = 1;
const int CH_PWM_R1 = 2;
const int CH_PWM_R2 = 3;
const int CH_LED_LF = 4;
const int CH_LED_RF = 5;
const int CH_LED_LB = 6;
const int CH_LED_RB = 7;
const int PIN_PWM_LF1 = 16;
const int PIN_PWM_LF2 = 17;
const int PIN_PWM_LB1 = 19;
const int PIN_PWM_LB2 = 18;
const int PIN_PWM_RF1 = 25;
const int PIN_PWM_RF2 = 26;
const int PIN_PWM_RB1 = 32;
const int PIN_PWM_RB2 = 33;
const int PIN_SPEED_LF = 21;
const int PIN_SPEED_RF = 35;
const int PIN_SPEED_LB = 23;
const int PIN_SPEED_RB = 36;
const int PIN_VIN = 39;
const int PIN_TRIGGER = 12;
const int PIN_ECHO = 14;
const int PIN_LED_LI = 22;
const int PIN_LED_RI = 27;
const int PIN_LED_LB = 22;
const int PIN_LED_RB = 27;
const int PIN_LED_LF = 4;
const int PIN_LED_RF = 13;
const int PIN_LED_Y = 0;
const int PIN_LED_G = 2;
const int PIN_LED_B = 15;
const int PIN_BUMPER = 34;
const int BUMPER_NOISE = 512;
const int BUMPER_EPS = 50;
const int BUMPER_AF = 3890;
const int BUMPER_BF = 3550;
const int BUMPER_CF = 3330;
const int BUMPER_LF = 3100;
const int BUMPER_RF = 2930;
const int BUMPER_BB = 2750;
const int BUMPER_LB = 2180;
const int BUMPER_RB = 2000;

//-------------------------RTR_520----------------------//
#elif (OPENBOT == RTR_520)
const String robot_type = "RTR_520";
#define MCU ESP32
#include <esp_wifi.h>
#define HAS_BLUETOOTH 1
#define analogWrite ledcWrite
#define attachPinChangeInterrupt attachInterrupt
#define detachPinChangeInterrupt detachInterrupt
#define digitalPinToPinChangeInterrupt digitalPinToInterrupt
#define PIN_PWM_L1 CH_PWM_L1
#define PIN_PWM_L2 CH_PWM_L2
#define PIN_PWM_R1 CH_PWM_R1
#define PIN_PWM_R2 CH_PWM_R2
#define HAS_VOLTAGE_DIVIDER 1
const float VOLTAGE_DIVIDER_FACTOR = (30 + 10) / 10;
const float VOLTAGE_MIN = 6.0f;
const float VOLTAGE_LOW = 9.0f;
const float VOLTAGE_MAX = 12.6f;
const float ADC_FACTOR = 3.3 / 4095;
#define HAS_INDICATORS 1
#define HAS_SONAR 1
#define SONAR_MEDIAN 0
#define HAS_BUMPER 1
#define HAS_SPEED_SENSORS_FRONT 1
#define HAS_SPEED_SENSORS_BACK 1
#define HAS_LEDS_FRONT 1
#define HAS_LEDS_BACK 1
#define HAS_LEDS_STATUS 1
//PWM properties
const int FREQ = 5000;
const int RES = 8;
const int CH_PWM_L1 = 0;
const int CH_PWM_L2 = 1;
const int CH_PWM_R1 = 2;
const int CH_PWM_R2 = 3;
const int CH_LED_LF = 4;
const int CH_LED_RF = 5;
const int CH_LED_LB = 6;
const int CH_LED_RB = 7;
const int PIN_PWM_LF1 = 16;
const int PIN_PWM_LF2 = 17;
const int PIN_PWM_LB1 = 19;
const int PIN_PWM_LB2 = 18;
const int PIN_PWM_RF1 = 26;
const int PIN_PWM_RF2 = 25;
const int PIN_PWM_RB1 = 33;
const int PIN_PWM_RB2 = 32;
const int PIN_SPEED_LF = 21;
const int PIN_SPEED_RF = 35;
const int PIN_SPEED_LB = 23;
const int PIN_SPEED_RB = 36;
const int PIN_VIN = 39;
const int PIN_TRIGGER = 12;
const int PIN_ECHO = 14;
const int PIN_LED_LI = 22;
const int PIN_LED_RI = 27;
const int PIN_LED_LB = 22;
const int PIN_LED_RB = 27;
const int PIN_LED_LF = 4;
const int PIN_LED_RF = 13;
const int PIN_LED_Y = 0;
const int PIN_LED_G = 2;
const int PIN_LED_B = 15;
const int PIN_BUMPER = 34;
const int BUMPER_NOISE = 512;
const int BUMPER_EPS = 50;
const int BUMPER_AF = 3890;
const int BUMPER_BF = 3550;
const int BUMPER_CF = 3330;
const int BUMPER_LF = 3100;
const int BUMPER_RF = 2930;
const int BUMPER_BB = 2750;
const int BUMPER_LB = 2180;
const int BUMPER_RB = 2000;

//---------------------------MTV------------------------//
#elif (OPENBOT == MTV)
const String robot_type = "MTV";
#define MCU ESP32
#include <esp_wifi.h>
#define HAS_BLUETOOTH 1
#define analogWrite ledcWrite
#define attachPinChangeInterrupt attachInterrupt
#define detachPinChangeInterrupt detachInterrupt
#define digitalPinToPinChangeInterrupt digitalPinToInterrupt
#define HAS_VOLTAGE_DIVIDER 0
const float VOLTAGE_MIN = 17.0f;
const float VOLTAGE_LOW = 20.0f;
const float VOLTAGE_MAX = 24.0f;
#define HAS_SPEED_SENSORS_FRONT 1
#define HAS_SPEED_SENSORS_BACK 1
#define HAS_SPEED_SENSORS_MIDDLE 1
#define HAS_INDICATORS 0
#define HAS_SONAR 0
#define SONAR_MEDIAN 0
#define HAS_BUMPER 0
#define HAS_LEDS_FRONT 0
#define HAS_LEDS_BACK 0
#define HAS_LEDS_STATUS 0
const int PIN_PWM_R = 19;
const int PIN_DIR_R = 18;
const int PIN_PWM_L = 33;
const int PIN_DIR_L = 32;

// Encoder setup:
const int PIN_SPEED_LF = 17;  // PIN_SPEED_LF_A = 17, PIN_SPEED_LF_B = 5
const int PIN_SPEED_RF = 14;  // PIN_SPEED_RF_A = 14, PIN_SPEED_RF_B = 13
const int PIN_SPEED_LM = 4;   // PIN_SPEED_LM_A = 4, PIN_SPEED_LM_B = 16
const int PIN_SPEED_RM = 26;  // PIN_SPEED_RM_A = 26, PIN_SPEED_RM_B = 27
const int PIN_SPEED_LB = 15;  // PIN_SPEED_LB_A = 15, PIN_SPEED_LB_B = 2
const int PIN_SPEED_RB = 35;  // PIN_SPEED_RB_A = 35, PIN_SPEED_RB_B = 25

// PWM properties:
const int FREQ = 5000;
const int RES = 8;
const int LHS_PWM_OUT = 0;
const int RHS_PWM_OUT = 1;

// //-------------------------DIY_ESP32----------------------//
// #elif (OPENBOT == DIY_ESP32)
// const String robot_type = "DIY_ESP32";
// #define MCU ESP32
// #include <esp_wifi.h>
// #define HAS_BLUETOOTH 1
// #define analogWrite ledcWrite
// #define attachPinChangeInterrupt attachInterrupt
// #define detachPinChangeInterrupt detachInterrupt
// #define digitalPinToPinChangeInterrupt digitalPinToInterrupt
// #define PIN_PWM_L1 CH_PWM_L1
// #define PIN_PWM_L2 CH_PWM_L2
// #define PIN_PWM_R1 CH_PWM_R1
// #define PIN_PWM_R2 CH_PWM_R2
// #define HAS_VOLTAGE_DIVIDER 1
// const float VOLTAGE_DIVIDER_FACTOR = (30 + 10) / 10;
// const float VOLTAGE_MIN = 6.0f;
// const float VOLTAGE_LOW = 9.0f;
// const float VOLTAGE_MAX = 12.6f;
// const float ADC_FACTOR = 3.3 / 4095;
// #define HAS_INDICATORS 1
// #define HAS_SONAR 1
// #define SONAR_MEDIAN 0
// #define HAS_SPEED_SENSORS_FRONT 1
// //PWM properties
// const int FREQ = 5000;
// const int RES = 8;
// const int CH_PWM_L1 = 0;
// const int CH_PWM_L2 = 1;
// const int CH_PWM_R1 = 2;
// const int CH_PWM_R2 = 3;
// const int PIN_PWM_LF1 = 13;
// const int PIN_PWM_LF2 = 12;
// const int PIN_PWM_LB1 = 13;
// const int PIN_PWM_LB2 = 12;
// const int PIN_PWM_RF1 = 27;
// const int PIN_PWM_RF2 = 33;
// const int PIN_PWM_RB1 = 27;
// const int PIN_PWM_RB2 = 33;
// const int PIN_SPEED_LF = 5;
// const int PIN_SPEED_RF = 18;
// const int PIN_VIN = 39;
// const int PIN_TRIGGER = 25;
// const int PIN_ECHO = 26;
// const int PIN_LED_LI = 22;
// const int PIN_LED_RI = 16;
// #endif
// //------------------------------------------------------//

#elif (OPENBOT == DIY_ESP32)

#define MCU ESP32
#include <esp_wifi.h>

#define HAS_BLUETOOTH 1
// Remove the following conflicting defines
// #define PIN_PWM_L1 CH_PWM_L1
// #define PIN_PWM_L2 CH_PWM_L2
// #define PIN_PWM_R1 CH_PWM_R1
// #define PIN_PWM_R2 CH_PWM_R2
// #define analogWrite ledcWrite
#define attachPinChangeInterrupt attachInterrupt
#define detachPinChangeInterrupt detachInterrupt
#define digitalPinToPinChangeInterrupt digitalPinToInterrupt
#define HAS_VOLTAGE_DIVIDER 1
const float VOLTAGE_DIVIDER_FACTOR = (30 + 10) / 10.0f;  // Ensure floating-point division
const float VOLTAGE_MIN = 6.0f;
const float VOLTAGE_LOW = 9.0f;
const float VOLTAGE_MAX = 12.6f;
const float ADC_FACTOR = 3.3 / 4095.0f;
#define HAS_INDICATORS 1
#define HAS_SONAR 1
#define SONAR_MEDIAN 0
#define HAS_SPEED_SENSORS_FRONT 1
// PWM properties
const int FREQ = 5000;
const int RES = 8;
const int CH_PWM_L1 = 0;
const int CH_PWM_L2 = 1;
const int CH_PWM_R1 = 2;
const int CH_PWM_R2 = 3;
const int PIN_PWM_LF1 = 13;
const int PIN_PWM_LF2 = 12;
const int PIN_PWM_LB1 = 13;
const int PIN_PWM_LB2 = 12;
const int PIN_PWM_RF1 = 27;
const int PIN_PWM_RF2 = 33;
const int PIN_PWM_RB1 = 27;
const int PIN_PWM_RB2 = 33;
const int PIN_SPEED_LF = 5;
const int PIN_SPEED_RF = 18;
const int PIN_VIN = 39;
const int PIN_TRIGGER = 25;
const int PIN_ECHO = 26;
const int PIN_LED_LI = 22;
const int PIN_LED_RI = 16;
#endif

#if (HAS_BLUETOOTH)
#include <BLEDevice.h>
#include <BLEServer.h>
#include <BLEUtils.h>
#include <BLE2902.h>

BLEServer *bleServer = NULL;
BLECharacteristic *pTxCharacteristic;
BLECharacteristic *pRxCharacteristic;
bool deviceConnected = false;
bool oldDeviceConnected = false;
const char *SERVICE_UUID = "61653dc3-4021-4d1e-ba83-8b4eec61d613";  // UART service UUID
const char *CHARACTERISTIC_UUID_RX = "06386c14-86ea-4d71-811c-48f97c58f8c9";
const char *CHARACTERISTIC_UUID_TX = "9bf1103b-834c-47cf-b149-c9e4bcf778a7";
#endif

enum msgParts {
  HEADER,
  BODY
};

msgParts msgPart = HEADER;
char header;
char endChar = '\n';
const char MAX_MSG_SZ = 60;
char msg_buf[MAX_MSG_SZ] = "";
int msg_idx = 0;

#if (HAS_BLUETOOTH)
void on_ble_rx(char inChar) {
  if (inChar != endChar) {
    switch (msgPart) {
      case HEADER:
        process_header(inChar);
        return;
      case BODY:
        process_body(inChar);
        return;
    }
  } else {
    msg_buf[msg_idx] = '\0';  // end of message
    parse_msg();
  }
}

//Initialization of classes for bluetooth
class MyServerCallbacks : public BLEServerCallbacks {
  void onConnect(BLEServer *bleServer, esp_ble_gatts_cb_param_t *param) {
    deviceConnected = true;

    // // Set the preferred connection parameters
    // uint16_t minInterval = 0; // Minimum connection interval in 1.25 ms units (50 ms)
    // uint16_t maxInterval = 800; // Maximum connection interval in 1.25 ms units (1000 ms)
    // uint16_t latency = 0;       // Slave latency
    // uint16_t timeout = 5000;     // Supervision timeout in 10 ms units (50 seconds)

    // bleServer->updateConnParams(param->connect.remote_bda, minInterval, maxInterval, latency, timeout);

    Serial.println("BT Connected");
  };

  void onDisconnect(BLEServer *bleServer) {
    deviceConnected = false;
    Serial.println("BT Disconnected");
  }
};

class MyCallbacks : public BLECharacteristicCallbacks {
  void onWrite(BLECharacteristic *pCharacteristic) {
    std::string bleReceiver = pCharacteristic->getValue().c_str();

    if (bleReceiver.length() > 0) {
      for (int i = 0; i < bleReceiver.length(); i++) {
        on_ble_rx(bleReceiver[i]);
      }
    }
  }
};
#endif

//------------------------------------------------------//
// INITIALIZATION
//------------------------------------------------------//
#if (NO_PHONE_MODE)
unsigned long turn_direction_time = 0;
unsigned long turn_direction_interval = 5000;
unsigned int turn_direction = 0;
int ctrl_max = 192;
int ctrl_slow = 96;
int ctrl_min = (int)255.0 * VOLTAGE_MIN / VOLTAGE_MAX;
#endif

#if (HAS_SONAR)
#if (MCU == NANO)
#include "PinChangeInterrupt.h"
#endif
// Sonar sensor
const float US_TO_CM = 0.01715;               //cm/uS -> (343 * 100 / 1000000) / 2;
const unsigned int MAX_SONAR_DISTANCE = 300;  //cm
const unsigned long MAX_SONAR_TIME = (long)MAX_SONAR_DISTANCE * 2 * 10 / 343 + 1;
const unsigned int STOP_DISTANCE = 10;  //cm
#if (NO_PHONE_MODE)
const unsigned int TURN_DISTANCE = 50;
unsigned long sonar_interval = 100;
#else
unsigned long sonar_interval = 1000;
#endif
unsigned long sonar_time = 0;
bool sonar_sent = false;
bool ping_success = false;
unsigned int distance = -1;           //cm
unsigned int distance_estimate = -1;  //cm
unsigned long start_time;
unsigned long echo_time = 0;
#if (SONAR_MEDIAN)
const unsigned int distance_array_sz = 3;
unsigned int distance_array[distance_array_sz] = {};
unsigned int distance_counter = 0;
#endif
#else
const unsigned int TURN_DISTANCE = -1;  //cm
const unsigned int STOP_DISTANCE = 0;   //cm
unsigned int distance_estimate = -1;    //cm
#endif

#if (HAS_OLED)
#include <SPI.h>
#include <Wire.h>
#include <Adafruit_GFX.h>
#include <Adafruit_SSD1306.h>

const int OLED_RESET = -1;  // not used
Adafruit_SSD1306 display(OLED_RESET);

// OLED Display SSD1306
const unsigned int SCREEN_WIDTH = 128;  // OLED display width, in pixels
const unsigned int SCREEN_HEIGHT = 32;  // OLED display height, in pixels
#endif

//Vehicle Control
int ctrl_left = 0;
int ctrl_right = 0;

#if (HAS_VOLTAGE_DIVIDER)
// Voltage measurement
unsigned int vin_counter = 0;
const unsigned int vin_array_sz = 10;
int vin_array[vin_array_sz] = { 0 };
unsigned long voltage_interval = 1000;  //Interval for sending voltage measurements
unsigned long voltage_time = 0;
#endif

#if (HAS_SPEED_SENSORS_FRONT or HAS_SPEED_SENSORS_BACK or HAS_SPEED_SENSORS_MIDDLE)
#if (OPENBOT == RTR_520)
// Speed sensor
// 530rpm motor - reduction ratio 19, ticks per motor rotation 11
// One revolution = 209 ticks
const unsigned int TICKS_PER_REV = 209;
#elif (OPENBOT == MTV)
// Speed sensor
// 178rpm motor - reduction ratio 56, ticks per motor rotation 11
// One revolution = 616 ticks
const unsigned int TICKS_PER_REV = 616;
#else
// Speed Sensor
// Optical encoder - disk with 20 holes
const unsigned int TICKS_PER_REV = 20;
#endif
// Speed sensor
const unsigned long SPEED_TRIGGER_THRESHOLD = 1;  // Triggers within this time will be ignored (ms)

volatile int counter_lf = 0;
volatile int counter_rf = 0;
volatile int counter_lb = 0;
volatile int counter_rb = 0;
volatile int counter_lm = 0;
volatile int counter_rm = 0;
float rpm_left = 0;
float rpm_right = 0;
unsigned long wheel_interval = 1000;  // Interval for sending wheel odometry
unsigned long wheel_time = 0;
#endif

#if (HAS_INDICATORS)
// Indicator Signal
unsigned long indicator_interval = 500;  // Blinking rate of the indicator signal (ms).
unsigned long indicator_time = 0;
bool indicator_left = 0;
bool indicator_right = 0;
#endif

#if (HAS_LEDS_FRONT || HAS_LEDS_BACK)
unsigned int light_front = 0;
unsigned int light_back = 0;
#endif

// Bumper
#if HAS_BUMPER
bool bumper_event = 0;
bool collision_lf = 0;
bool collision_rf = 0;
bool collision_cf = 0;
bool collision_lb = 0;
bool collision_rb = 0;
unsigned long bumper_interval = 750;
unsigned long bumper_time = 0;
const int bumper_array_sz = 5;
int bumper_array[bumper_array_sz] = { 0 };
int bumper_reading = 0;
#endif

//Heartbeat
unsigned long heartbeat_interval = -1;
unsigned long heartbeat_time = 0;

#if (HAS_OLED || DEBUG)
// Display (via Serial)
unsigned long display_interval = 1000;  // How frequently vehicle data is displayed (ms).
unsigned long display_time = 0;
#endif

//------------------------------------------------------//
// SETUP
//------------------------------------------------------//
void setup() {
#if (OPENBOT == LITE)
  coast_mode = !coast_mode;
#endif
  // Outputs
#if (OPENBOT == RC_CAR)
  pinMode(PIN_PWM_T, OUTPUT);
  pinMode(PIN_PWM_S, OUTPUT);
  // Attach the ESC and SERVO
  ESC.attach(PIN_PWM_T, 1000, 2000);    // (pin, min pulse width, max pulse width in microseconds)
  SERVO.attach(PIN_PWM_S, 1000, 2000);  // (pin, min pulse width, max pulse width in microseconds)
#endif
#if (MCU == NANO)
  pinMode(PIN_PWM_L1, OUTPUT);
  pinMode(PIN_PWM_L2, OUTPUT);
  pinMode(PIN_PWM_R1, OUTPUT);
  pinMode(PIN_PWM_R2, OUTPUT);
#endif
  // Initialize with the I2C addr 0x3C
#if (HAS_OLED)
  display.begin(SSD1306_SWITCHCAPVCC, 0x3C);
#endif
#if (HAS_INDICATORS)
  pinMode(PIN_LED_LI, OUTPUT);
  pinMode(PIN_LED_RI, OUTPUT);
#endif
#if (HAS_LEDS_BACK)
  pinMode(PIN_LED_LB, OUTPUT);
  pinMode(PIN_LED_RB, OUTPUT);
#endif
#if (HAS_LEDS_FRONT)
  pinMode(PIN_LED_LF, OUTPUT);
  pinMode(PIN_LED_RF, OUTPUT);
#endif
#if (HAS_LEDS_STATUS)
  pinMode(PIN_LED_Y, OUTPUT);
  pinMode(PIN_LED_G, OUTPUT);
  pinMode(PIN_LED_B, OUTPUT);
#endif
  // Test sequence for indicator LEDs
#if HAS_INDICATORS
  digitalWrite(PIN_LED_LI, LOW);
  digitalWrite(PIN_LED_RI, LOW);
  delay(500);
  digitalWrite(PIN_LED_LI, HIGH);
  delay(500);
  digitalWrite(PIN_LED_LI, LOW);
  digitalWrite(PIN_LED_RI, HIGH);
  delay(500);
  digitalWrite(PIN_LED_RI, LOW);
#endif
#if (HAS_SONAR)
  pinMode(PIN_ECHO, INPUT);
  pinMode(PIN_TRIGGER, OUTPUT);
#endif
#if (HAS_VOLTAGE_DIVIDER)
  pinMode(PIN_VIN, INPUT);
#endif
#if (HAS_BUMPER)

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

Thread 456 (2024-10-26):

error

Dinushan4568, 2024-10-26:
error Unable to open base configuration reference file '/Users/dinushanlakshitha/MyFirstRNProject/ios/Pods/Target Support Files/Pods-MyFirstRNProject/Pods-MyFirstRNProject.debug.xcconfig'. (in target 'MyFirstRNProject' from project 'MyFirstRNProject')
error Unable to load contents of file list: '/Target Support Files/Pods-MyFirstRNProject/Pods-MyFirstRNProject-frameworks-Debug-input-files.xcfilelist' (in target 'MyFirstRNProject' from project 'MyFirstRNProject')
error Unable to load contents of file list: '/Target Support Files/Pods-MyFirstRNProject/Pods-MyFirstRNProject-frameworks-Debug-output-files.xcfilelist' (in target 'MyFirstRNProject' from project 'MyFirstRNProject')
error Unable to load contents of file list: '/Target Support Files/Pods-MyFirstRNProject/Pods-MyFirstRNProject-resources-Debug-input-files.xcfilelist' (in target 'MyFirstRNProject' from project 'MyFirstRNProject')
error Unable to load contents of file list: '/Target Support Files/Pods-MyFirstRNProject/Pods-MyFirstRNProject-resources-Debug-output-files.xcfilelist' (in target 'MyFirstRNProject' from project 'MyFirstRNProject')
error Failed to build ios project. "xcodebuild" exited with error code '65'. To debug build logs further, consider building your app with Xcode.app, by opening 'MyFirstRNProject.xcodeproj'.

isha382, 2024-10-28:
Hi @Dinushan4568 , you can try configure your own independent account for building the app - iOS as shown in the below attachment.
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
please refer [ios support](https://github.com/isl-org/OpenBot/blob/master/ios/README.md) for more information

Closed 2024-11-24.

Thread 478 (2025-01-28):

Speed sensors issue.

tbellembois, 2025-01-28:
Hello,

I have an issue with my speed sensor. Only one reports speed for both right and left.
If I only run the left wheels the OLED display gives the same speed for both right and left wheels.
If I only run the right wheels the OLED display gives 0 rpm.

I have checked my wiring three times. I have tested with the Android application and Arduino console.

Desktop: linux Fedora 42
Smartphone: Sony xperia xa2 for the bot, Volla phone 22 for the controller

DIY version.

Here is my firmware configuration (relevant part only):
```
#define OPENBOT DIY
...
//-------------------------DIY--------------------------//
#if (OPENBOT == DIY)
const String robot_type = "DIY";
#define MCU NANO
#define HAS_VOLTAGE_DIVIDER 1
const float VOLTAGE_DIVIDER_FACTOR = (20 + 10) / 10;
const float VOLTAGE_MIN = 2.5f;
const float VOLTAGE_LOW = 9.0f;
const float VOLTAGE_MAX = 12.6f;
const float ADC_FACTOR = 5.0 / 1023;
#define HAS_INDICATORS 1
#define HAS_SONAR 1
#define SONAR_MEDIAN 0
#define HAS_SPEED_SENSORS_FRONT 1
#define HAS_OLED 1
const int PIN_PWM_L1 = 5;
const int PIN_PWM_L2 = 6;
const int PIN_PWM_R1 = 9;
const int PIN_PWM_R2 = 10;
const int PIN_SPEED_LF = 2;
const int PIN_SPEED_RF = 3;
const int PIN_VIN = A7;
const int PIN_TRIGGER = 12;
const int PIN_ECHO = 11;
const int PIN_LED_LI = 4;
const int PIN_LED_RI = 7;
```

Any idea? Thanks for your help.

tbellembois, 2025-01-29:
Update: after more tests the Arduino console reports correct values. This is an oled display issue.

tbellembois, 2025-01-29:
I found the issue, in the firmware file, line 1622:
```
String right_rpm_str = String("Right RPM:  ") + String(rpm_left, 0);
```
just replaced `rpm_left` with `rpm_left`.

thias15, 2025-01-29:
Thanks for finding this bug? 🐛 Do you mind raising a PR to fix it?

tbellembois, 2025-01-29:
Yes, I will do it.

tbellembois, 2025-01-30:
added: https://github.com/ob-f/OpenBot/pull/479

Closed 2025-01-30.

Thread 489 (2025-03-30):

Selecting AI TYPE for instance Point Goal using remote (PC/desktop) controller aka PYTHON/NPM PACKAGES....

vbot1983, 2025-03-30:
**Describe the problem**
A clear and concise description of what the problem is or what information you are looking for.

**To Reproduce**
Steps to reproduce the behavior:
1. Go to '...'
2. Click on '....'
3. Scroll down to '....'
4. See error

**Expected behavior**
A clear and concise description of what you expected to happen.

**Screenshots**
If applicable, add screenshots to help explain your problem.

**Desktop (please complete the following information):**
 - OS: [e.g. Windows, Linux, iOS]
 - Browser [e.g. chrome, safari]
 - Version [e.g. 22]

**Smartphone (please complete the following information):**
 - Device: [e.g. Samsung S20]
 - OS: [e.g. Android 11]
 - Browser [e.g. stock browser, chrome]
 - Version [e.g. 0.1.1, master]

**Additional context**
Add any other context about the problem here.

DKrishna007, 2025-04-06:
To dynamically control a robot’s navigation using a Raspberry Pi, you can set up a communication system (e.g., ROS, MQTT) where the Pi sends 2D waypoint data to the robot.

Setup Communication:

Use ROS if the robot supports it. The Pi sends waypoint data via a ROS topic, like this in Python:

rospy.init_node('waypoint_publisher')
pub = rospy.Publisher('/robot/goal', Pose2D, queue_size=10)
goal = Pose2D(x=2.0, y=3.0, theta=0.0)
pub.publish(goal)

Alternatively, use MQTT for lightweight messaging between the Pi and the robot.

Dynamic Waypoint Control:

The Raspberry Pi script can compute or receive waypoint updates dynamically (e.g., from sensors or Firebase) and publish them to the robot.

Adjust AI Parameters Dynamically:

If needed, modify AI navigation parameters (e.g., goal thresholds) via the same communication setup, allowing the robot to adapt to new commands in real-time.

If Firebase is part of your setup, you could read waypoint data from it and send it to the robot. Reaching out to the project's developers may provide more guidance on how to integrate this dynamically within their system.

Let me know if you'd like help with any part of this!

Thread 491 (2025-04-17):

Custom PCB link for RC car it's broken

www-dioda-ro, 2025-04-17:
I am trying to build the RC car Open Bot.
Link for OpenBot [custom PCB](https://github.com/ob-f/OpenBot/blob/master/body/pcb) it's broken . Please support were to find it.

Thank you !

thias15, 2025-04-17:
https://github.com/ob-f/OpenBot/tree/master/body/diy/pcb

Thread 492 (2025-05-26):

How to add new firmware board to OpenBot, USB Host permission can not be granted

BaoAn21, 2025-05-26:
**Describe the problem**
I have a ESP32 based board with different productID and vendorID, How to allow USB Host connection to this new board?.
I always got message "USB Host permission is required" even though I allow usb connection
Thank you

**Smartphone (please complete the following information):**
 - Device:Samsung A06
 - OS: Android 14

thias15, 2025-05-27:
Can you try to connect to the board via Bluetooth?

Closed 2025-09-10.
