ob-f/OpenBot/(commit log)

2026-07-22 Add HIGH_SAMPLING_RATE_SENSORS permission for ARCore on Android 12+
    Fixes ARCore crashes on some devices (Galaxy F41, S21 FE, S23 FE) during Point Goal Navigation.
2026-07-28 Add settings drawer and controller mode switching to Flutter controller (#464)
    - Add a settings drawer to the Flutter controller, with network
    server selection and switching between tilting-phone and
    on-screen driving modes.
    - Add FRAGMENT_TYPE status messaging so the controller knows which
    robot screen is active (autopilot, object detection, data
    collection, free roam) and disables network/data-collection
    controls accordingly.
    - Route FRAGMENT_TYPE through the existing status message envelope
    on Android, Flutter, and iOS for protocol consistency.
    - Rename Enums.fragmentType to FragmentType and remove dead code
    (unused Fragment import, no-op SharedPreferences persistence,
    dea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
2026-08-01 Add in-app language support with flag icons and Settings redesign (#526)
    In-app language picker (Settings → General → Language) using AndroidX's per-app
    language API, covering every README language (German, Spanish, French, Chinese,
    Korean) plus Hindi for India, with flag icons.
    - Decoupled home-screen tile display text from the internal navigation key so
    tile titles are properly translated
    - Translation quality fixes across all languages
    - Settings screen redesign: consistent icon-right row layout, section header
    alignment/sizing, spacing, and a proper icon set
    - Fixed permission toggles that always fell through to App Info instead of
    requesting directly on first ask
    - Added a mi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
    [ControlsFragment.java]
2026-08-11 Fix web controller reliability for iOS and Android (#529)
    [CameraActivity.java, ControlsFragment.java]
2026-09-25 Updated Android releases.yml for keystore and google-services secrets, along with 16 KB device compatibility. (#538)
    * updated releases.yml for keystore and google-services secrets
    * added signingConfigs
    * added after evaluate
    * added check for secrets
    * Fixed edge to edge screen layout and 16kb devices issue
    ---------
2026-10-05 Fix BLE transport initialization (#541)
    Initialize BLE once, select the official OpenBot UART characteristics, and gate writes on notification readiness. Clear UART state on disconnect or setup failure, identify BLE receive broadcasts correctly, and add regression tests and readiness logging.
    [BluetoothManagerTest.java, Vehicle.java]
2026-10-06 Update Flutter controller identifiers, assets, and video streaming (#539)
    Update Android and iOS controller identifiers, release signing documentation, iOS assets and deployment settings, and Flutter dependencies. Fix WebRTC track setup and streaming shutdown, add network permissions and Flutter Android CI, and retain Debug for the Xcode Run action.
2026-10-07 Fix camera frame release during analysis (#544)
2026-10-19 Firmware: Bluetooth gamepad control in no phone mode (#555)
    Drive ESP32 bodies with a Bluetooth gamepad (Bluepad32) in no phone mode.
    - HAS_GAMEPAD 1 needs NO_PHONE_MODE 1 and an ESP32 body.
    - Three drive modes (game, joystick, dual) and three speeds.
    - Start toggles explore (off at start), Select toggles the obstacle stop.
    - The robot stops when the gamepad disconnects or goes silent.
    - Battery limits are also sent over Bluetooth, so the app's gauge is
    right on 2S packs. Android: add the missing break when parsing vmin.
    - DIY_ESP32 motors moved off the ESP32 boot pins to GPIO 32/33 and
    25/26; the blue status LED moves from GPIO 26 to 13.
    - Motor pins are set up first in setup() on all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
2026-10-19 Firmware: detect the board, merge DIY_ESP32 into DIY (#556)
    The firmware now detects the board selected in the Arduino IDE instead
    of each robot body hard-coding it.
    - DIY works with an Arduino Nano or an ESP32 board. DIY_ESP32 is
    removed: use DIY and select an ESP32 board.
    - The other bodies support one board and stop with a clear error on
    the other, e.g. "PCB_V1 needs an Arduino Nano board."
    - The supported boards are listed in openbot.ino and in the firmware
    README (all languages).
    - CI compiles every body on every board it supports and checks the
    error on boards it doesn't.
2026-10-20 Fix Android robot video freezing in the phone controllers (#551)
    - Stream the camera preview's frames over WebRTC instead of opening
    the camera twice
    - Start a fresh call on every video restart; the Flutter controller
    replaces its peer connection on a new offer
    - Run signaling and teardown on the main thread and release all
    WebRTC resources
    - Mute button mutes audio only
2026-10-21 Move the robot apps into robot/
    - android/ → robot/android/ (module folder app/, still named :robot)
    - ios/ → robot/ios/
    - python/ → robot/linux/
    - Update build paths, CI workflows and doc links
2026-10-22 Firmware: settings at the top, body defaults, pin check (#557)
    - All settings in one section at the top of openbot.ino, optionally
    overridden by a git-ignored openbot_settings.h
    - Each part starts at the body's default; a table shows the defaults
    and CI checks it against the bodies
    - DIY: one parts list for Nano and ESP32; ESP32 indicators move to
    GPIO 16/17 so they no longer clash with the sonar
    - Build stops if two parts use the same pin
    - Startup line shows the body, the parts that are on and where the
    settings came from
    - ESP32: sonar echo pin uses the internal pull-down
    - Nano: speed sensors also work with the sonar off
    - Fix: ESP32 indicators only hand over the rear-light PWM w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
2026-10-23 Code fixes after the restructure (#561)
    - Drive mode: the app reads the robot's current drive mode, and keeps the
    one you chose when switching to phone or web control (redoes #498)
    - Linux robot: updated requirements (pandas, OpenVINO versions),
    test_infer.py finds the repo itself, README setup fixes
    - CI: Python 3.12 and JDK 17 for the new Ubuntu runners; firmware builds
    skip Markdown-only changes; controller release APK is ARM-only
    - .git-blame-ignore-revs hides the Java formatting commit from blame
2026-10-25 Docs: robot app page, missing translations, broken links (#562)
    - New robot app page (Android, iOS, Linux) in all six languages; the top
    README links to it
    - Added missing translations and completed out-of-date ones
    - Fixed broken links, section links and language switchers
    - Gamepad pairing tip in the firmware READMEs
    - Fixed setup steps (iOS pods, keystore paths, Windows path) and the
    French benchmark tables
2026-11-02 Start the apps without the project's Firebase configuration (#565)
    - The dummy `google-services.json` and `GoogleService-Info.plist` have the field lengths of real ones, so builds from source and PR builds no longer crash at startup
    - With the dummy config, the sign-in buttons on Profile and Projects (Android and iOS) explain that Google sign-in isn't set up in this build
2026-11-02 Firmware: setup page with flashing from the browser (#558)
    - tools.openbot.org/firmware flashes ready-made firmware for each body and
    board, or changes the battery, parts, driving mode and Bluetooth name with
    "Update settings only"
    - Settings are saved on the robot; parts that are off send no readings
    - ESP32 firmware has every part built in, with extras starting off; phone and
    no-phone mode share one build
    - DIY ESP32: right speed sensor on GPIO 39, right front light on GPIO 12,
    freeing 21/22 for the OLED
    - "Forget paired gamepads" clears stored pairings when flashing
    - Firmware CI runs as one job, checks that the ESP32 app fits its partition,
    and publishes the page
2026-11-14 Add OpenBot Compact body for ESP32 DevKit V1 + L298N (#552)
    - body/compact: four-wheel body for ESP32 DevKit V1 + L298N (DIY firmware).
    Studded lid, screwless ESP32 carrier and sonar mount, three battery options
    (2S/3S 18650 box, LiPo tray). All parts fit 180 x 180 mm; STL, STEP and a
    Bambu Studio project for the A1 mini.
    - Build guide in 6 languages: BOM, wiring (motors off the ESP32 boot pins,
    sonar ECHO 3.3 V note), firmware settings via the setup page, battery gauge
    limits (VOLTAGE_LOW / VOLTAGE_MAX), troubleshooting. Wiring diagram as SVG.
    - body/phone_mount: optional tilting phone holder (0/15/30 deg), default on
    Compact; existing parts re-exported in print orientation with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
